nathmo/running_robot/controller/fixed_gait/README.md

# fixed_gait — web control UI, teach/replay and workspace calibration

The hardware-side scripts for DASH-01. What runs on the robot today is the Flask web control UI in
[`webui/`](webui/README.md) (dashboard, balance loop, policy runs through `../deploy/`); the flat
scripts next to it are the numpy-only modules the UI imports, which also still work standalone from
a terminal on the Pi.

The original analytic in-air gait demo (`gait.py`, `run_hardware.py`, `sim_fixed_base.py`,
`validate_gait.py`, `view_trajectory.py`) was removed on 2026-09-30 — the web UI superseded it. It
lives in git history; comments that cite `run_hardware.py` refer to that version.

---

## Motor map

`can0` = **RIGHT** leg, `can1` = **LEFT** leg. CubeMars IDs on each bus:

| joint | role | motor ID | left bus | right bus | sim actuator |
| --- | --- | --- | --- | --- | --- |
| abduction | hip roll (lateral) — held at home for straight walking | **104** | can1 | can0 | `hip_roll_{L,R}` |
| cam | drives the knee through the parallel pushrod loop (leg extend/retract) | **105** | can1 | can0 | `cam_{L,R}` |
| hip | fore/aft thigh swing (the visible stepping motion) | **106** | can1 | can0 | `thigh_{L,R}` |

The knee and ankle are **passive** (parallel linkage + spring); they follow the cam and are not
commanded. The right leg is the geometric mirror of the left, so its joint signs are negated.

---
## Map the safe workspace (once, before running on real hardware)

The URDF/MJCF joint ranges for `cam` and `thigh` are CAD-derived guesses, not validated hardstops —
and worse, cam and thigh aren't independent: they drive a closed 4-bar loop through the passive
pushrod + knee, so only a thin, non-rectangular **band** of (cam, thigh) combinations is
mechanically assemblable (see `../model/plot_reachability.py`). A per-joint min/max box is provably
wrong for that pair. `calibrate_workspace.py` backdrives the real leg by hand and derives the safe
region straight from what you actually swept, instead of trusting the CAD ranges:

```bash
python fixed_gait/calibrate_workspace.py --leg left     # backdrive LEFT leg (can1), a few segments
python fixed_gait/calibrate_workspace.py --leg right    # backdrive RIGHT leg (can0)
```

Same limp-motor technique as the teach recorder below (`SET_CURRENT 0`, so you move the leg by
hand while positions are logged):

- **SPACE** — start/stop a recording segment. Move whatever you're calibrating through its FULL
  physical range during a segment — e.g. one segment sweeping abduction stop-to-stop, another
  sweeping the knee (cam+thigh together, hugging its limits AND wandering the interior). As many
  segments as you like.
- **z** — capture the current pose (all 3 raw motor angles) as this leg's zero reference (pose the
  leg at the same nominal stance you use as "home" elsewhere first). Only used for the origin
  marker / readable angles in the plot — the stored limits themselves are absolute raw motor
  degrees.
- **u** — undo the last segment, **q** — finish: saves raw samples, derives the safe workspace,
  and writes `fixed_gait/calibration/workspace_summary.png` (abduction range + a knee scatter plot
  showing the demonstrated (cam, thigh) samples and the derived safe region).

This produces `fixed_gait/calibration/joint_limits.npz`, loaded by `joint_limits.py` — a small
numpy-only module that `play_trajectory.py`, `record_trajectory.py` and the web UI all use
to reject/flag out-of-envelope motor angles. Re-tune the safety margin or grid resolution without
re-recording: `python fixed_gait/calibrate_workspace.py --process-only --margin-deg 4`. Try the
whole pipeline with fabricated data first (no hardware/CAN needed): `... --selftest`. Until you've
calibrated a leg, the other scripts run exactly as before (no calibration file = no check).

---
## CAN bring-up (Raspberry Pi)

```bash
pip install -r requirements-rpi.txt
sudo ip link set can0 up type can bitrate 1000000     # RIGHT leg
sudo ip link set can1 up type can bitrate 1000000     # LEFT leg
```

The CAN protocol (servo-mode `SET_POS`, big-endian int32 × 10000; `SET_CURRENT 0` to release) is
copied verbatim from the tested `tools/ak_servo_sweep.py`.

---

## Record & replay your own gait (teach mode)

You can **move the leg by hand** to teach a trajectory, then
play it back — starting slow and gentle, then faster/stronger. This path is safer for first
motion: the recorder never drives the motors, and the player has a hard torque (current) cap.

### 1. Record (motors stay limp — you backdrive them)

```bash
python fixed_gait/record_trajectory.py --leg right     # RIGHT leg (can0), a few takes
python fixed_gait/record_trajectory.py --leg left      # LEFT  leg (can1), a few takes
```

The three motors are held **limp** (`SET_CURRENT 0`) so you can move them by hand while positions
are logged. In the terminal:

- **SPACE** — start / stop a take. Move the leg through **one full cycle** (start pose → step →
  back to start). Do a few takes; they're averaged.
- **c** — capture the **current pose as this leg's center** (its origin / mid-stance, and the
  abduction hold angle). Pose the leg where you want the gait centered, then press `c` once — do
  this before or between takes, whenever the leg is sitting where you want "home" to be. If you
  never press it, the recording's own mean pose is used instead.
- **u** — undo the last take, **q** — finish.

If `fixed_gait/calibration/joint_limits.npz` exists (see "Map the safe workspace" above), the live
status line flags `⚠ OUTSIDE CALIBRATED WORKSPACE` when the pose you've backdriven to falls outside
it — informational only (the motors are limp here, nothing to abort), a nudge that you've pushed
past a previously-mapped stop.

You don't need to be precise — being off by a few cm/deg on the return is fine, the loop is
**closed for you**. The **abduction** motor (id 104) doesn't need to move; it's held at the
captured center. Each leg is recorded and processed **independently** — the two legs' motors have
different origins and don't move as a clean mirror of each other, so there's no cross-leg
alignment or sign-guessing; the left leg replays exactly what you taught it, in its own frame.

When both legs are recorded it **auto-smooths and exports**:
`trajectories/gait_recorded.npz` (+ a `gait_recorded.png` preview). Re-smooth anytime without
recording: `python fixed_gait/record_trajectory.py --process-only`. Useful flags:

- `--split 0.5` — the fraction of the cycle given to the "outbound" (hip-max → hip-min) arc,
  **shared by both legs**, so a step out and the return each take the same portion of the period on
  both legs, independent of how fast you happened to move your hand while teaching it.
- `--left-phase 0.5` — the left leg's dephase (0.5 = 180°); pass `0.0` if the legs should move
  together instead of alternating.

**What the smoothing does now** (`trajectory.py`): resamples each take to one cycle, finds that
leg's two turning points (hip max/min) and **re-times** the cycle so the outbound and return arcs
each fill a fixed share of the phase (`--split`) — this removes any timing quirks from your hand
speed while keeping the taught shape *within* each arc. Multiple takes of the same leg are averaged
(they land on the same phase grid automatically, anchored on the turning points), then FFT
low-pass smoothed and loop-closed. Each side keeps its **own** shape, center, and clip range —
nothing is shared or mirrored between legs except the timing schedule and the phase offset.

### 2. Play it back — two control modes (`--mode`)

| `--mode` | who runs the position loop | CAN command | torque cap | when |
| --- | --- | --- | --- | --- |
| `current` (default) | **Python PID on the Pi (200 Hz)** | `SET_CURRENT` | **yes** (`--current-limit`, A) | safe first motion, compliant |
| `position` | the **motor controller** | `SET_POS` | no (drive's preset only) | crisp tracking once you trust it |

```bash
# CURRENT mode (torque-limited PID, default):
python fixed_gait/play_trajectory.py --dry-run                                  # print targets, 0 A
python fixed_gait/play_trajectory.py --period 8 --current-limit 3 --kp 0.8 --ki 0.4 --log
python fixed_gait/play_trajectory.py --period 4 --current-limit 6 --kp 1.5 --ki 0.8 --kd 0.03

# POSITION mode (drive runs the loop — no kp/ki/kd/current-limit; a tracking-error guard applies):
python fixed_gait/play_trajectory.py --mode position --period 8 --log
python fixed_gait/play_trajectory.py --abduction-right 5 --abduction-left -3    # set abduction hold
```

Each motor runs a software **PID** loop whose output current is **hard-clamped to
`--current-limit`** (Amps — Kt/Nm isn't known exactly), so torque can never exceed it:

```
current = kp·err + ki·∫err + kd·(target_vel − actual_vel),   clamped to ±limit
```

- **`--kp`** — stiffness. *This is the "stricter tracking" knob.* Too low and the leg lags, then
  friction makes it stick-slip (jagged/twitchy) — which is what you saw (only ~2 A pulled even at a
  20 A limit). Raise `kp` until tracking is crisp.
- **`--ki`** — removes the steady lag from gravity/friction (integral, with anti-windup). No gravity
  feedforward yet; the integral does that job.
- **`--kd`** — damping; uses `target_vel − actual_vel` so it tracks the *moving* trajectory instead
  of braking against it. Add a little only if it oscillates.
- **`--period`** seconds per cycle (bigger = slower). **`--log`** saves a target-vs-actual +
  current plot (`trajectories/last_run.png/.npz`) — run it, look at the lag, adjust gains, repeat.

**Speed governor (no more runaway crashes).** Instead of hard-cutting at 5000 ERPM (which tripped
on a normal fast move), the controller now tapers the *accelerating* current as a motor nears
`--speed-limit` (default 9000 ERPM), so speed **saturates** there smoothly — braking current is
never limited. `--max-speed` (default 16000) is only a last-resort runaway net, well above the
governor. Raise `--speed-limit` to allow faster moves, lower it to keep things gentle; `--speed-limit 0`
disables the governor. The live readout shows `maxSpd` so you can see where you're running.

**Tuning recipe:** start `--kp 0.4 --ki 0 --kd 0 --period 10 --current-limit 3`; raise `kp` until
tracking is tight without buzzing; add `ki` to kill the remaining lag; add a touch of `kd` only if
it oscillates; then shorten `--period` and raise `--current-limit` for speed. Both legs run dephased
180°, soft-start from the current pose, release on Ctrl+C; guards cut on runaway/over-temp/error.

Every target is checked against `fixed_gait/calibration/joint_limits.npz` (see "Map the safe
workspace" above) before it's sent — `--no-workspace-check` disables that guard for a run
(debugging only; the other cuts above still apply).

---

## Files

| file | what |
| --- | --- |
| `webui/` | the Flask web control UI and its daemon — see [webui/README.md](webui/README.md). |
| `record_trajectory.py` | **teach recorder** — backdrive a leg by hand, SPACE-toggled takes; auto-smooths + exports. |
| `trajectory.py` | pure-numpy per-leg smoothing + shared-schedule re-timing + close-loop; independent per-side calibration (own shape, captured center, clip range); shared by record & play. |
| `play_trajectory.py` | **replay** a recorded trajectory, both legs dephased 180°; tunable current-**PID** with an Amp torque cap, `--log` tracking plot. |
| `calibrate_workspace.py` | backdrive a leg by hand to map its SAFE workspace (abduction min/max + a (cam,thigh) occupancy grid); exports `joint_limits.npz` + a summary plot. |
| `joint_limits.py` | pure-numpy safety-check module (loads `joint_limits.npz`); used by `play_trajectory.py`, `record_trajectory.py` and the web UI. |
| `trajectories/` | recorded takes + exported `gait_recorded.npz` (+ preview png, tracking logs). |
