nathmo/running_robot/controller/tools/README.md

sudo ip link set can0 up type can bitrate 1000000
sudo ip link set can1 up type can bitrate 1000000

to init CAN bus on raspberry pi

104 = abduction (polling 200Hz)
105 = cam
106 = hip

scp -r nemo@100.127.143.113:running_controller/fixed_gait* "C:\Users\Nathann\Downloads\running_robot\fixed_gait"
