nathmo/running_robot/controller/fixed_gait/webui/README.md

# DASH-01 web control interface

One Flask app, served **on the robot's Raspberry Pi**, reachable from any phone/laptop on the
robot's WiFi hotspot. No internet needed at runtime — every asset is served locally.

```
python controller/fixed_gait/webui/server.py          # real robot (socketcan can0/can1)
python controller/fixed_gait/webui/server.py --mock   # simulated motors — try the UI on any machine
python controller/fixed_gait/webui/server.py --port 8080 --host 0.0.0.0
```

Then browse to `http://<robot-ip>:8080/` (on the hotspot, the Pi's own address).

What it does (one page):

| Panel | Function |
|---|---|
| Telemetry | live raw/normalized position, current, temperature per motor + strip charts |
| Sense HAT (B) | live 9-DOF IMU (attitude horizon, accel/gyro/mag), air temperature/humidity/pressure, ambient light/colour, 4 analog inputs, and the **gyro calibration** (upright reference, gyro zero, a four-tilt axis sequence with flips, a still-robot noise recorder, 3D frame view) — see below |
| Calibration wizard | **blocks all motion after boot** until zero pose + direction check are done |
| Manual control | per-actuator slider that **tracks the live motor position** (grab to jog) + exact-angle box; **🏠 Home** slowly drives both legs to the **standing pose** (soles flat, CoM over them; `daemon.STAND_POSE_DEG`, from `tools/solve_stand_pose.py`) and **⌖ Centre** parks both legs where the safe workspace leaves the most room in every direction (the largest inscribed box — the pose to excite from); per-actuator sine (start↔stop **preset to 70% of the safe range**, frequency); workspace-override checkbox |
| ⚖ Balance | manual panel, after 🏠 Home: IMU loop around the standing pose (`balance.py`) — pitch P+D shift the CoM along the soles and I levels the torso, roll P+D shift the CoM sideways; CoM fore/aft + lateral trims; Stop holds, a >15° tilt goes limp. Tested in `tools/balance_sim.py` (MuJoCo, measured SET_POS lag): survives zero errors ~0.75° (vs 0.5° without) and 49 N side pushes (vs 45), but no posture loop beats ~8 N/0.2 s fore-aft on 66 mm soles |
| Safe workspace | abduction bar + (cam, thigh) pixel editor — draw/erase/flood-fill, undo, save/export/import |
| Gait trajectory | hand-**draw** a path, or **teach** by backdriving (record takes), smooth + save |
| Digital twin | the homing-pose MJCF rendered in the browser (WebGL), posed live from the six motors — backdrive the robot and the twin follows; also plays the gait preview, and a policy's dry run |
| Playback | position or torque-capped current mode, speed (period) + left/right dephasing live |
| E-STOP | header button (hotkey: Space) — streams zero current, latches until cleared |

## Why the calibration wizard exists

The CubeMars encoders report a **random angle (and possibly inverted direction) after every power
cycle**. The app therefore refuses any motion until you:

1. pose the robot in its **URDF zero pose** and press *Set zero* (motors are limp), then
2. backdrive each joint in its positive direction and *Confirm* (or *Flip*) its sign.

Everything the app stores (workspaces, gaits, zero) is in this **normalized frame**
(`norm = sign · (raw − offset)`), so recordings survive reboots. Legacy files from
`calibrate_workspace.py` are converted on import using the zero captured in their session
(`z` key) — files without a stored zero cannot be normalized and are refused.

After a **server** restart the calibration is restored from disk with a warning banner: it is only
valid if the motors were NOT power-cycled in between. Re-zero when unsure — it never invalidates
saved data.

## The digital twin (2026-09-21)

The panel draws `dash-01CAD/homing/SpiderBotInitPos/SpiderBotInitPos.xml`, the CAD exported in
the **homing pose the drives are zeroed in**. So the joint map has no offsets, only a sign per
motor: `qpos = radians(sign · norm°)`. Publish (or re-publish after a CAD change) from the desktop,
then copy to the Pi:

```
python controller/fixed_gait/webui/tools/build_twin.py        # -> static/twin/ (torso decimated, 7 MB)
scp -r controller/fixed_gait/webui/static/twin nemo@<pi>:running_robot/controller/fixed_gait/webui/static/
```

* **Parsed in the browser** (`static/twin3d.js`, no libraries): the XML is copied verbatim.
* **Signs** are derived from the wizard's convention (thigh + forward, cam + crank down, abduction
  + outward, both legs) and the MJCF axes: L abd/cam/thigh = +1/+1/−1, R = −1/−1/+1 (the right
  sagittal axes are −y). `tests/test_twinmap.py` re-derives them from the published XML. They
  can be overridden in the panel (`data/twin_map.json`, display only).
* **The four-bar.** The export duplicates one body per leg to express the loop; the deeper copy
  is dropped. The pin is 389.0 mm down the pushrod, which lands on the foot's bore at 0.00 mm
  lateral miss. It is solved in closed form, on the branch the CAD was assembled in. Homing is
  only 5 mm from full stretch (dead centre), so a zero that is a degree or two off can ask for a
  pose that doesn't exist. The leg then turns orange and draws its closest pose, and the gap is
  shown under the canvas.
* **The base follows the IMU** (pitch and roll from the attitude filter; yaw stays 0 because it
  drifts). It turns about the torso origin, which never moves, so the robot can only rotate
  against the fixed yellow world marker (level ring, plumb line, a ring at foot level) and the
  world triad; paler axes turn with the body. Needs a calibrated mount without a conflict, and
  can be switched off in the panel.
* **Three sources, in this order:** the gait preview (an explicit toggle, so it wins), then a
  **dry run**, then live telemetry. The line under the canvas names whichever is on screen.
* **A dry run moves it** (2026-09-23). A dress rehearsal runs the whole control law against a mock
  bus, so the robot stays limp and the live telemetry underneath is a still picture — the log tail
  used to be the only evidence it produced. `run_policy.py --pose-file` now publishes the
  **commanded** joint angles as JSON at 20 Hz, the server passes it on every rehearsal, and the
  panel polls `/api/policy/rehearse/pose` at 10 Hz and hands them here. What you see is the pose
  the policy is *asking for*, not what the mock drives report: the mock plant is a first-order lag
  with noise, the command is the thing under test. Nothing is energised; the base tilt is still the
  real IMU's. The poll self-schedules (a slow link lowers the frame rate instead of queueing
  requests), the pose is dropped once it is a second old, and the runner removes the file when the
  run ends. Off with **drive the digital twin** in the rehearsal row.

## The FK lookup table (workspace EE paths)

No longer drawn by the UI (the twin replaced the 2D linkage view); the server still uses it for
the gait files' `ee_path`. `fk_lut.npz` is generated **on the desktop** (needs mujoco, the Pi doesn't have it):

```
python mujoco/dash01/gen_fk_lut.py --check
```

It Newton-solves the closed 4-bar at every (cam, thigh) grid cell via
`mujoco/dash01/plot_reachability.py` and stores all linkage node positions. The Pi only
bilinearly interpolates it. After loading/importing a workspace, press **“verify FK map
(sign + offset)”** in the EE panel once: per side and per sign combination it FITS the offset
that lands the workspace band on the LUT assembly band (thin diagonal ⇒ sharp fit) and enables
the EE display per leg only when the winner is decisive.

> **Two zero poses — resolved (2026-07-11).** The robot's captured zero pose is NOT the model's
> qpos-0 pose, so the map is `model° = sign·norm° + offset°` per side. Two facts, both verified
> against recorded data:
> 1. **The cam is a crank.** The 4-bar assembles at EVERY cam angle (checked by sweeping loop
>    closure over the full circle); the MJCF's ±86° cam range is a CAD guess. The LUT is now
>    generated over cam ∈ [−90°, +270°] (`gen_fk_lut.py` default), which is why the old sign-only
>    verify failed (17% coverage): most of the real ~245° cam travel fell off the old grid.
> 2. **The captured zero sits far from model zero.** The zero pose is taken with the leg
>    near-extended — exactly the 4-bar dead-center, where big cam rotations barely move the leg —
>    so the captured cam zero is unrepeatable and lands far from model cam 0 (fitted ≈ +135° on
>    `joint_limits.npz`, both legs consistent, coverage 1.00 vs ≤0.95 for wrong signs). The EE
>    panel shows both: ○ = calibrated zero, ◆ = URDF/model zero.
>
> All recordings map onto the same model window (cam ≈ [−64°, +183°]) — that window is the real
> hard-stop travel expressed in model coordinates. `data/model_map.json` stores signs + offsets
> and can still be hand-edited / force-enabled in the UI.

## Drive control loops (read off the motor driver boards, 2026-08-04)

This app closes **no** control loop. `canio` speaks CubeMars servo mode — `SET_POS` and
`SET_CURRENT` only — so the drives close everything with their own three cascaded loops. These are
their configured gains, recorded in `dynstore.DRIVE_GAINS` and shipped with every measurement run so
a capture is self-describing. They are **not settable from here** (no gain-write packet; use the
CubeMars tool), and editing the PID table in the UI changes nothing on the robot.

| group | motors | current kp / ki | speed kp / ki | position kp / ki / kd |
|---|---|---|---|---|
| left sagittal | `left.cam`, `left.thigh` | 0.1255 / 1704.8199 | 0.002 / 0.1 | 0.003 / 0 / 0 |
| right sagittal | `right.cam`, `right.thigh` | 0.2066 / 2544.6150 | 0.002 / 0.1 | 0.003 / 0 / 0 |
| abduction | `left.abd`, `right.abd` | 0.1190 / 2290.1199 | 0.002 / 0.06 | 0.009 / 0 / 0 |

"Thigh+Knee" on the driver board is a leg's **sagittal pair**: the knee is driven by the cam through
the pushrod, so cam and thigh share a board and a tune. Left and right current-loop gains differ
despite identical AKE90-8 motors — that is per-board autotuning against the real winding R/L, not an
asymmetry in the robot.

Two consequences worth remembering when reading identification data:

* **The position loop is P-only** (ki = kd = 0 on all six). A pure proportional loop droops under a
  constant load, so a joint holding against gravity settles *short* of its target by roughly
  (gravity torque / gain). That is a systematic bias in a quasi-static run, not noise.
* **Abduction is ~3x stiffer** than the sagittal axes (kp 0.009 vs 0.003), so it droops ~3x less.

## Sense HAT (B) — the sensor panel

The Waveshare **Sense HAT (B)** sits on the Pi's 40-pin header and answers on **I2C bus 1**. The
chips are read by background threads of their own (`sensehat.py`), never by the Flask handlers and
never by the CAN daemon — an I2C stall must not be able to delay a motor command.

**Two threads, split by timescale.** The IMU polls at `--imu-hz` (200 by default, matching the
control loop); the air/pressure/light/ADC chips run at 1-5 Hz on a second thread. That split is not
tidiness: those drivers spend nearly all their time *asleep* waiting for a conversion (the SHTC3
alone sleeps 15 ms), which inline cost the fast loop ~43 ms every second — about 8 missed ticks —
and capped it at ~192 Hz. Out of the way, the IMU thread holds **199.5 Hz**.

| Address | Chip | Published |
|---|---|---|
| 0x68 | ICM-20948 | accel (g), gyro (deg/s), die temperature; magnetometer via the AK09916 at 0x0C |
| 0x70 | SHTC3 | air temperature, relative humidity |
| 0x5C | LPS22HB | barometric pressure + its own die temperature |
| 0x29 | TCS34725 | ambient light (lux), correlated colour temperature, raw RGBC |
| 0x48 | ADS1015 | AIN0..AIN3, volts (one channel per tick) |

Measured on the robot (100 kHz I2C, at rest, DLPF cfg 3):

| | accel | gyro |
|---|---|---|
| range / resolution | ±4 g, 0.1221 mg/LSB | ±1000 dps, 0.0305 dps/LSB |
| 3 dB bandwidth | 50.4 Hz | 51.2 Hz |
| noise (RMS) | 1.8 mg (~218 µg/√Hz) | 0.08 dps (~0.0096 dps/√Hz) |
| bias | scale error −0.03% | turn-on ~1 dps; 0.011 dps/s in-run |

Quantisation sits ~15x below the noise floor on both, so widening the ranges costs nothing real if
footfall impacts start clipping ±4 g. Sensor ODR is 225 Hz (`SMPLRT_DIV` derived from `ODR_HZ`); an
accel+gyro burst costs 1.68 ms and the magnetometer ~1 ms, hence the mag's decimation to 25 Hz.
The panel publishes the rate the IMU thread actually achieves, not the one it was asked for.

```
python controller/fixed_gait/webui/sensehat.py          # CLI self-test: one live line per second
python controller/fixed_gait/webui/sensehat.py --mock   # synthetic values, no hardware
python controller/fixed_gait/webui/server.py --no-sensors   # do not touch I2C at all
```

Things worth knowing before trusting a number here:

* **Roll and pitch are absolute** (a 6-axis Madgwick filter references them to gravity); **yaw is
  gyro-integrated and drifts.** The magnetometer is deliberately *not* fused into the attitude —
  it sits centimetres from two brushless motors and the battery, so its heading is published as an
  advisory number only.
* **Values are in the IMU chip's own frame until the mount is calibrated** (below), and in robot
  body axes after. The HAT is bolted UNDER the robot — it reads gravity on chip −Z — so the two
  frames are nowhere near each other and the difference is not cosmetic.
* Missing HAT, missing `smbus2`, or I2C disabled → the panel shows the reason and the rest of the
  UI is unaffected. Per-chip failures are counted and shown, not silent.

### Gyro calibration — upright, zero, axes, noise

`mountcal.py` (the frame, persisted to `data/sensehat_mount.json`) and `sensehat.py` (the captures,
the sequence and the recorder); panel block "IMU mount & frame". Every step that moves the frame is
refused while ⚖ Balance runs on it.

**Step 1 — upright reference.** Hang the robot on the test rig in its upright pose and capture.
This measures the direction of gravity in chip axes, which fixes the tilt. It does *not* separate
accelerometer bias from mount misalignment — a robot tilted 1° and a sensor with a 17 mg cross-axis
bias read identically — and it does not need to: both are absorbed into the frame in which the
reference pose reads roll = pitch = 0. **The repeatability of that pose is the accuracy ceiling of
everything downstream.**

**Step 2 — zero gyro.** Averages the zero-rate offset for 1.5 s with the robot still, and refuses
if it moved (it says so rather than storing a bad bias). Redo it once the robot is warm.

**Step 3 — axes: the tilt sequence.** Gravity fixes only *two* of the three rotation DOF: rotation
about the vertical is invisible to an accelerometer at rest, and that is exactly the DOF separating
**pitch from roll**. Press ▶ Start, then tilt the robot **forward, left, right, backward**, 10–20°
each and back upright in between. Each tilt is **captured on its own** (both hands are on the
robot): back within 4° of upright arms the next step, and a tilt of ≥ 8° held with the gyro under
2°/s for 0.3 s starts the usual 1.5 s still average. Each tilt gives one direction — the horizontal
swing of the up-vector — and only the direction is used, never the angle.

Four tilts over-determine the heading, so they check themselves:

* forward and backward must point opposite ways, so must left and right (a pair that points the
  *same* way was tilted wrong, and is left out of the fit);
* the fore/aft pair must sit at a right angle to the left/right pair **on the right-handed side**.

The panel then shows the result as chip axes (`forward = chip −X …`) with the per-tilt fit
residuals, and two **flip** buttons that negate what a pair is taken to mean. A rotation cannot flip
one horizontal axis alone — that would be a mirror — so flipping *one* pair of a good calibration
shows a **conflict** instead of silently averaging it: the fore/aft pair then sets the frame alone,
and ⚖ Balance is refused until the pairs agree again (flip the other one too: the robot's front was
the other end). Any single tilt can be redone with its ↻ button.

A calibration from the old one-tilt procedure keeps working: it is loaded as a forward tilt and the
panel says it is an old capture until the sequence is run.

**Step 4 — noise.** ● Record while the robot stands still, ■ Stop & analyse: accel and gyro noise
(RMS and density, using the chip's DLPF noise bandwidth), what is left of the gyro zero, the 1 s
wander, and the pitch/roll jitter the ⚖ Balance loop steers on. The record is judged by the same
stillness gate as `tools/imu_bench.py` (both use `imunoise.py`) and a record where the robot moved
is flagged as motion, not noise. The raw record goes to `data/imu_noise/imu_noise_*.npz` (same keys
as `imu_bench --save`, plus pitch/roll).

The 3D view shows the base mesh, the body triad and the chip's own axes as the calibration places
them, plus the live measured up-vector — the visual check that the calibration says what you think
it does. The **digital twin** tilts its base by the same pitch and roll (see *The digital twin*).

**Changing the mount resets the attitude filter.** A filter's quaternion is expressed in the frame
it was integrated in and is meaningless the moment that frame moves — and a near-antipodal Madgwick
error sits on a saddle where the correction vanishes, so it never converges out on its own. Without
the reset, finishing the wizard left the attitude stuck ~165° wrong.

In `--mock` the HAT is simulated with a known mount; the mock-tools panel poses it (upright, tilt
forward / left / right / backward), and the sequence recovers the mount (`tests/test_mountcal.py`).

(The lever-arm compensation — IMU offset from the base centre, CAD or fitted by rocking — was
removed on 2026-09-21: it was never configured on the robot.)

## Black box (flight recorder) — `blackbox.py` / `blackbox_read.py`

On 2026-08-10 a joint destroyed itself and the investigation was impossible: the only telemetry
that existed was a 4096-sample RAM ring at 20 Hz, of which the HTTP API can only ever hand out the
last 512 (25.6 s), and nothing on disk. By the time anyone looked the window had rolled past.

Everything now lands in `data/blackbox/`, always on, in three tiers — because 200 Hz x 6 motors
streamed continuously is 35 kB/s, 3 GB/day, and that kills the SD card:

| tier | what | rate | file |
|---|---|---|---|
| A | continuous history, every field | 20 Hz | `A_<session>_<n>_<stamp>.bbseg` (rotated, budgeted) |
| B | the actual black box: the full-rate RAM ring dumped on a trigger, **pre-trigger history included** | 200 Hz, 40 s ring + 3 s tail | `B_<session>_<n>_<reason>.bbdump` |
| C | one JSON line per event, `fsync`ed, never deleted without archiving | — | `events.jsonl` |

Tier B triggers: every `_trip()`, e-stop, mode transition, a *warn*-level tracking error / speed /
temperature (below the trip thresholds, so the dump catches the approach and not only the fall),
any motor error code, any calibration or `dynstore` write, an encoder-origin jump, and the manual
"dump now" endpoint. A dump carries the calibration + drive gains + dynamics live at that instant,
with a content hash, so it is self-describing without external context.

**The control loop is not touched.** The 200 Hz thread only appends a tuple to a bounded deque (no
lock, ~2 us); a separate writer thread owns every file. A full queue **drops and counts**, and the
count is stamped into the next accepted record — a black box that lies about its own gaps is worse
than none. If the writer thread dies the robot keeps running and `state.blackbox.alive` goes false
in the UI.

**Time.** The Pi has no RTC and serves an AP with no guaranteed internet, so `t_wall` can be years
wrong. Every record carries `t_mono` (the primary base), `t_wall`, `wall_trusted`, a per-boot
`boot_id` and a per-run `session_id`. A `clock.step` event records the jump when NTP finally syncs,
so earlier stamps can be retro-corrected. **Power-off is inferred from the last heartbeat** (every
8 s) before a gap — the process that dies with the power cannot log its own death.

**Disk.** A global byte budget (default 1.2 GB, `--blackbox-budget-mb`) plus a free-space floor.
Oldest Tier A segments are deleted first; Tier B dumps and the event log are the evidence and go
last. Every deletion is logged. A full SD card can never stop the robot.

### Reading it back

```
python controller/fixed_gait/webui/blackbox_read.py --postmortem      # the five questions, answered
python controller/fixed_gait/webui/blackbox_read.py --list
python controller/fixed_gait/webui/blackbox_read.py --timeline 80
python controller/fixed_gait/webui/blackbox_read.py --dump B_xxx.bbdump --csv out.csv
```

`--postmortem` answers, from disk alone: when the Pi booted and when it last lost power; what
`pos_raw` was at the last zero capture versus now; commanded vs reported position per motor at
200 Hz for >= 10 s *before* a trip; which calibration / drive PID gains / dynamics were live at
that instant; and whether `pos_raw` ever moved while the robot was LIMP and untouched.

Over HTTP: `GET /api/blackbox/list`, `GET /api/blackbox/download?name=`,
`POST /api/blackbox/mark` (operator annotation — it lands on the same timeline) and
`POST /api/blackbox/dump`. Downloads are plain reads of append-only files, so they never block the
daemon.

### The pre-move guard

The 2026-08-10 damage was a full-authority absolute slew against a calibration whose raw origin had
moved underneath it. Four mechanisms now bound that, and **none of them adds a step to the normal
zero -> Home workflow** — homing straight after a capture is the correct operator action, because
the legs are limp and sagging and homing is what catches them:

a. **Hold before moving.** The first CAN command after leaving LIMP is `set_pos(pos_raw measured
   right now)`, held for 0.35 s. It never consults the offsets, so it is safe even against a
   completely wrong zero, and it stops the sag immediately.
b. **Raw-at-rest.** `pos_raw` is compared against the fingerprint captured at the last zero.
   Decisive when we cannot vouch for continuity ourselves — a calibration restored from disk and
   never re-captured in this process, i.e. after a power cycle, where the drives re-randomise their
   raw origin. Within a live session the continuity watchdog is used instead, because gravity sag
   legitimately moves the joints and must not be mistaken for an origin jump. Plus a range-sanity
   check that is decisive in every case: 678 deg on a +-88 deg axis is refused.
c. **A tighter tracking threshold while homing** (8 deg, not the 25 deg playback value): a slow
   guided slew should track well, so a stale zero shows up within the first few degrees.
d. **A per-joint travel budget** as the backstop: a guided move that has swept more than 1.3x the
   joint's own range without arriving is stopped. `left.cam` reached ~1.9 output turns on
   2026-08-10; this cuts it at ~0.6 of a turn whatever the calibration claims.

A refusal is latched, surfaced in `state.premove` with both raw poses, logged, and dumped.

### Tests

```
python -m pytest controller/fixed_gait/webui/tests -v
```

MockBus only, no hardware. The last test reproduces the 2026-08-10 incident shape end to end:
capture a zero, move the raw origin underneath the daemon (`MockBus.shift_origin`, which shifts the
reported *and* commanded frame while the shaft stays put and reports zero speed), command an
absolute move — and asserts the guard refuses it, the event carries both raw poses, the dump holds
>= 10 s of pre-trigger 200 Hz data, and `--postmortem` states what happened.

## Install on the Pi (offline)

```
# on the desktop (internet):
pip download flask smbus2 -d wheels/
scp -r wheels nemo@<pi>:running_robot/

# on the Pi:
pip install -r requirements-rpi.txt          # if not already there (numpy, python-can)
pip install --no-index --find-links wheels/ flask smbus2
# smbus2 is pure Python, so if Raspberry Pi OS already ships it system-wide you can instead just
# drop it into the venv:  cp -r /usr/lib/python3/dist-packages/smbus2 .venv/lib/python3*/site-packages/
sudo ip link set can0 up type can bitrate 1000000
sudo ip link set can1 up type can bitrate 1000000
python controller/fixed_gait/webui/server.py
```

### Run at boot (two systemd units)

Bringing CAN up needs root (`CAP_NET_ADMIN`); the web UI does not. Splitting them keeps the
app running as the unprivileged `nemo` user, and keeps the interfaces up even if the app
restarts. **One** unit brings CAN up (root, oneshot), the **other** starts the UI (as `nemo`)
and waits for the first.

**1. CAN bring-up — `/etc/systemd/system/can-up.service`** (runs as root; no `User=`):

```
[Unit]
Description=Bring up CAN interfaces (can0/can1)
After=sys-subsystem-net-devices-can0.device

[Service]
Type=oneshot
RemainAfterExit=yes
ExecStart=/sbin/ip link set can0 up type can bitrate 1000000
ExecStart=/sbin/ip link set can1 up type can bitrate 1000000

[Install]
WantedBy=multi-user.target
```

**2. Web UI — ship the unit that is in the repo**, `systemd/runningrobot-webui.service`. It is
version-controlled precisely because the only surviving record of 2026-08-10 was a terminal that
happened to still be open; a hand-started process has no journal and no restart.

```
sudo cp controller/fixed_gait/webui/systemd/runningrobot-webui.service /etc/systemd/system/
```

It runs as `nemo`, waits for `can-up.service`, sets `PYTHONUNBUFFERED=1` so the journal never loses
the last lines before a crash, restarts always (bounded to 5 restarts / 60 s so a boot loop stays
down visibly instead of power-cycling the motors), and stops with `SIGINT` so `atexit` runs — that
is what streams 0 A to every motor and lets the black box write its clean `daemon.stop` record,
whose ABSENCE is how a postmortem infers a power cut.

Note `ExecStart` uses the venv's Python by absolute path — systemd runs no shell, so it won't
find `python` on `PATH` or activate a venv. Enable both:

```
sudo systemctl daemon-reload
sudo systemctl enable --now can-up.service runningrobot-webui.service
ip -details link show can0                     # confirm state UP, bitrate 1000000
systemctl status runningrobot-webui         # confirm active (running)
journalctl -u runningrobot-webui -f         # live logs
```

> Don't put `ip link set` in the webui unit's `ExecStartPre`: that step would run as `nemo` and
> fail with `RTNETLINK answers: Operation not permitted`. If you must keep it in one unit, run
> just that line elevated with the `+` prefix (`ExecStartPre=+-/sbin/ip link set can0 up …`).

## First hardware bring-up (in this order)

1. Legs held by hand: press **E-STOP**, verify motors are limp; clear it.
2. Unplug one motor: the app must flag it silent and refuse all motion.
3. Run the calibration wizard for real; sanity-check a normalized angle with a protractor.
4. Import yesterday's workspace (`fixed_gait/joint_limits_right_2.npz`) in the workspace panel.
5. Press *verify FK map (sign + offset)* — both legs should be decisive; the EE panels light up.
6. Small manual moves near zero with safety checks ON (override OFF). The sliders track the live
   position, so watch a joint follow your drag; then press **🏠 Home** and confirm all six slew
   back to zero at the (slow) home speed. Homing trusts the CAD zero: it slews under the physical
   feasibility net rather than the eroded gait polygon, so it still reaches 0 when 0 sits a degree
   or so outside the hand-drawn safe region (a plain manual hold at zero is refused there).
7. Record a workspace sweep + a gait via the UI; play it back slow in **position** mode
   (period ≥ 10 s), then try **current** mode with the 3 A default.

## Architecture (for maintenance)

**Two processes since 2026-08-19.** `server.py` (control, `:8081`) owns the daemon, CAN,
calibration and the black box. `uiproc.py` (front end, `:8080`) serves the browser and proxies
everything it does not build itself. They are separate *processes*, not threads, because the
problem was the GIL: measured with candump, the motors' own status frames arrived at 200.1 Hz with
0.04 ms jitter while the Pi's own transmit stream managed 156.6 Hz and dropped 21.6% of its slots —
stalls of >10 ms at 9.16/s against a browser polling at 9.1/s, one per request. `setswitchinterval`
was already 0.5 ms and `SCHED_FIFO` cannot preempt a thread holding the lock you need, so a second
interpreter was the only fix. `uiproc.py` carries the full measurement in its docstring.

Operator URL is unchanged (`:8080`). **If the front end dies, the whole UI including E-STOP is
still on `:8081`.** Running `server.py --port 8080` alone is the rollback and needs no code change.

- `daemon.py` — the only thread touching CAN (200 Hz; mirrors `play_trajectory.py`'s loop).
  Limp/e-stop = **streaming** `SET_CURRENT 0` (never just "stop sending"). All targets are
  workspace-checked as a full pose *before anything is sent*.
- `calibration.py` — normalized↔raw conversion at the daemon boundary only; legacy converters.
- `workspace.py` / `gaitstore.py` — normalized-frame stores wrapping `calibrate_workspace.py`,
  `joint_limits.py`, `trajectory.py` (files stay compatible with the CLI tools).
- `fklut.py` — pure-numpy LUT runtime + the sign-map verifier.
- `canio.py` — real socketcan or `--mock` simulated motors (random boot offsets included).
- `sensehat.py` — Sense HAT (B) I2C drivers + its own poll thread (100 Hz IMU / 20 Hz logged);
  `--mock` simulates a HAT with a known mount, posed upright or tilted. Also runs the auto-capturing
  tilt sequence and the noise recorder. Publishes a snapshot + a `ScalarRing`, same
  read-by-sequence contract as motor telemetry.
- `mountcal.py` — IMU mount rotation from the upright capture and the four tilts (fit, pair checks,
  flips), persisted to `data/sensehat_mount.json`. No I2C, no threads of its own.
- `imunoise.py` — the stillness gate and the noise analysis, shared by the panel's recorder and
  `tools/imu_bench.py`.
- `static/` — vanilla JS, no CDN. `server.py` — thin Flask routes.
- Runtime data lives in `webui/data/` (git-ignored, machine-local).
