nathmo/running_robot/controller/batterypackLayout.png

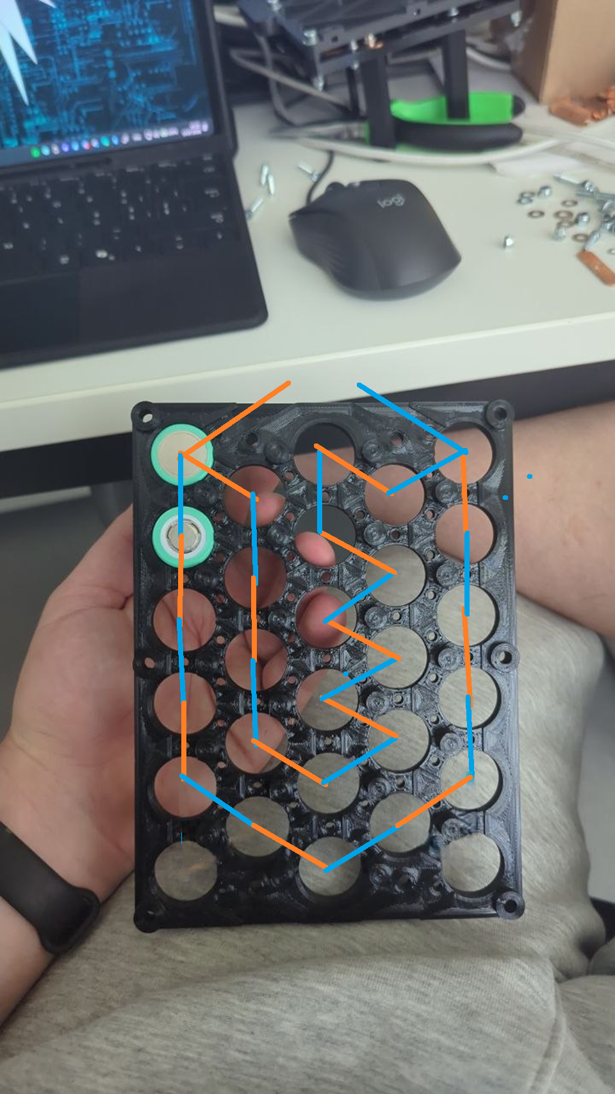
controller/batterypackLayout.png
