nathmo/running_robot/controller/fixed_gait/trajectories/gait_recorded.png

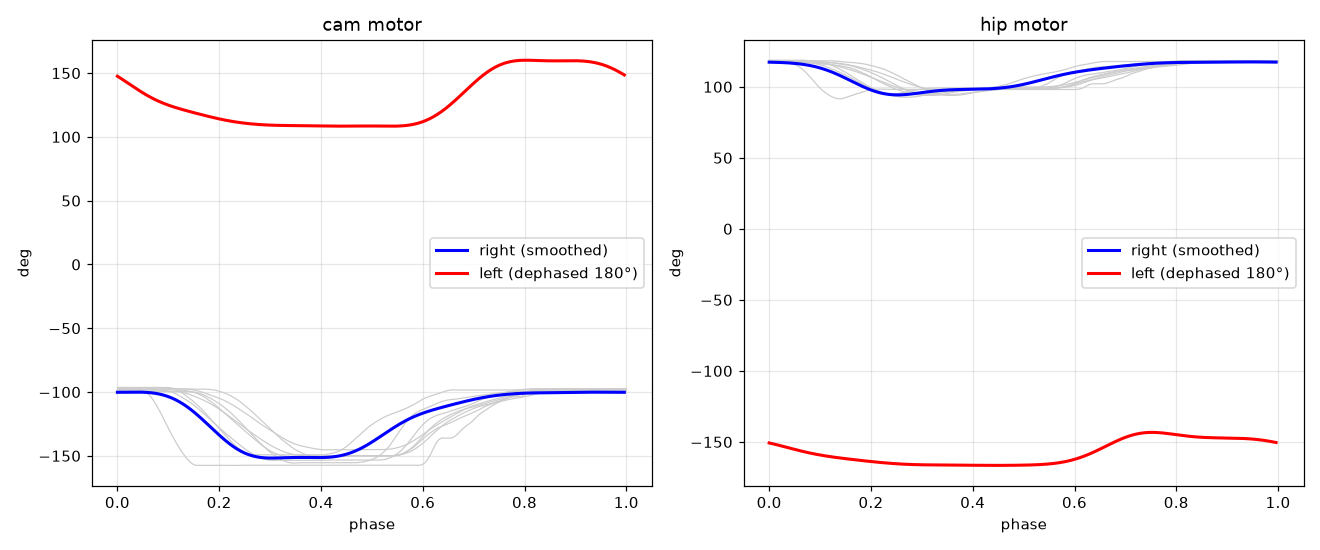
controller/fixed_gait/trajectories/gait_recorded.png
