nathmo/running_robot/controller/fixed_gait/trajectories/last_run.png

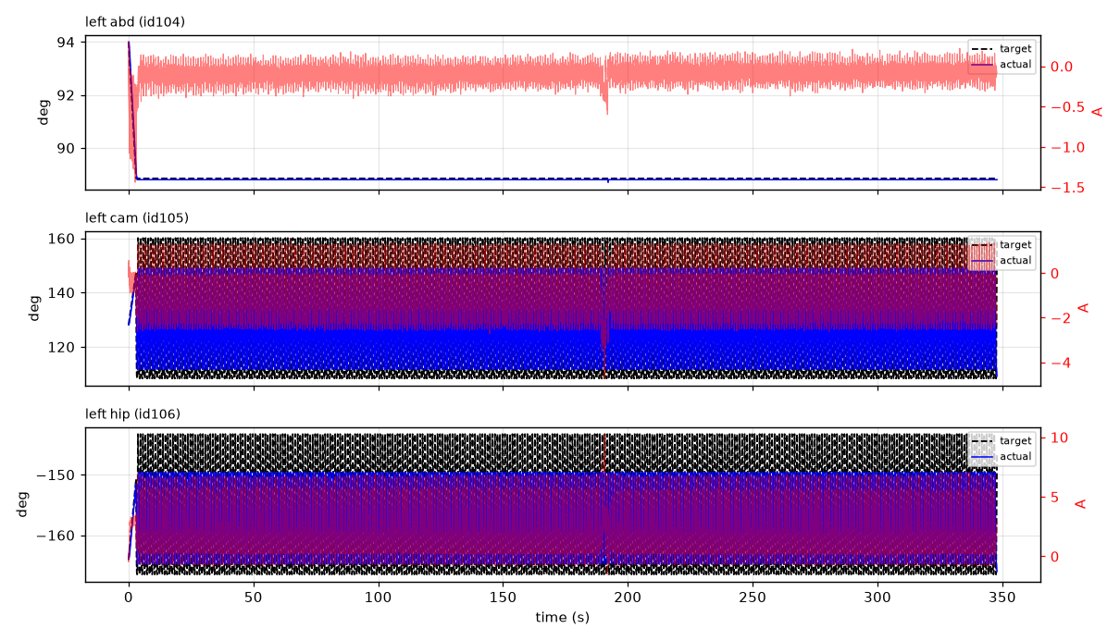
controller/fixed_gait/trajectories/last_run.png
