nathmo/running_robot/controller/fixed_gait/webui/tools/balance_sim_push.png

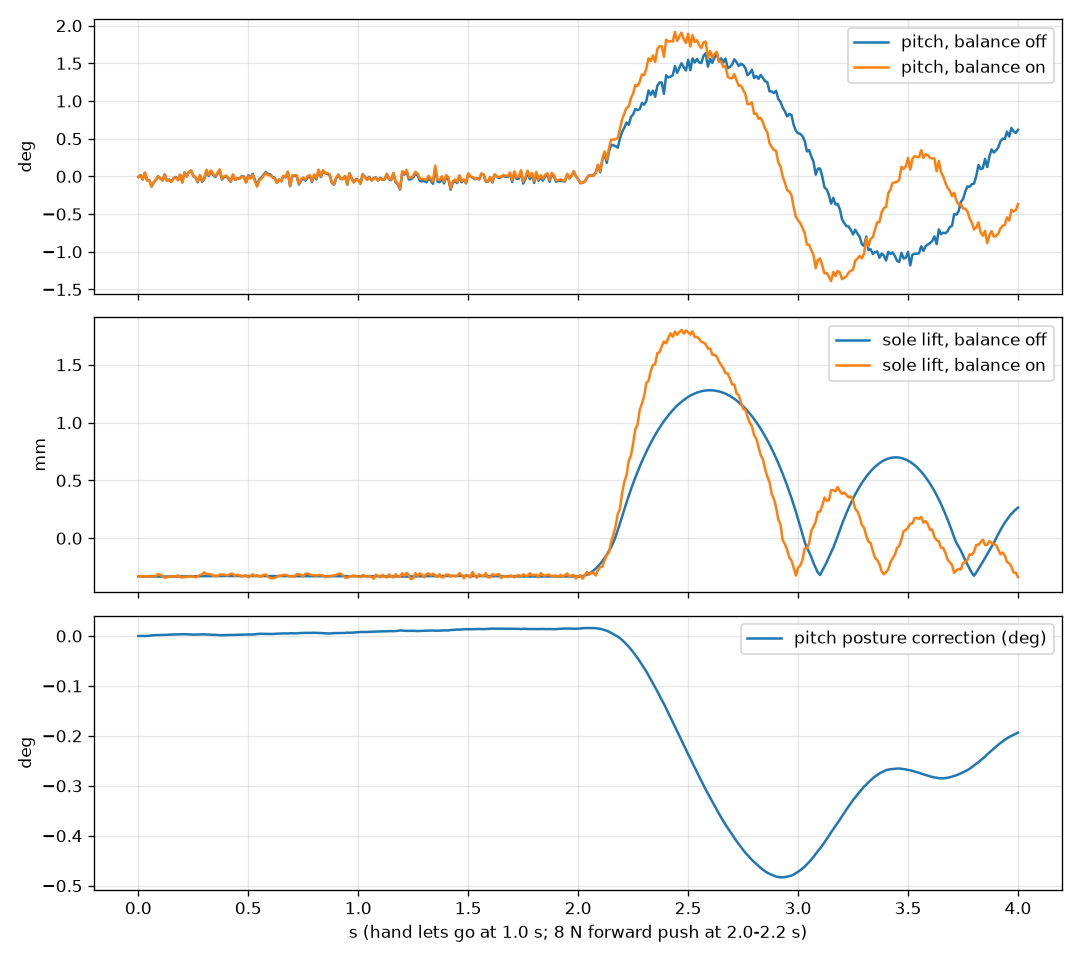
controller/fixed_gait/webui/tools/balance_sim_push.png
