nathmo/running_robot/controller/results/staged_chirp_concept.png

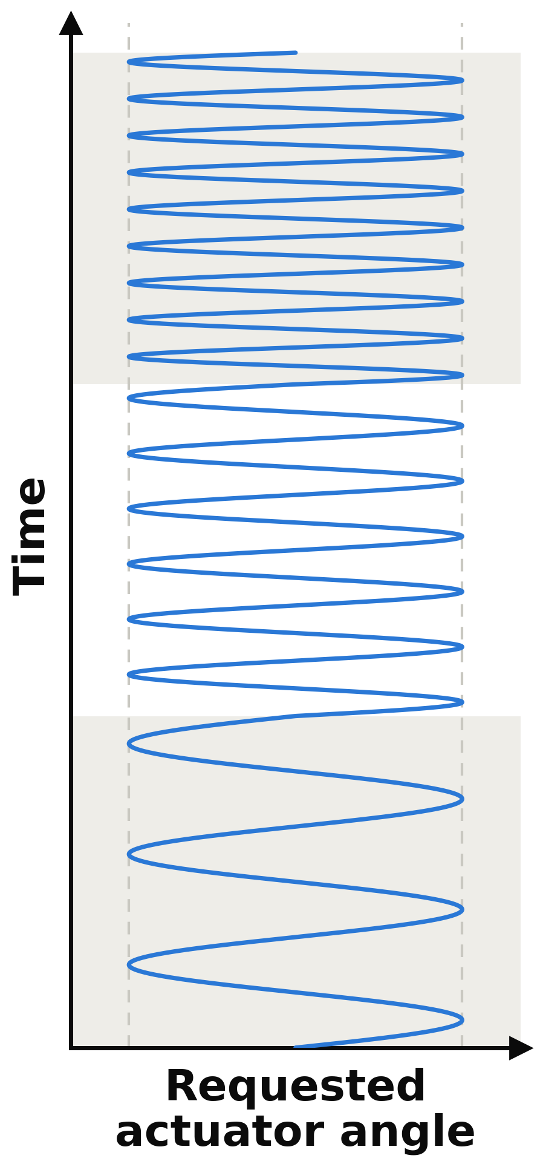
controller/results/staged_chirp_concept.png
