nathmo/running_robot/rl/runs/m1_stand/balance.png

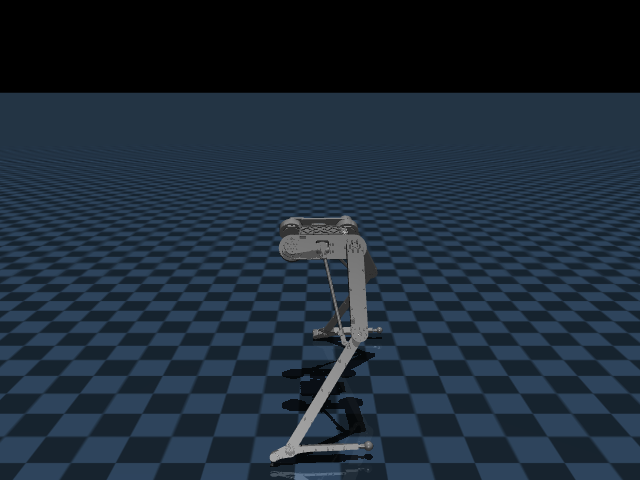
rl/runs/m1_stand/balance.png
