nathmo/running_robot/robot/fixed_gait/_gait_reachability.png

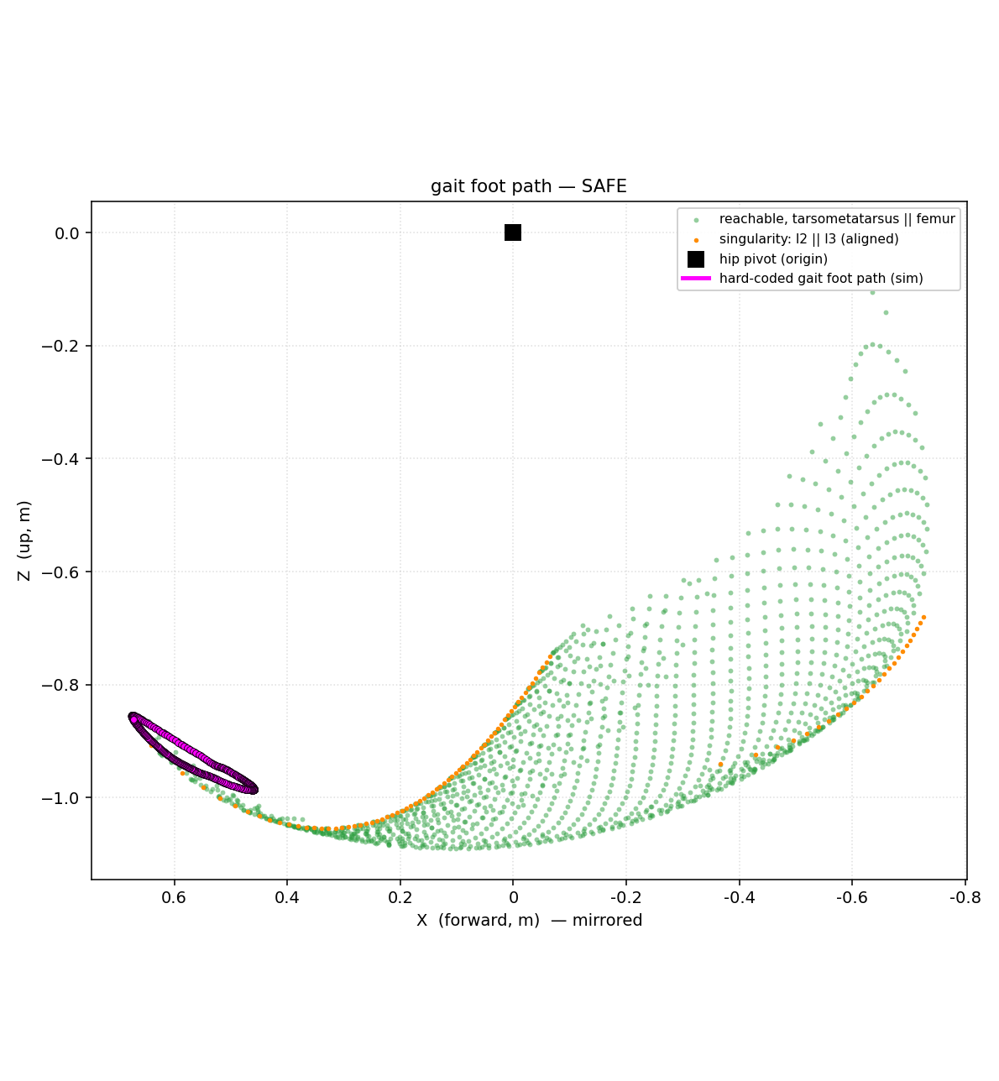
robot/fixed_gait/_gait_reachability.png
