nathmo/running_robot/robot/fixed_gait/gait_recorded.png

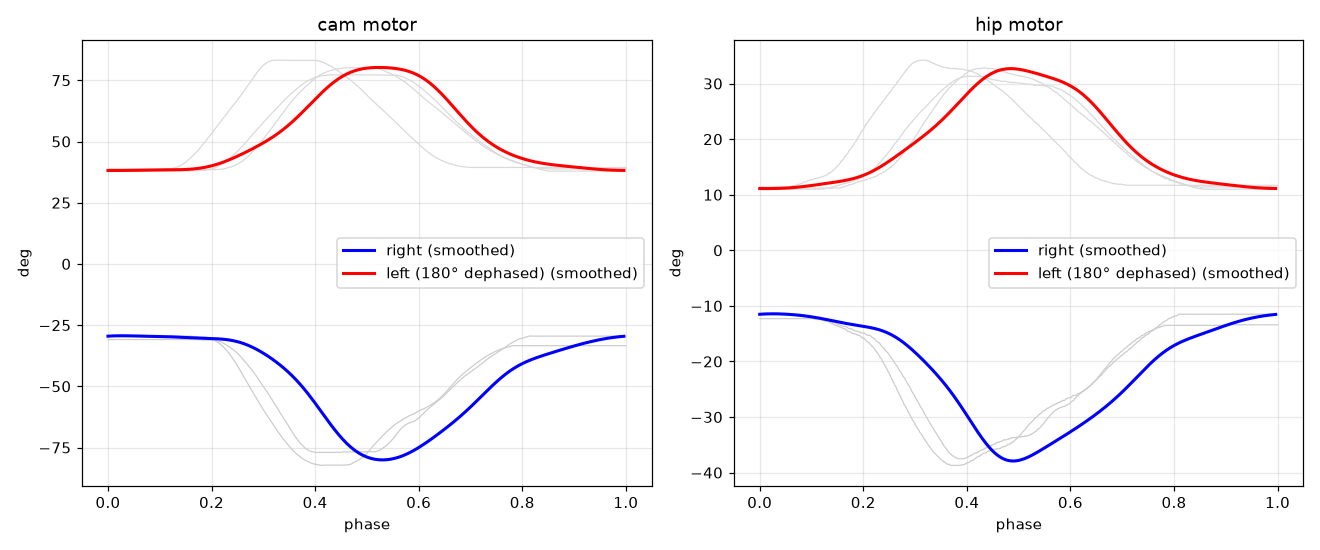
robot/fixed_gait/gait_recorded.png
