nathmo/running_robot/robot/fixed_gait/last_run.png

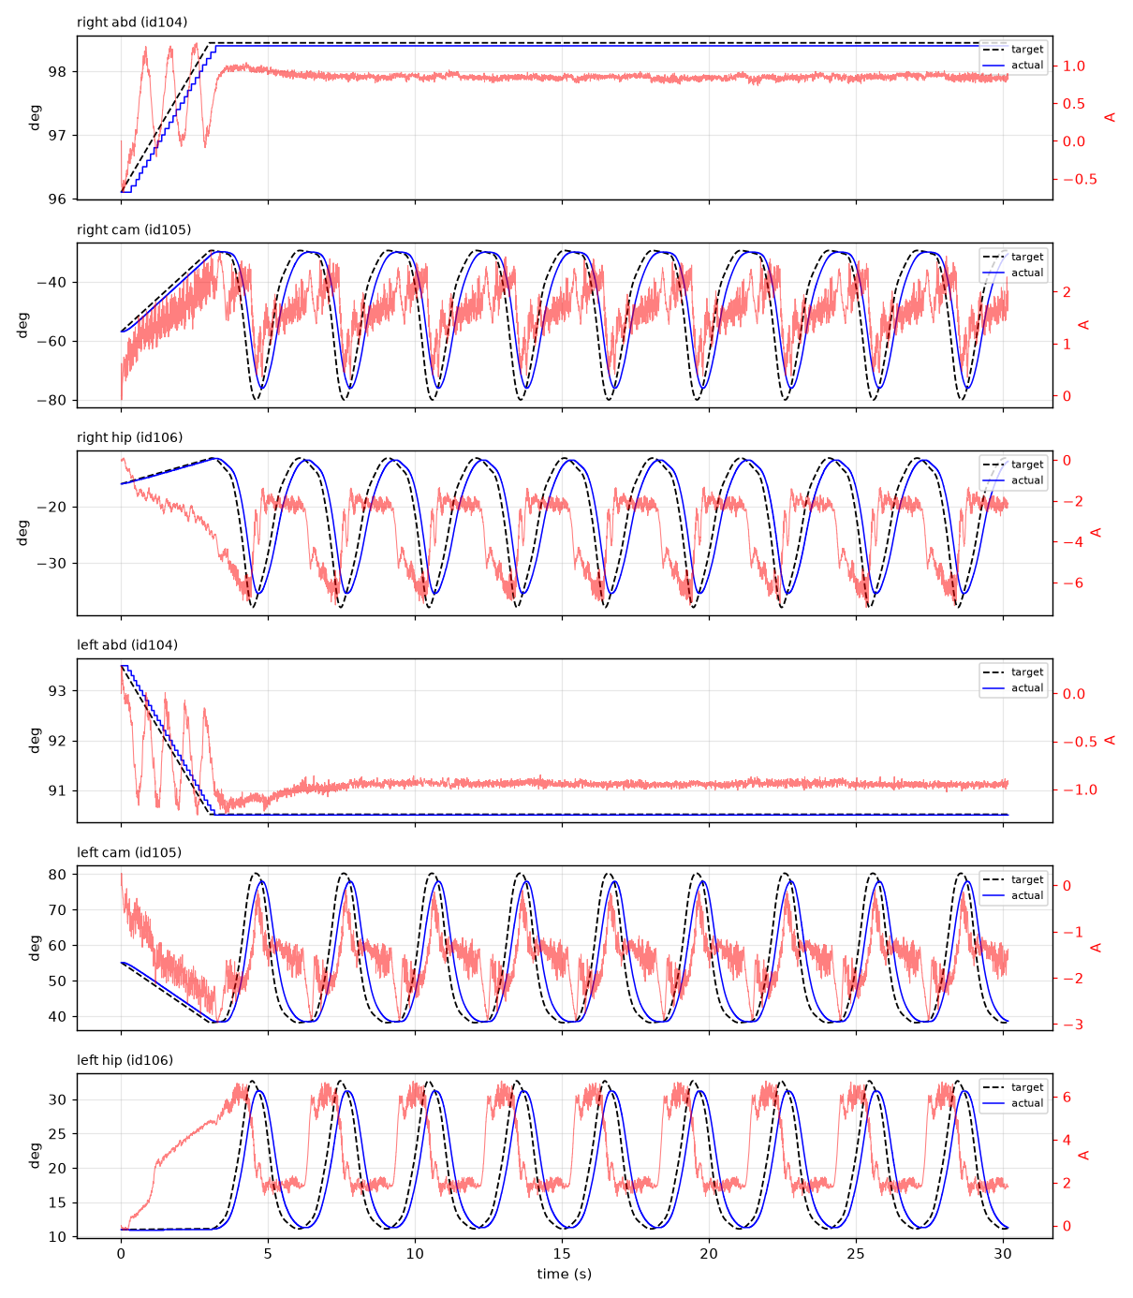
robot/fixed_gait/last_run.png
