nathmo/running_robot/robot/fixed_gait/trajectory_on_workspace.png

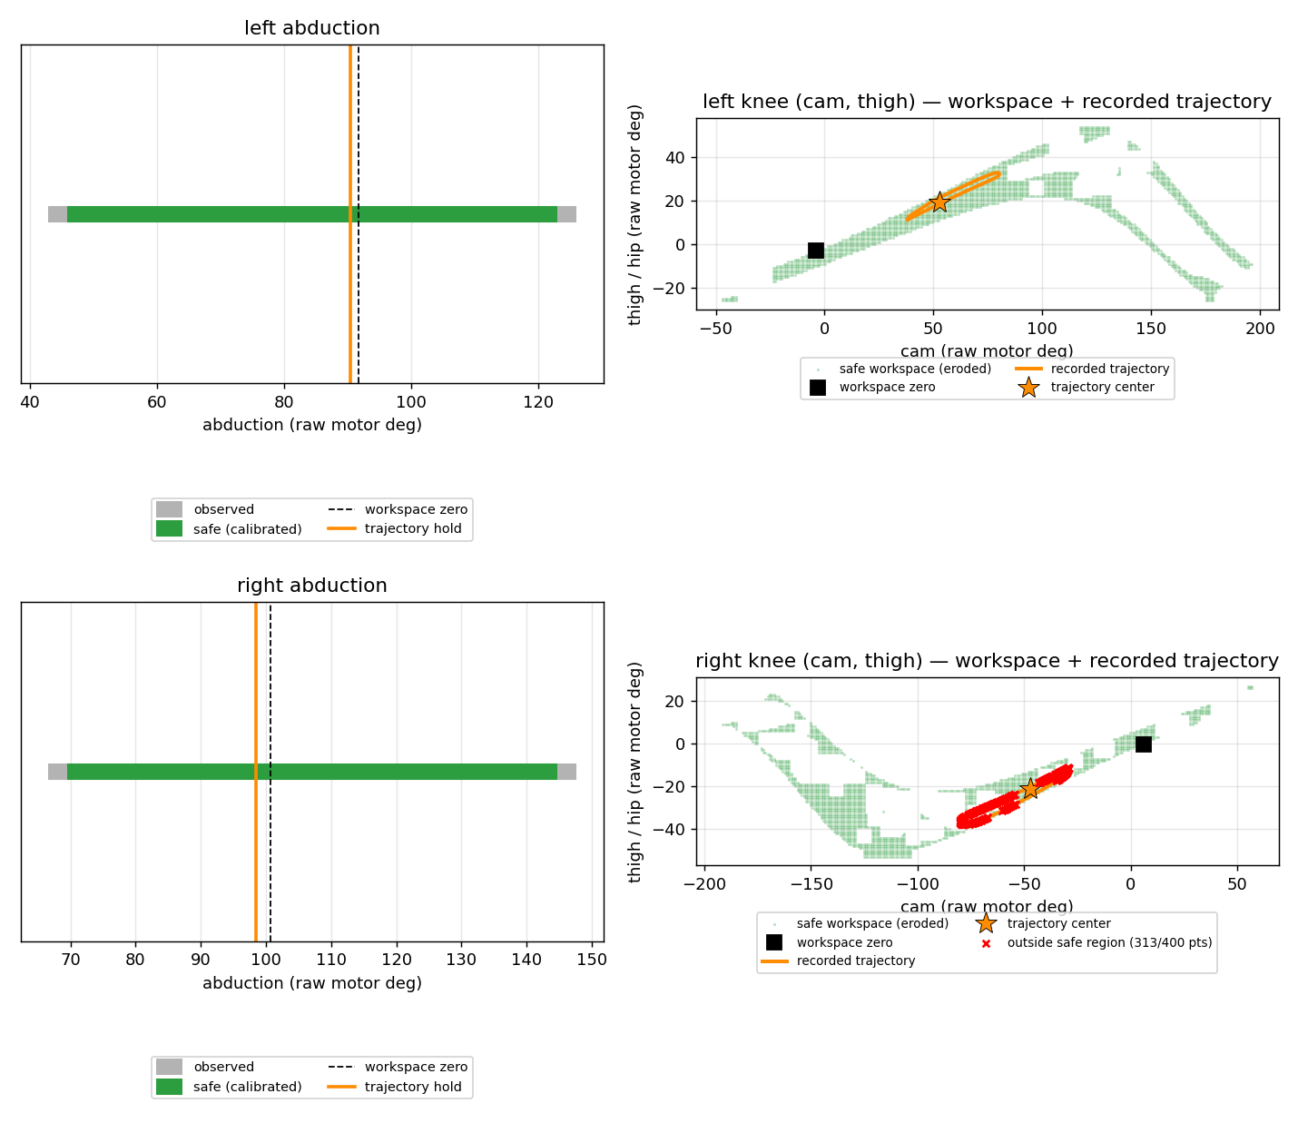
robot/fixed_gait/trajectory_on_workspace.png
