nathmo/running_robot/robot/fixed_gait/worksapce_right.png

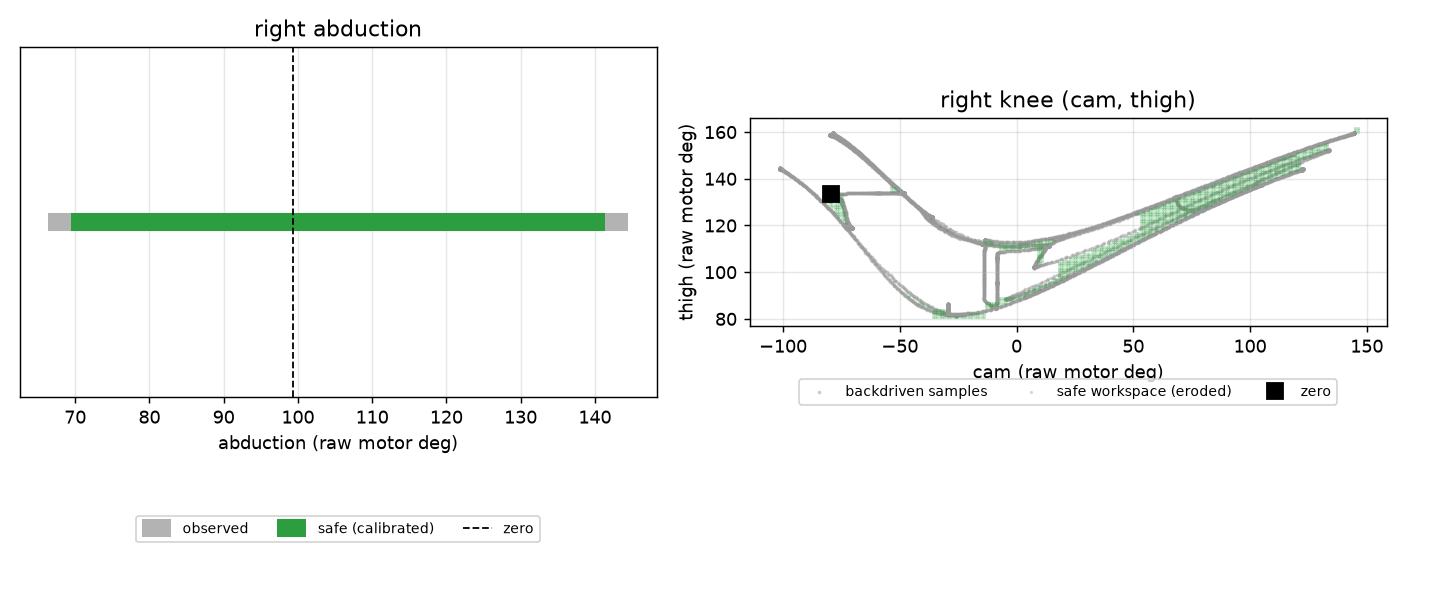
robot/fixed_gait/worksapce_right.png
