nathmo/running_robot/robot/fixed_gait/workspace_summary.png

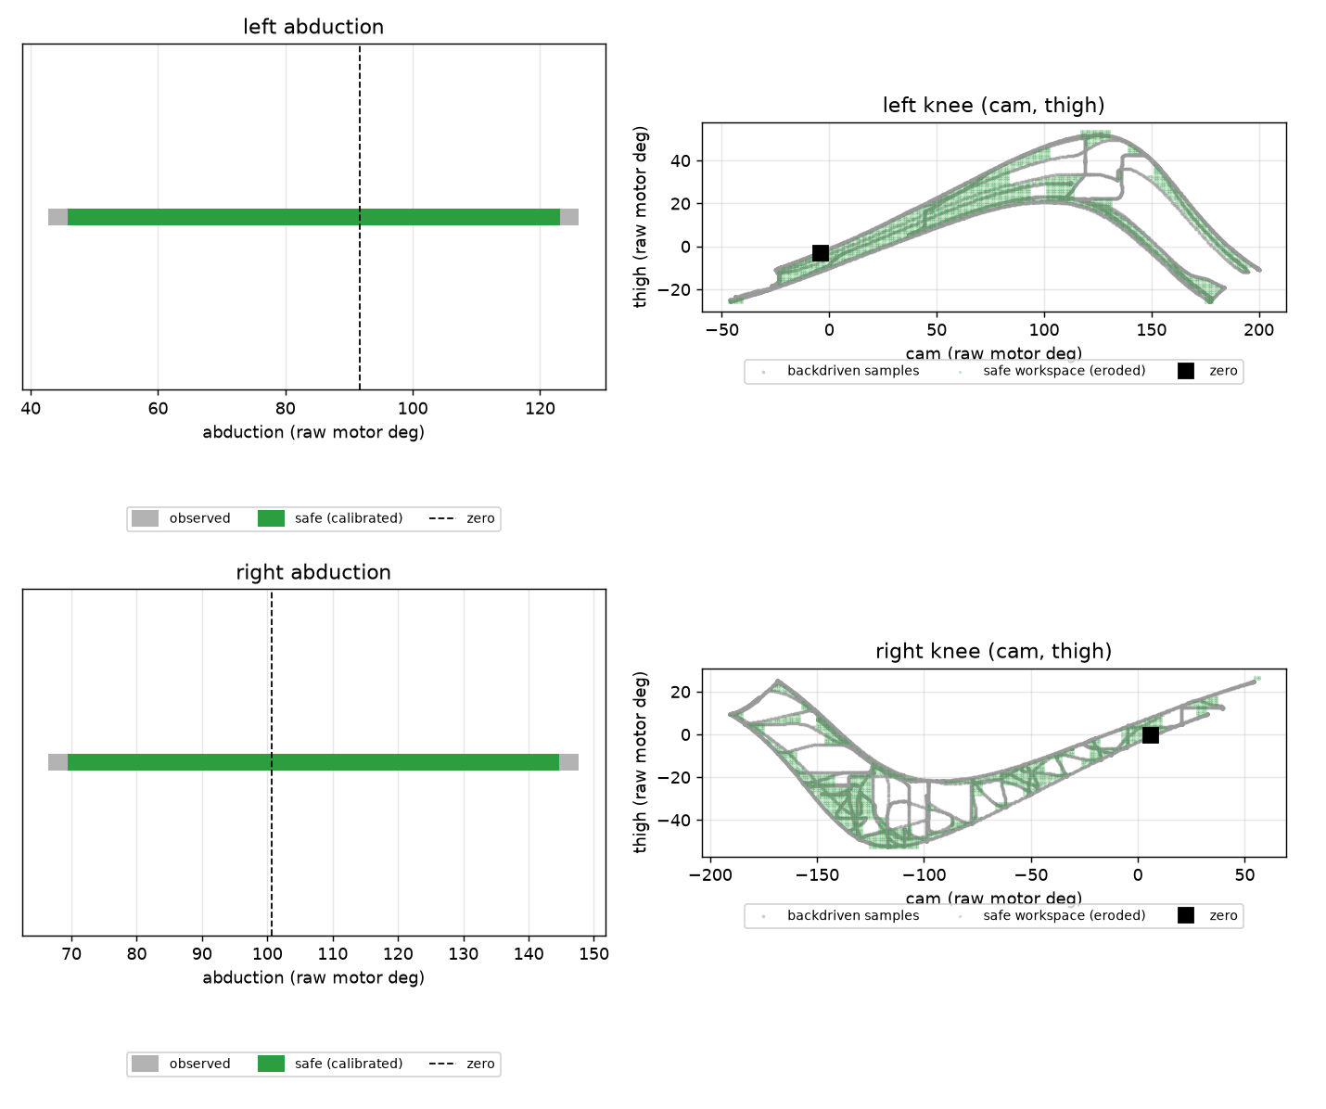
robot/fixed_gait/workspace_summary.png
