nathmo/running_robot/sprint_runner/walk_mit/model/_force_map.png

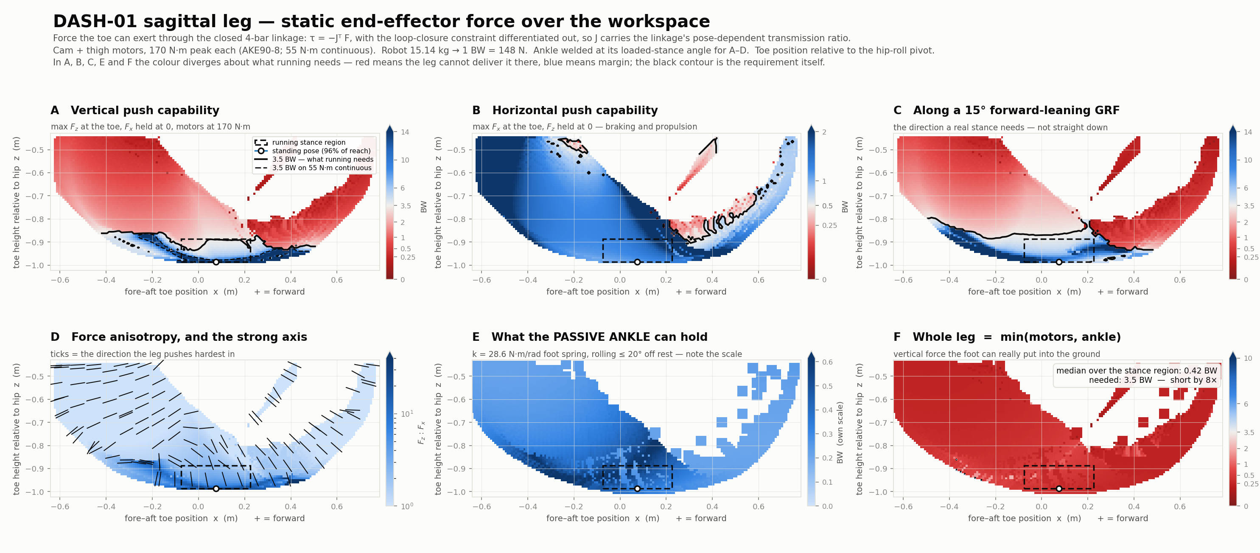
sprint_runner/walk_mit/model/_force_map.png
