nathmo/running_robot/sprint_runner/walk_mit/runs/sprint_m3_mit_s1/training_plots.png

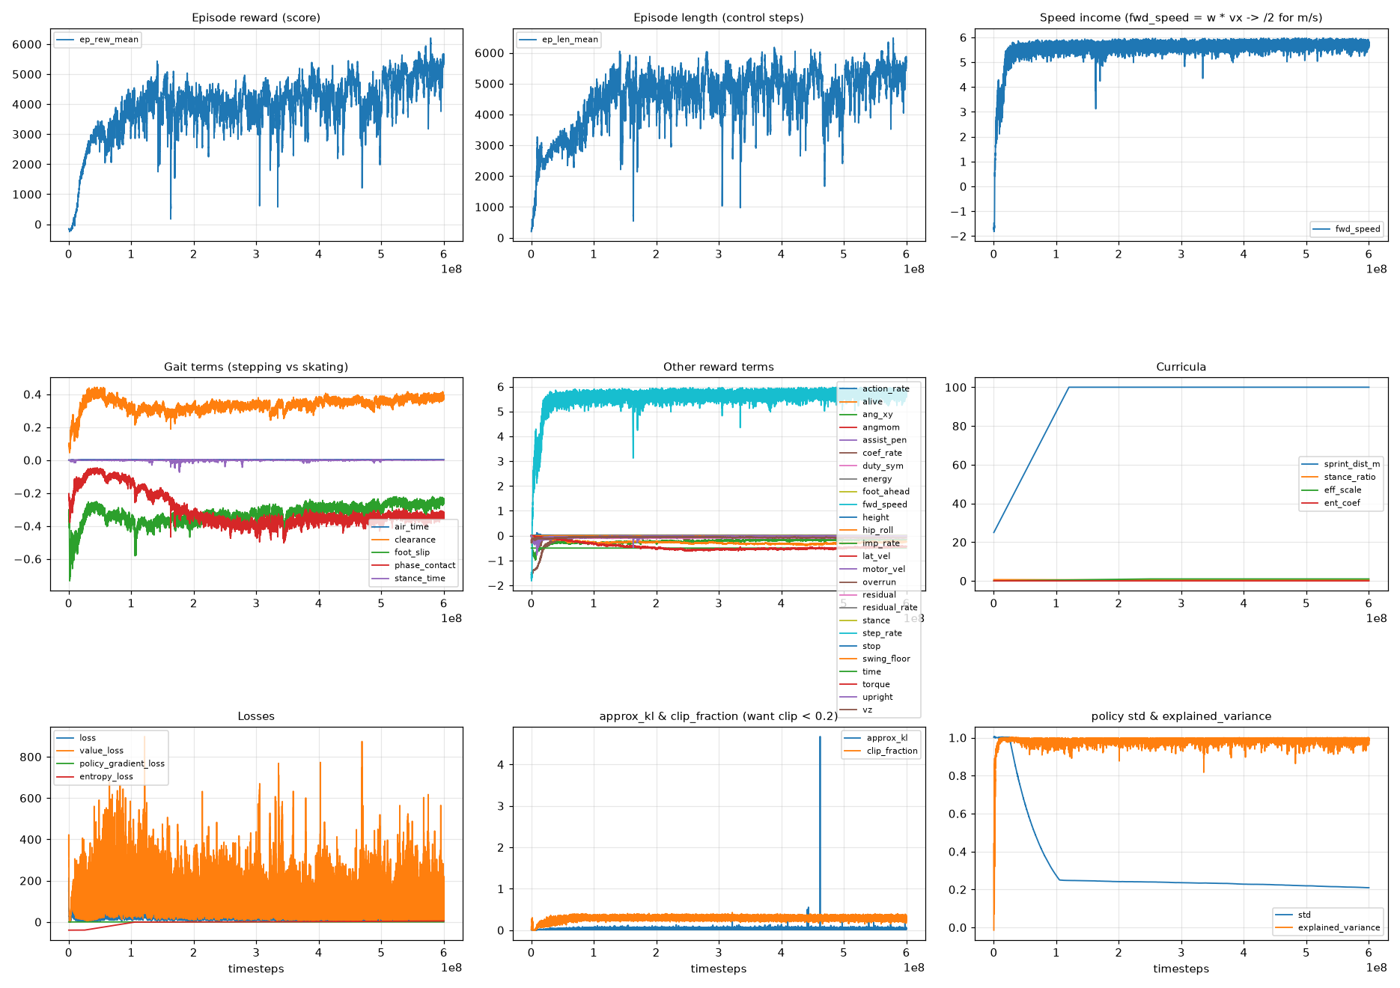
sprint_runner/walk_mit/runs/sprint_m3_mit_s1/training_plots.png
