nathmo/running_robot/controller/fixed_gait/webui/static/twin/meshes/bodyNCS-v1.stl

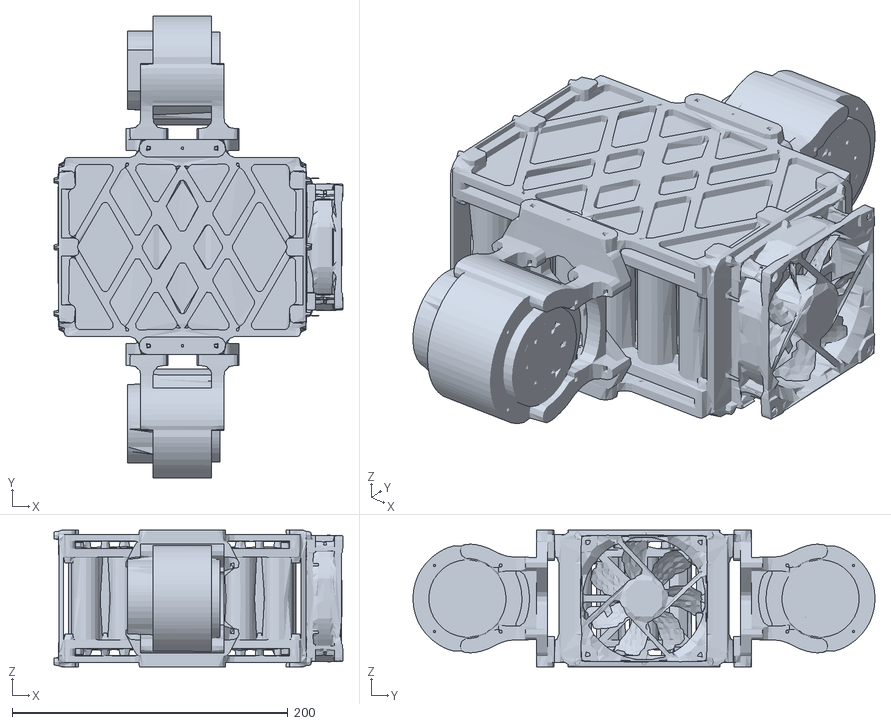
[picture p17: CAD file, 2026-09-21]
controller/fixed_gait/webui/static/twin/meshes/bodyNCS-v1.stl
209.4 x 334.9 x 99.2
