nathmo/running_robot/controller/robotCADdescription/CAD/CamLeftNCS.stp

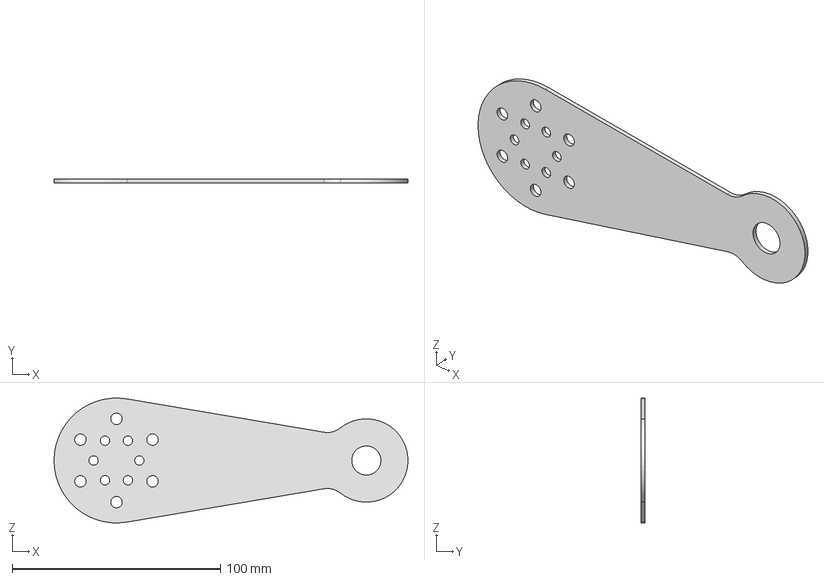
[picture p18: CAD file, 2026-06-19]
controller/robotCADdescription/CAD/CamLeftNCS.stp
170.0 x 2.00 x 59.9 mm
