nathmo/running_robot/dash-01CAD/homing/SpiderBotInitPos/meshes/PushrodLeftNCS-v1.stl

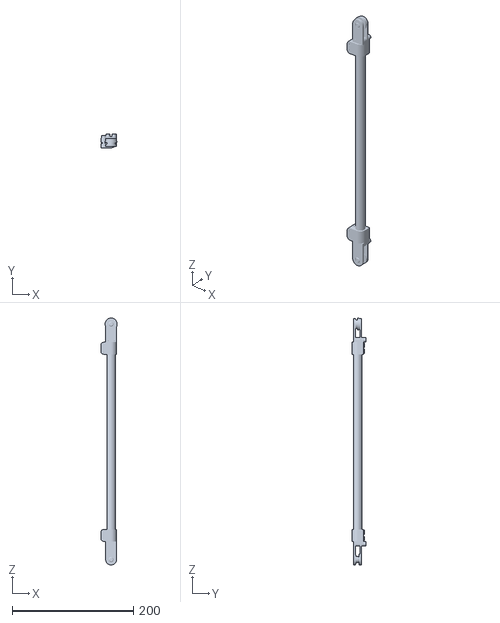
[picture p19: CAD file, 2026-09-16]
dash-01CAD/homing/SpiderBotInitPos/meshes/PushrodLeftNCS-v1.stl
27.0 x 22.5 x 408.0
