nathmo/running_robot/sprint_runner/walk_mit/model/meshes/FootLeftNCS-v1.stl

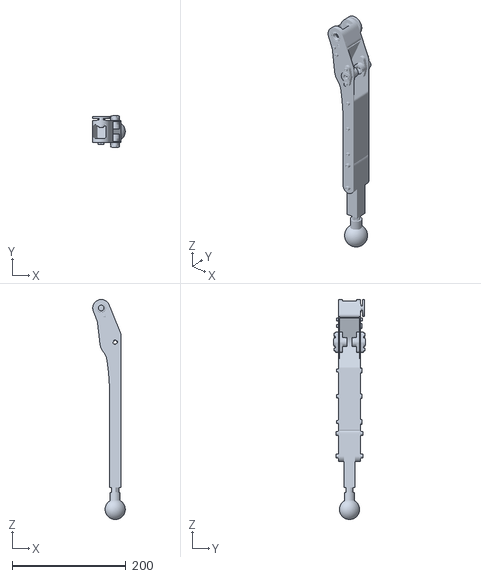
[picture p20: CAD file, 2026-06-19]
sprint_runner/walk_mit/model/meshes/FootLeftNCS-v1.stl
57.2 x 55.4 x 386.5
