nathmo/running_robot/controller/robotCADdescription/CAD/PushrodRightNCS.stp

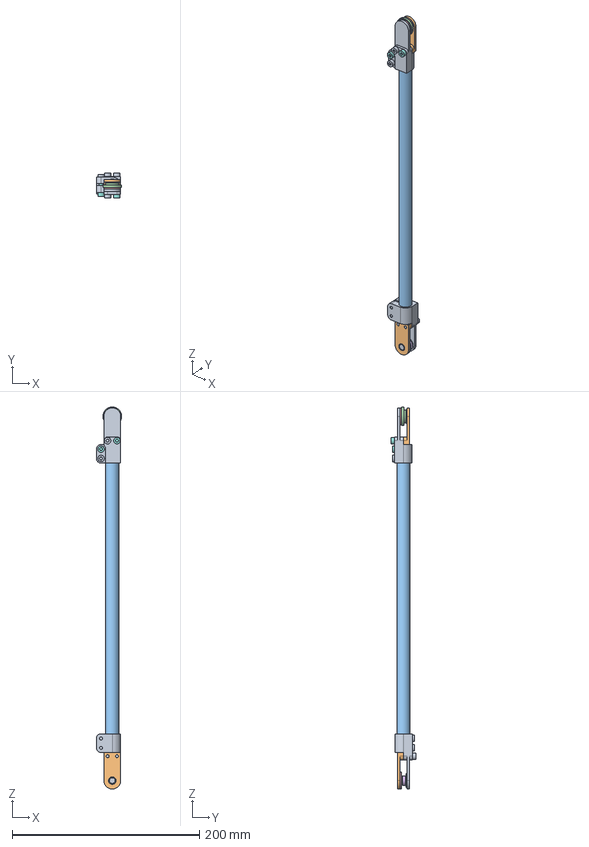
[picture p21: CAD file, 2026-06-19]
controller/robotCADdescription/CAD/PushrodRightNCS.stp
27.0 x 27.0 x 408.0 mm
