nathmo/running_robot/dash-01CAD/homing/SpiderBotInitPos/meshes/HipRightNCS-v1.stl

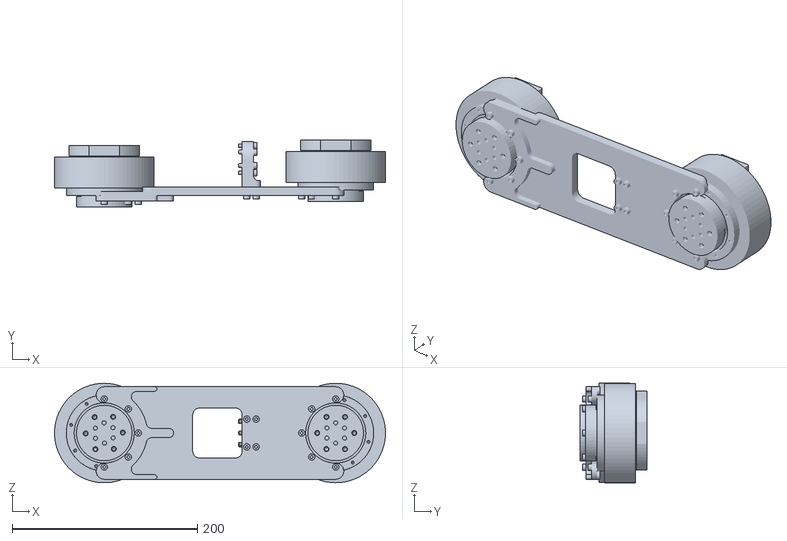
[picture p22: CAD file, 2026-09-16]
dash-01CAD/homing/SpiderBotInitPos/meshes/HipRightNCS-v1.stl
357.5 x 72.4 x 107.5
