nathmo/running_robot/controller/robotCADdescription/CAD/ThighLeftNCS.stp

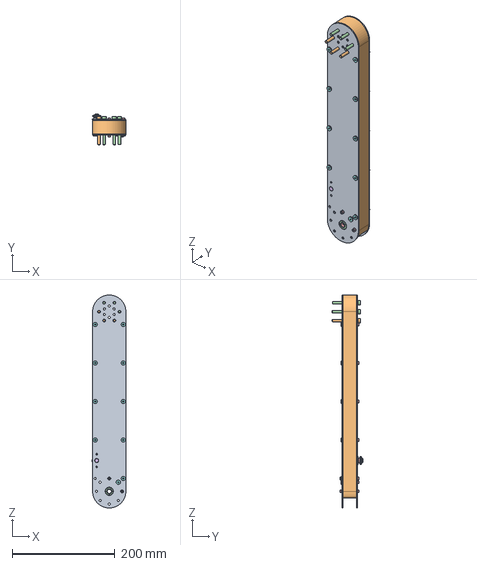
[picture p23: CAD file, 2026-06-19]
controller/robotCADdescription/CAD/ThighLeftNCS.stp
66.0 x 59.5 x 415.0 mm
