nathmo/running_robot/dash-01CAD/homing/SpiderBotInitPos/meshes/FootFlatRightNCS-v1.stl

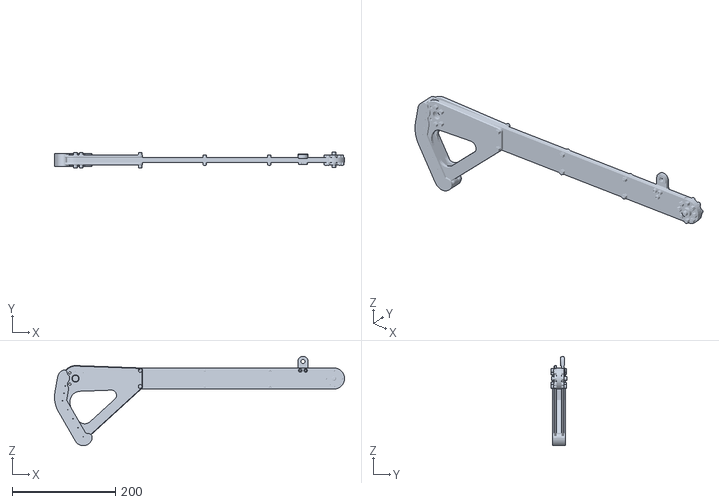
[picture p24: CAD file, 2026-09-16]
dash-01CAD/homing/SpiderBotInitPos/meshes/FootFlatRightNCS-v1.stl
561.1 x 30.2 x 173.1
