nathmo/running_robot/sprint_runner/walk_mit/model/meshes/bodyNCS-v1.stl

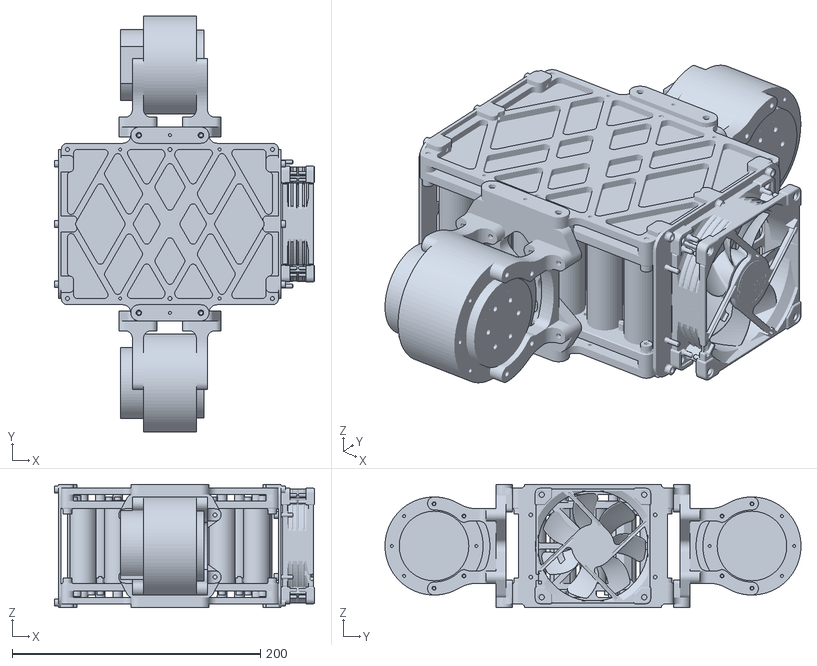
[picture p25: CAD file, 2026-06-19]
sprint_runner/walk_mit/model/meshes/bodyNCS-v1.stl
209.5 x 334.9 x 99.2
