nathmo/running_robot/controller/robotCADdescription/CAD/LegRightNCS.stp

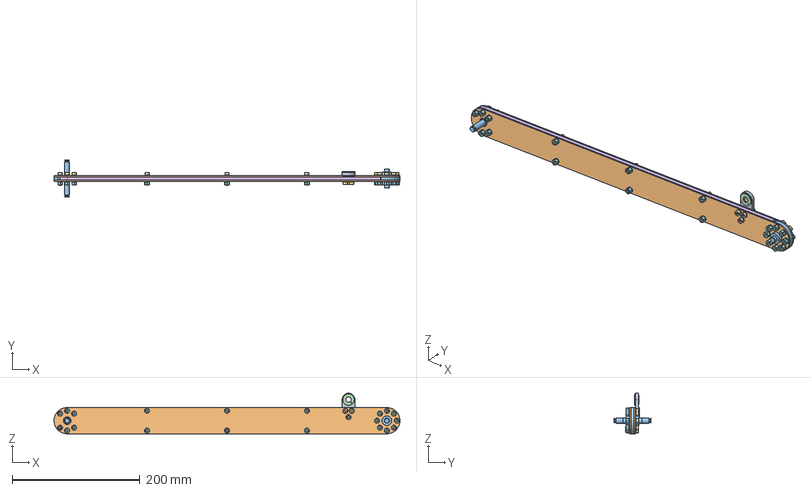
[picture p26: CAD file, 2026-06-19]
controller/robotCADdescription/CAD/LegRightNCS.stp
541.0 x 58.0 x 63.5 mm
