nathmo/running_robot/dash-01CAD/homing/SpiderBotInitPos/meshes/ThighRightNCS-v1.stl

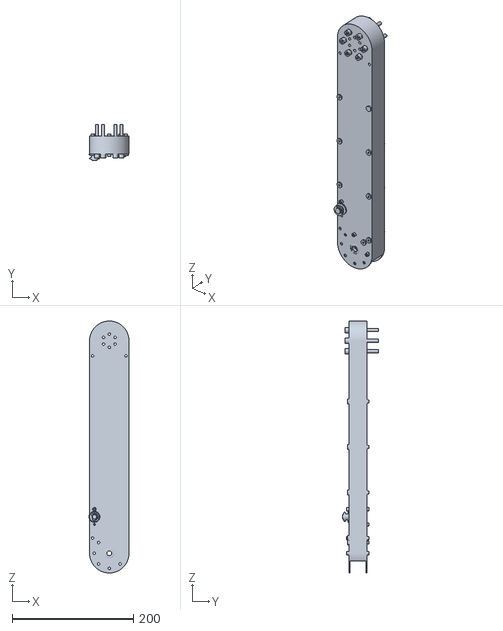
[picture p27: CAD file, 2026-09-16]
dash-01CAD/homing/SpiderBotInitPos/meshes/ThighRightNCS-v1.stl
66.0 x 59.5 x 415.0
