nathmo/running_robot/sprint_runner/walk_mit/model/meshes/FootRightNCS-v1.stl

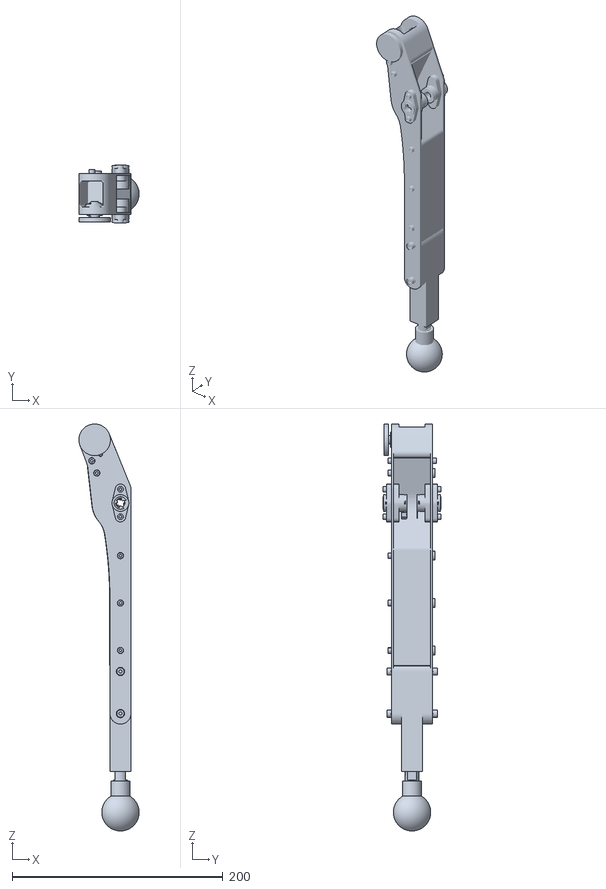
[picture p28: CAD file, 2026-06-19]
sprint_runner/walk_mit/model/meshes/FootRightNCS-v1.stl
57.2 x 55.5 x 386.5
