nathmo/running_robot/controller/robotCADdescription/CAD/PushrodLeftNCS.stp

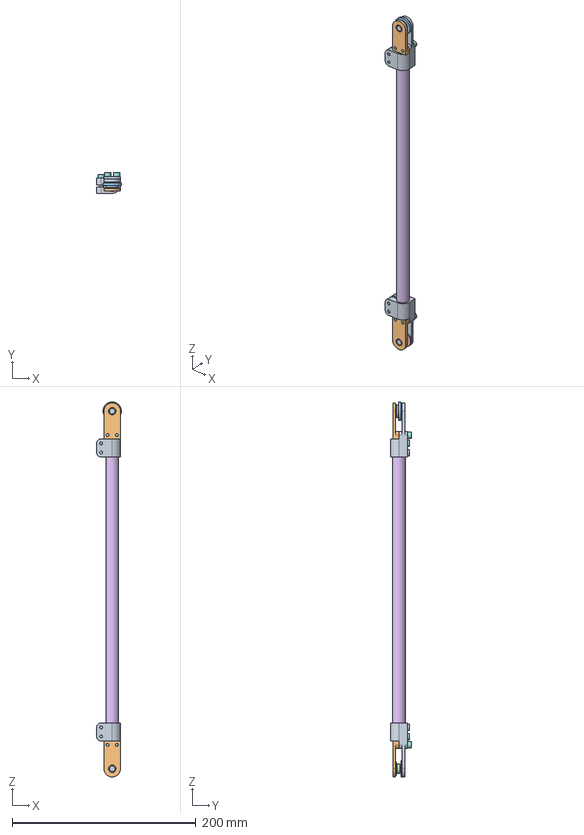
[picture p29: CAD file, 2026-06-19]
controller/robotCADdescription/CAD/PushrodLeftNCS.stp
27.0 x 22.5 x 408.0 mm
