nathmo/running_robot/(list of files, cad)

Other CAD files:
controller/fixed_gait/webui/static/twin/meshes/CamLeftNCS-v1.stl
sprint_runner/walk_mit/model/meshes/PushrodLeftNCS-v1.stl
controller/fixed_gait/webui/static/twin/meshes/HipLeftNCS-v1.stl
sprint_runner/walk_mit/model/meshes/PushrodRightNCS-v1.stl
controller/fixed_gait/webui/static/twin/meshes/PushrodLeftNCS-v1.stl
controller/robotCADdescription/CAD/HipRightNCS.stp
dash-01CAD/homing/SpiderBotInitPos/meshes/CamRightNCS-v1.stl
controller/fixed_gait/webui/static/twin/meshes/FootFlatRightNCS-v1.stl
controller/robotCADdescription/CAD/bodyNCS.stp
dash-01CAD/homing/SpiderBotInitPos/meshes/bodyNCS-v1.stl
sprint_runner/walk_mit/model/meshes/HipRightNCS-v1.stl
controller/fixed_gait/webui/static/twin/meshes/CamRightNCS-v1.stl
sprint_runner/walk_mit/model/meshes/LegLeftNCS-v1.stl
controller/fixed_gait/webui/static/twin/meshes/ThighLeftNCS-v1.stl
controller/robotCADdescription/CAD/LegLeftNCS.stp
controller/robotCADdescription/MJCF_OPEN_MUJOCO_B/dash01/meshes/LegLeftNCS-v1.stl
dash-01CAD/homing/SpiderBotInitPos/meshes/ThighLeftNCS-v1.stl
sprint_runner/walk_mit/model/meshes/CamRightNCS-v1.stl
controller/fixed_gait/webui/static/twin/meshes/ThighRightNCS-v1.stl
controller/robotCADdescription/CAD/CamRightNCS.stp
dash-01CAD/homing/SpiderBotInitPos/meshes/PushrodRightNCS-v1.stl
controller/fixed_gait/webui/static/twin/meshes/FootFlatLeftNCS-v1.stl
controller/robotCADdescription/CAD/FootRightNCS.stp
dash-01CAD/homing/SpiderBotInitPos/meshes/CamLeftNCS-v1.stl
sprint_runner/walk_mit/model/meshes/LegRightNCS-v1.stl
controller/fixed_gait/webui/static/twin/meshes/HipRightNCS-v1.stl
controller/robotCADdescription/CAD/HipLeftNCS.stp
dash-01CAD/homing/SpiderBotInitPos/meshes/FootFlatLeftNCS-v1.stl
sprint_runner/walk_mit/model/meshes/ThighLeftNCS-v1.stl
controller/fixed_gait/webui/static/twin/meshes/PushrodRightNCS-v1.stl
dash-01CAD/homing/SpiderBotInitPos/meshes/HipLeftNCS-v1.stl
sprint_runner/walk_mit/model/meshes/HipLeftNCS-v1.stl
controller/robotCADdescription/CAD/ThighRightNCS.stp
sprint_runner/walk_mit/model/meshes/CamLeftNCS-v1.stl
controller/robotCADdescription/CAD/FootLeftNCS.stp
controller/robotCADdescription/MJCF_OPEN_MUJOCO_B/dash01/meshes/LegRightNCS-v1.stl
sprint_runner/walk_mit/model/meshes/ThighRightNCS-v1.stl
controller/robotCADdescription/CAD/CamLeft.iam
controller/robotCADdescription/CAD/CamLeftNCS.iam
controller/robotCADdescription/CAD/CamLeftNCS.ipt
controller/robotCADdescription/CAD/CamRight.iam
controller/robotCADdescription/CAD/CamRightNCS.iam
controller/robotCADdescription/CAD/CamRightNCS.ipt
controller/robotCADdescription/CAD/FootLeft.iam
controller/robotCADdescription/CAD/FootLeftNCS.iam
controller/robotCADdescription/CAD/FootLeftNCS.ipt
controller/robotCADdescription/CAD/FootRight.iam
controller/robotCADdescription/CAD/FootRightNCS.iam
controller/robotCADdescription/CAD/FootRightNCS.ipt
controller/robotCADdescription/CAD/FullyAssembly.iam
controller/robotCADdescription/CAD/HipLeft.iam
controller/robotCADdescription/CAD/HipLeftNCS.iam
controller/robotCADdescription/CAD/HipLeftNCS.ipt
controller/robotCADdescription/CAD/HipRight.iam
controller/robotCADdescription/CAD/HipRightNCS.iam
controller/robotCADdescription/CAD/HipRightNCS.ipt
controller/robotCADdescription/CAD/LegLeft.iam
controller/robotCADdescription/CAD/LegLeftNCS.iam
controller/robotCADdescription/CAD/LegLeftNCS.ipt
controller/robotCADdescription/CAD/LegRight.iam
controller/robotCADdescription/CAD/LegRightNCS.iam
controller/robotCADdescription/CAD/LegRightNCS.ipt
controller/robotCADdescription/CAD/PushrodLeft.iam
controller/robotCADdescription/CAD/PushrodLeftNCS.iam
controller/robotCADdescription/CAD/PushrodLeftNCS.ipt
controller/robotCADdescription/CAD/PushrodRight.iam
controller/robotCADdescription/CAD/PushrodRightNCS.iam
controller/robotCADdescription/CAD/PushrodRightNCS.ipt
controller/robotCADdescription/CAD/ThighLeft.iam
controller/robotCADdescription/CAD/ThighLeftNCS.iam
controller/robotCADdescription/CAD/ThighLeftNCS.ipt
controller/robotCADdescription/CAD/ThighRight.iam
controller/robotCADdescription/CAD/ThighRightNCS.iam
controller/robotCADdescription/CAD/ThighRightNCS.ipt
controller/robotCADdescription/CAD/body.iam
controller/robotCADdescription/CAD/bodyNCS.iam
controller/robotCADdescription/CAD/bodyNCS.ipt
controller/robotCADdescription/MJCF_OPEN_MUJOCO_B/dash01/meshes/CamLeftNCS-v1.stl
controller/robotCADdescription/MJCF_OPEN_MUJOCO_B/dash01/meshes/CamRightNCS-v1.stl
controller/robotCADdescription/MJCF_OPEN_MUJOCO_B/dash01/meshes/HipLeftNCS-v1.stl
controller/robotCADdescription/MJCF_OPEN_MUJOCO_B/dash01/meshes/HipRightNCS-v1.stl
controller/robotCADdescription/MJCF_OPEN_MUJOCO_B/dash01/meshes/PushrodLeftNCS-v1.stl
controller/robotCADdescription/MJCF_OPEN_MUJOCO_B/dash01/meshes/PushrodRightNCS-v1.stl
controller/robotCADdescription/MJCF_OPEN_MUJOCO_B/dash01/meshes/ThighLeftNCS-v1.stl
controller/robotCADdescription/MJCF_OPEN_MUJOCO_B/dash01/meshes/ThighRightNCS-v1.stl
robot/robotCADdescription/MJCF_CLOSED_MUJOCO/dash01/meshes/CamLeftNCS-v1.stl
robot/robotCADdescription/MJCF_CLOSED_MUJOCO/dash01/meshes/CamRightNCS-v1.stl
robot/robotCADdescription/MJCF_CLOSED_MUJOCO/dash01/meshes/HipLeftNCS-v1.stl
robot/robotCADdescription/MJCF_CLOSED_MUJOCO/dash01/meshes/HipRightNCS-v1.stl
robot/robotCADdescription/MJCF_CLOSED_MUJOCO/dash01/meshes/LegLeftNCS-v1.stl
robot/robotCADdescription/MJCF_CLOSED_MUJOCO/dash01/meshes/LegRightNCS-v1.stl
robot/robotCADdescription/MJCF_CLOSED_MUJOCO/dash01/meshes/PushrodLeftNCS-v1.stl
robot/robotCADdescription/MJCF_CLOSED_MUJOCO/dash01/meshes/PushrodRightNCS-v1.stl
robot/robotCADdescription/MJCF_CLOSED_MUJOCO/dash01/meshes/ThighLeftNCS-v1.stl
robot/robotCADdescription/MJCF_CLOSED_MUJOCO/dash01/meshes/ThighRightNCS-v1.stl
robot/robotCADdescription/MJCF_OPEN_MUJOCO_A/dash01/meshes/CamLeftNCS-v1.stl
robot/robotCADdescription/MJCF_OPEN_MUJOCO_A/dash01/meshes/CamRightNCS-v1.stl
robot/robotCADdescription/MJCF_OPEN_MUJOCO_A/dash01/meshes/HipLeftNCS-v1.stl
robot/robotCADdescription/MJCF_OPEN_MUJOCO_A/dash01/meshes/HipRightNCS-v1.stl
robot/robotCADdescription/MJCF_OPEN_MUJOCO_A/dash01/meshes/LegLeftNCS-v1.stl
robot/robotCADdescription/MJCF_OPEN_MUJOCO_A/dash01/meshes/LegRightNCS-v1.stl
robot/robotCADdescription/MJCF_OPEN_MUJOCO_A/dash01/meshes/PushrodLeftNCS-v1.stl
robot/robotCADdescription/MJCF_OPEN_MUJOCO_A/dash01/meshes/PushrodRightNCS-v1.stl
robot/robotCADdescription/MJCF_OPEN_MUJOCO_A/dash01/meshes/ThighLeftNCS-v1.stl
robot/robotCADdescription/MJCF_OPEN_MUJOCO_A/dash01/meshes/ThighRightNCS-v1.stl
robot/robotCADdescription/MJCF_OPEN_MUJOCO_B/dash01/meshes/CamLeftNCS-v1.stl
robot/robotCADdescription/MJCF_OPEN_MUJOCO_B/dash01/meshes/CamRightNCS-v1.stl
robot/robotCADdescription/MJCF_OPEN_MUJOCO_B/dash01/meshes/HipLeftNCS-v1.stl
robot/robotCADdescription/MJCF_OPEN_MUJOCO_B/dash01/meshes/HipRightNCS-v1.stl
robot/robotCADdescription/MJCF_OPEN_MUJOCO_B/dash01/meshes/LegLeftNCS-v1.stl
robot/robotCADdescription/MJCF_OPEN_MUJOCO_B/dash01/meshes/LegRightNCS-v1.stl
robot/robotCADdescription/MJCF_OPEN_MUJOCO_B/dash01/meshes/PushrodLeftNCS-v1.stl
robot/robotCADdescription/MJCF_OPEN_MUJOCO_B/dash01/meshes/PushrodRightNCS-v1.stl
robot/robotCADdescription/MJCF_OPEN_MUJOCO_B/dash01/meshes/ThighLeftNCS-v1.stl
robot/robotCADdescription/MJCF_OPEN_MUJOCO_B/dash01/meshes/ThighRightNCS-v1.stl
robot/robotCADdescription/SDF_CLOSED_GAZEBO/dash01/meshes/CamLeftNCS-v1.stl
robot/robotCADdescription/SDF_CLOSED_GAZEBO/dash01/meshes/CamRightNCS-v1.stl
robot/robotCADdescription/SDF_CLOSED_GAZEBO/dash01/meshes/HipLeftNCS-v1.stl
robot/robotCADdescription/SDF_CLOSED_GAZEBO/dash01/meshes/HipRightNCS-v1.stl
robot/robotCADdescription/SDF_CLOSED_GAZEBO/dash01/meshes/LegLeftNCS-v1.stl
robot/robotCADdescription/SDF_CLOSED_GAZEBO/dash01/meshes/LegRightNCS-v1.stl
robot/robotCADdescription/SDF_CLOSED_GAZEBO/dash01/meshes/PushrodLeftNCS-v1.stl
robot/robotCADdescription/SDF_CLOSED_GAZEBO/dash01/meshes/PushrodRightNCS-v1.stl
robot/robotCADdescription/SDF_CLOSED_GAZEBO/dash01/meshes/ThighLeftNCS-v1.stl
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
