nathmo/running_robot/RLframework/results/torque_vs_speed_dash_joy3_lr_s2_180M.pdf

0.59 | 0.86 | 1.37 | 1.64 | 1.85 | 3.06

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
torque [N*m]

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
hip_roll_L peak limit 61 continuous 23 N*m

0.59 | 0.86 | 1.37 | 1.64 | 1.85 | 3.06

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
144*

48

cam_L peak limit 144 continuous 55 N*m

0.59 | 0.86 | 1.37 | 1.64 | 1.85 | 3.06

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
144*

42

144*

49

144*

50

144*

26

thigh_L peak limit 144 continuous 55 N*m

0.59 | 0.86 | 1.37 | 1.64 | 1.85 | 3.06
achieved forward speed [m/s]

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
torque [N*m]

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
hip_roll_R peak limit 61 continuous 23 N*m

0.59 | 0.86 | 1.37 | 1.64 | 1.85 | 3.06
achieved forward speed [m/s]

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
144*

51

cam_R peak limit 144 continuous 55 N*m

0.59 | 0.86 | 1.37 | 1.64 | 1.85 | 3.06
achieved forward speed [m/s]

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
144*

37

144*

37

144*

39

144*

55

thigh_R peak limit 144 continuous 55 N*m

* the drive clipped at the limit on this rung -- demand is at least the bar height, not equal to it

## Per-motor torque demand vs speed - dash_joy3_lr_s2 (180 M)

5 speeds held 16 s each, settled window only, 1 kHz sampling through the shipping control law; shaded at right, sprint_m3_mit_s0's 100 m dash for scale

peak |tau| (worst 1 kHz sample) | RMS torque | peak limit (forcerange) | continuous rating (thermal) | sprint_m3_mit_s0 - 100 m dash, 8 episodes (different policy)
