nathmo/running_robot/sprint_runner/results/torque_bars_s0.pdf

hip_roll_L | cam_L | thigh_L | hip_roll_R | cam_R | thigh_R

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
torque [N*m]

21

61 | | 61 | 54
| 48 | | | 51

144

25

128

20

144

144

peak limit | continuous rating | RMS (solid) / peak (pale)

## Torque demand vs motor ratings - steady run, pooled over 8 dashes sprint_m3_mit_s0, t = 2 s to the line
