nathmo/running_robot/sprint_runner/results/torque_dash_s0.pdf

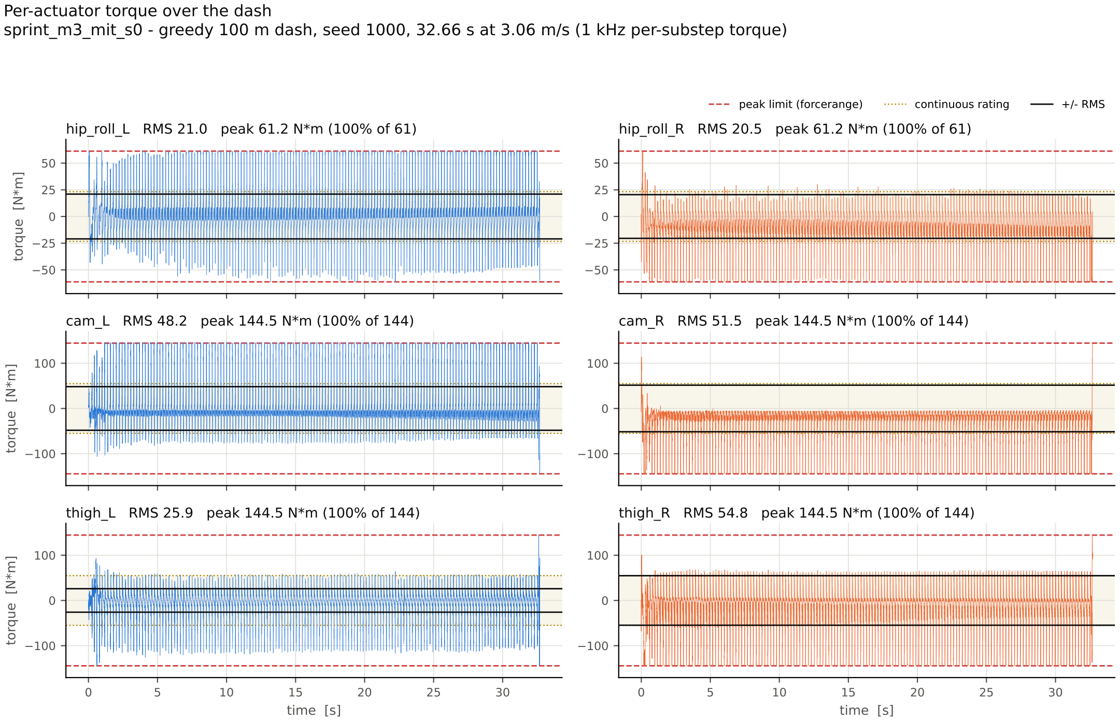
[picture p30: page 1]

−50

−25

0

25

50
torque [N*m]

hip_roll_L RMS 21.0 peak 61.2 N*m (100% of 61)

−50

−25

0

25

50

hip_roll_R RMS 20.5 peak 61.2 N*m (100% of 61)

peak limit (forcerange) | continuous rating | +/- RMS

−100

0

100
torque [N*m]

cam_L RMS 48.2 peak 144.5 N*m (100% of 144)

−100

0

100

cam_R RMS 51.5 peak 144.5 N*m (100% of 144)

0 | 5 | 10 | 15 | 20 | 25 | 30
time [s]

−100

0

100
torque [N*m]

thigh_L RMS 25.9 peak 144.5 N*m (100% of 144)

0 | 5 | 10 | 15 | 20 | 25 | 30
time [s]

−100

0

100

thigh_R RMS 54.8 peak 144.5 N*m (100% of 144)

### Per-actuator torque over the dash

sprint_m3_mit_s0 - greedy 100 m dash, seed 1000, 32.66 s at 3.06 m/s (1 kHz per-substep torque)
