nathmo/running_robot/sprint_runner/results/sprint_dash_run.pdf

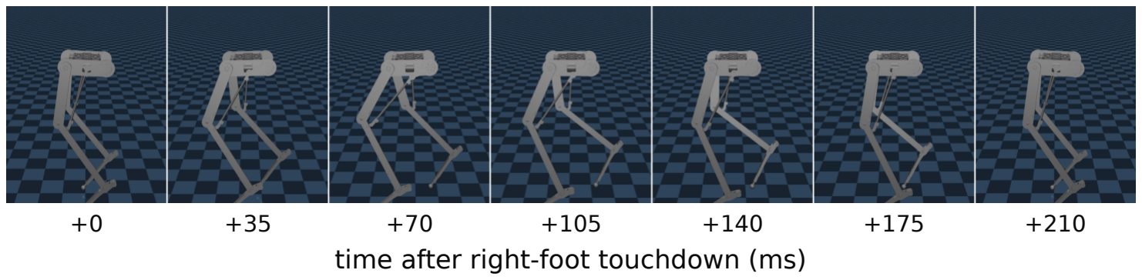
[picture p34: figure]
time after right-foot touchdown (ms)

15.25 | 15.50 | 15.75 | 16.00 | 16.25 | 16.50 | 16.75 | 17.00 | 17.25
time (s) -- shaded span = the stride shown above

right

left
