nathmo/running_robot/RLframework/results/curves/dash_s0_eval.csv

step | finishes | falls | n | t_line_mean | dist_mean | speed_mean | track_err | heading_err | alive_frac | bringup_alive | cur_track_err | cur_alive_frac | eval_s
14745600 | 0 | 64 | 64 | nan | 0.7325263023376465 | 0.5484378182749337 | 1.96875 | 0.0 | 0.0 | 0.0 | 1.1906249523162842 | 0.0 | 174.07648277282715
29491200 | 0 | 64 | 64 | nan | 1.5166015625 | 0.4707251092689635 | 1.063450813293457 | 0.17113186419010162 | 0.0 | 0.09375 | 0.9767922759056091 | 0.0 | 190.38905453681946
44236800 | 0 | 64 | 64 | nan | 2.0534725189208984 | 0.6398741285938279 | 0.9195170402526855 | 0.33534881472587585 | 0.0 | 0.0 | 0.7935614585876465 | 0.0 | 149.0753972530365
58982400 | 0 | 64 | 64 | nan | 2.783327579498291 | 0.8432888699683947 | 1.8412737846374512 | 0.2033291608095169 | 0.0 | 0.078125 | 1.1186714172363281 | 0.0 | 179.0089626312256
73728000 | 0 | 64 | 64 | nan | -0.0022796127013862133 | -0.0081357193125302 | 1.96875 | 0.0 | 0.0 | 0.0 | 1.1906249523162842 | 0.0 | 7.645329475402832
88473600 | 0 | 64 | 64 | nan | 0.47238531708717346 | 0.45641972002152603 | 1.9682809114456177 | 0.013936041854321957 | 0.0 | 0.0 | 1.1906249523162842 | 0.0 | 47.93868827819824
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
