nathmo/running_robot/RLframework/results/curves/dash_s1_eval.csv

step | finishes | falls | n | t_line_mean | dist_mean | speed_mean | track_err | heading_err | alive_frac | bringup_alive | cur_track_err | cur_alive_frac | eval_s
14745600 | 0 | 64 | 64 | nan | 0.5994905233383179 | 0.4610343181512918 | 1.96875 | 0.0 | 0.0 | 0.0 | 1.1906249523162842 | 0.0 | 174.54563450813293
29491200 | 0 | 64 | 64 | nan | 0.9703677892684937 | 0.6479956220060471 | 1.96875 | 0.0 | 0.0 | 0.0 | 1.1906249523162842 | 0.0 | 42.075963258743286
44236800 | 0 | 64 | 64 | nan | 1.0129168033599854 | 0.6073702216266544 | 2.0011236667633057 | 0.15739445388317108 | 0.0 | 0.0 | 1.2761123180389404 | 0.0 | 77.34610867500305
58982400 | 0 | 64 | 64 | nan | 2.1070146560668945 | 0.8478346751667338 | 1.8182451725006104 | 0.20259447395801544 | 0.0 | 0.0 | 1.0822179317474365 | 0.0 | 139.76278471946716
73728000 | 0 | 64 | 64 | nan | 0.36819198727607727 | 0.24604142873390022 | 1.949388861656189 | 0.01927480846643448 | 0.0 | 0.0 | 1.1853241920471191 | 0.0 | 51.09560513496399
88473600 | 0 | 64 | 64 | nan | 2.8017988204956055 | 0.8517323145106019 | 1.0938565731048584 | 0.40070152282714844 | 0.0 | 0.0 | 1.077934980392456 | 0.0 | 139.1619906425476
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
