nathmo/running_robot/RLframework/results/curves/dash_s2_eval.csv

step | finishes | falls | n | t_line_mean | dist_mean | speed_mean | track_err | heading_err | alive_frac | bringup_alive | cur_track_err | cur_alive_frac | eval_s
14745600 | 0 | 64 | 64 | nan | 0.6572588086128235 | 0.5041071861565345 | 1.96875 | 0.0 | 0.0 | 0.0 | 1.1906249523162842 | 0.0 | 169.4175181388855
29491200 | 0 | 64 | 64 | nan | 1.7129119634628296 | 0.6975817725593829 | 1.0941399335861206 | 0.4461296796798706 | 0.0 | 0.0 | 1.0903083086013794 | 0.0 | 89.70034575462341
44236800 | 0 | 64 | 64 | nan | 2.547515630722046 | 0.8639682379832168 | 1.3786145448684692 | 0.4706520736217499 | 0.0 | 0.0 | 1.0894358158111572 | 0.0 | 115.62815952301025
58982400 | 0 | 59 | 64 | nan | 3.6467952728271484 | 0.847416684748858 | 1.5036596059799194 | 0.19288337230682373 | 0.078125 | 0.1875 | 0.8947864770889282 | 0.109375 | 233.9894359111786
73728000 | 0 | 48 | 64 | nan | 7.004196643829346 | 1.0723811274800652 | 1.4199309349060059 | 0.11038853973150253 | 0.25 | 0.40625 | 0.8740414381027222 | 0.34375 | 223.9424295425415
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
