nathmo/running_robot/controller/results/loop_budget_100hz.png

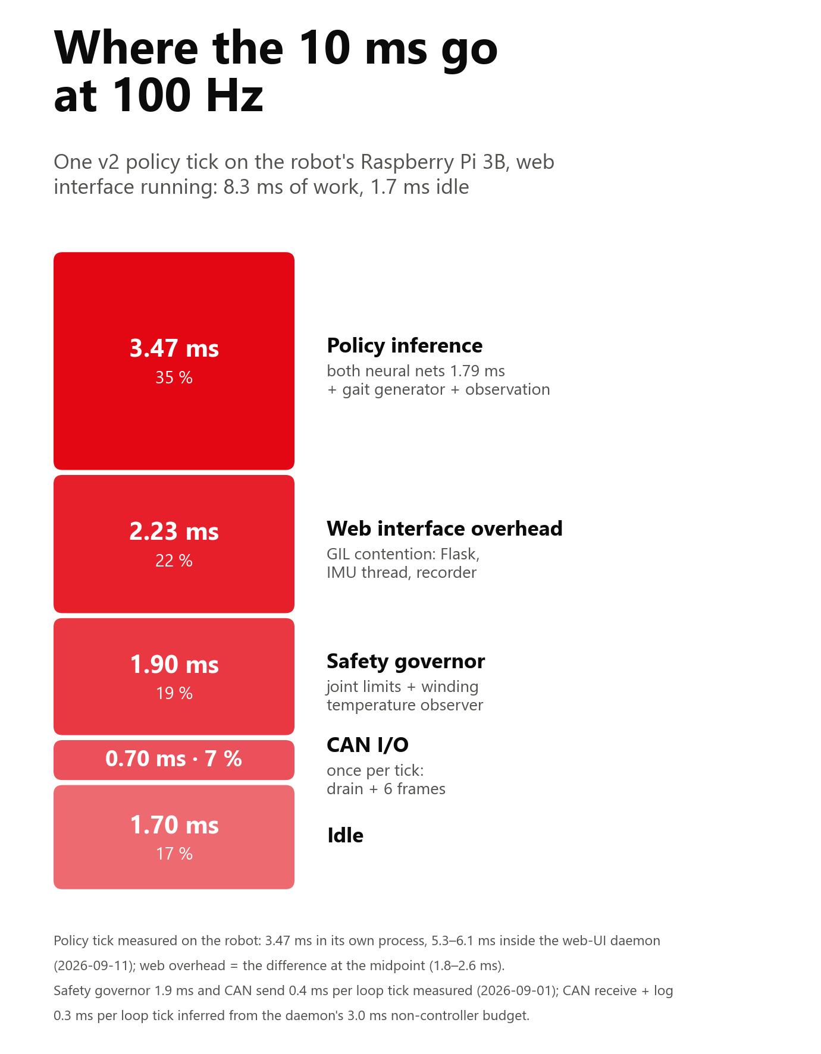
controller/results/loop_budget_100hz.png
