nathmo/running_robot/controller/results/loop_budget_table.png

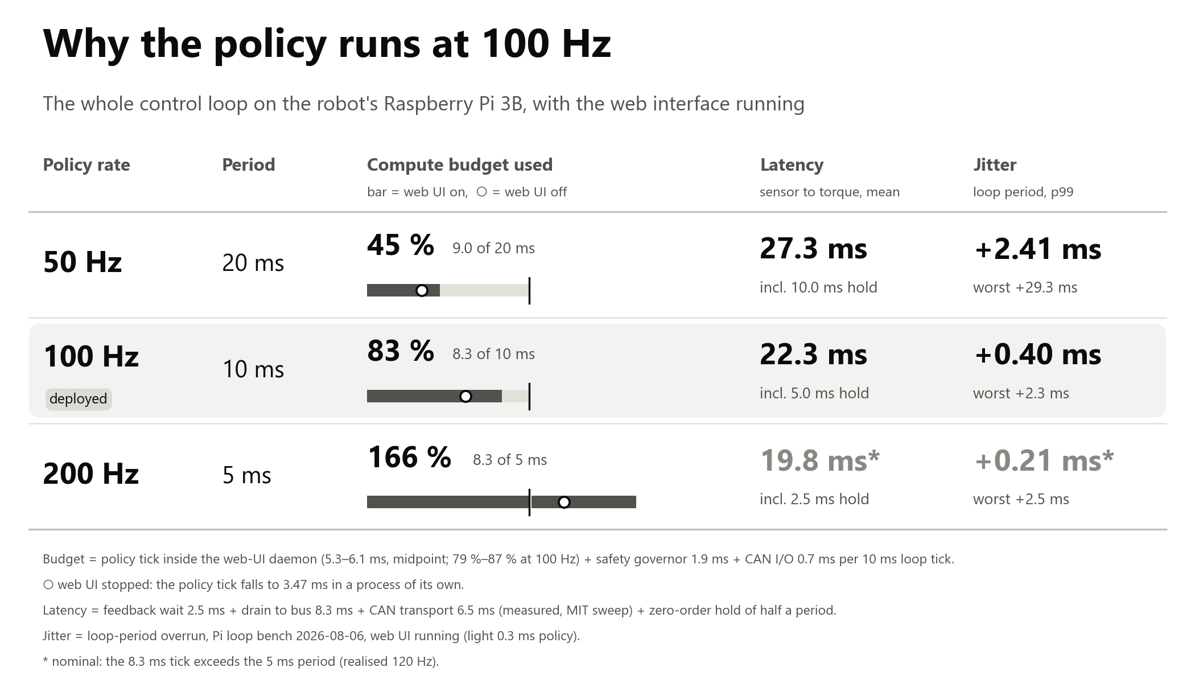
controller/results/loop_budget_table.png
