nathmo/running_robot/controller/results/loop_timeline_100hz.png

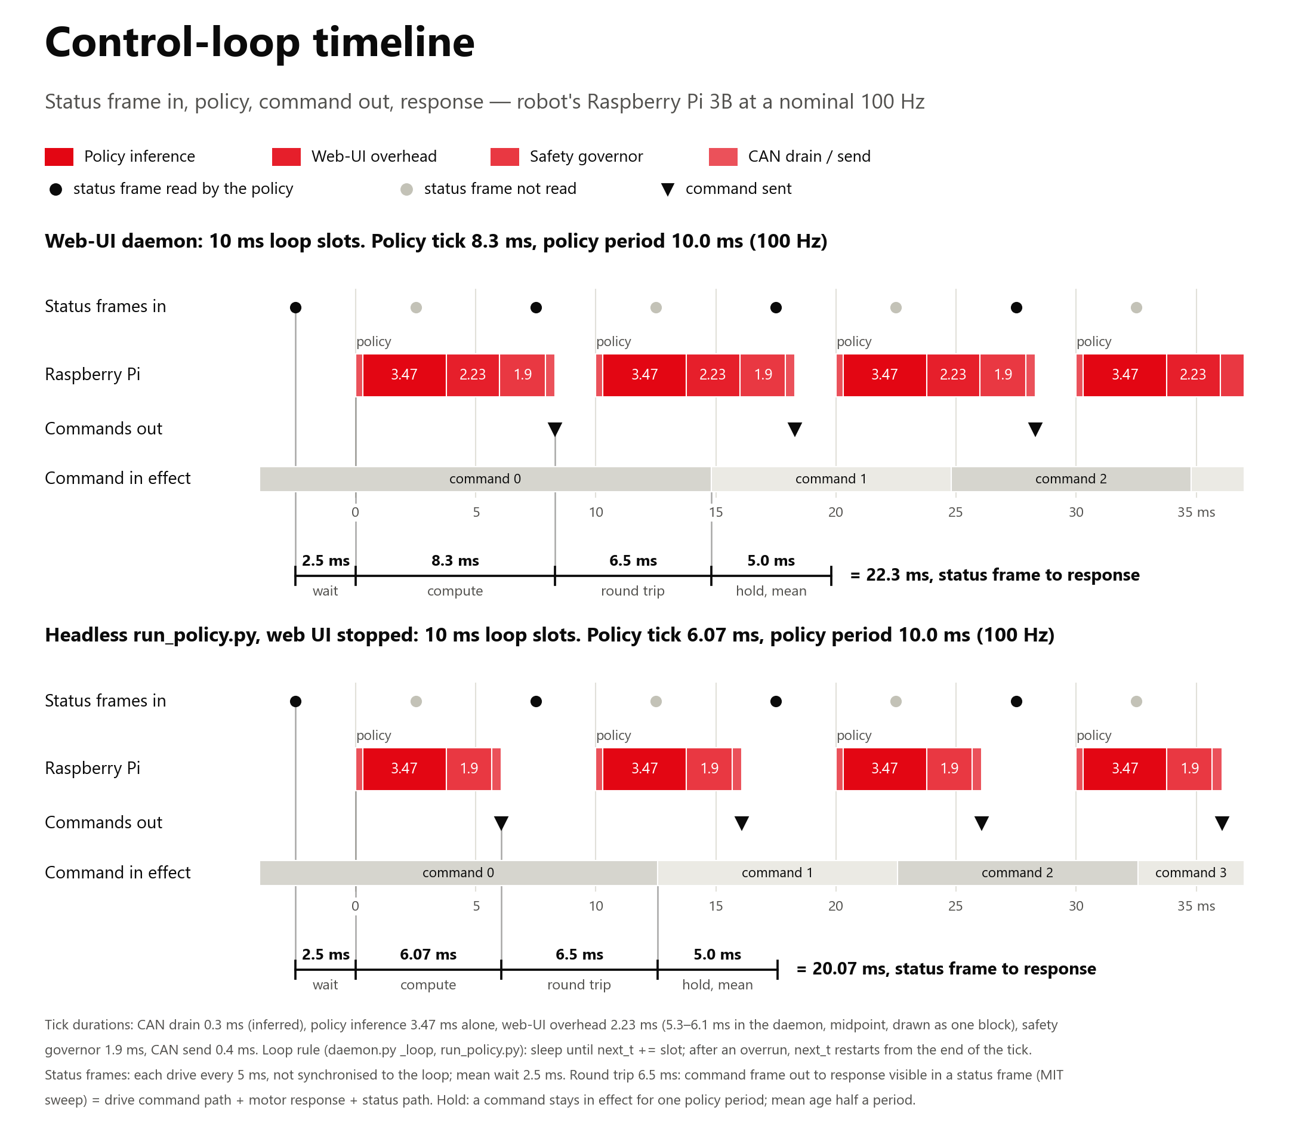
controller/results/loop_timeline_100hz.png
