nathmo/running_robot/RLframework/results/campaign_curves.png

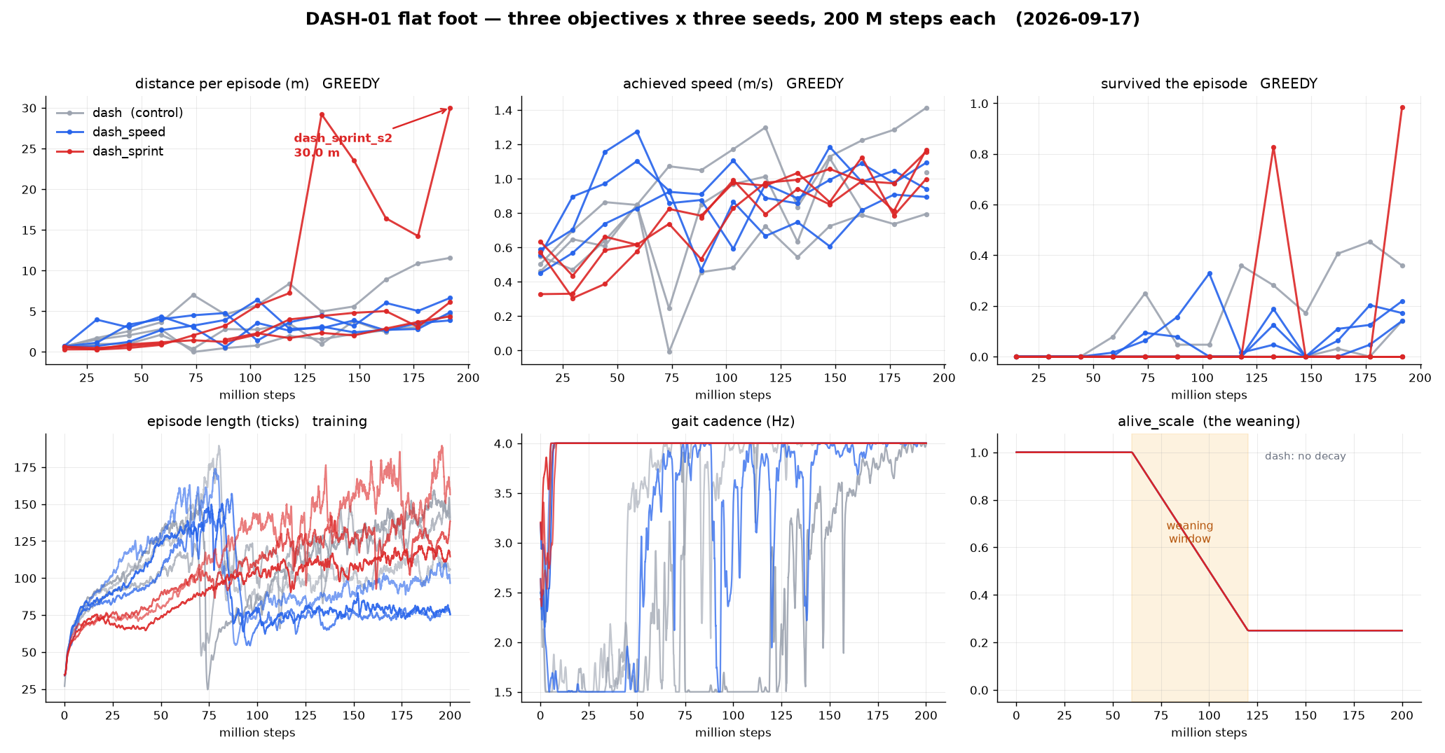
RLframework/results/campaign_curves.png
