nathmo/running_robot/RLframework/results/dash01_foot.png

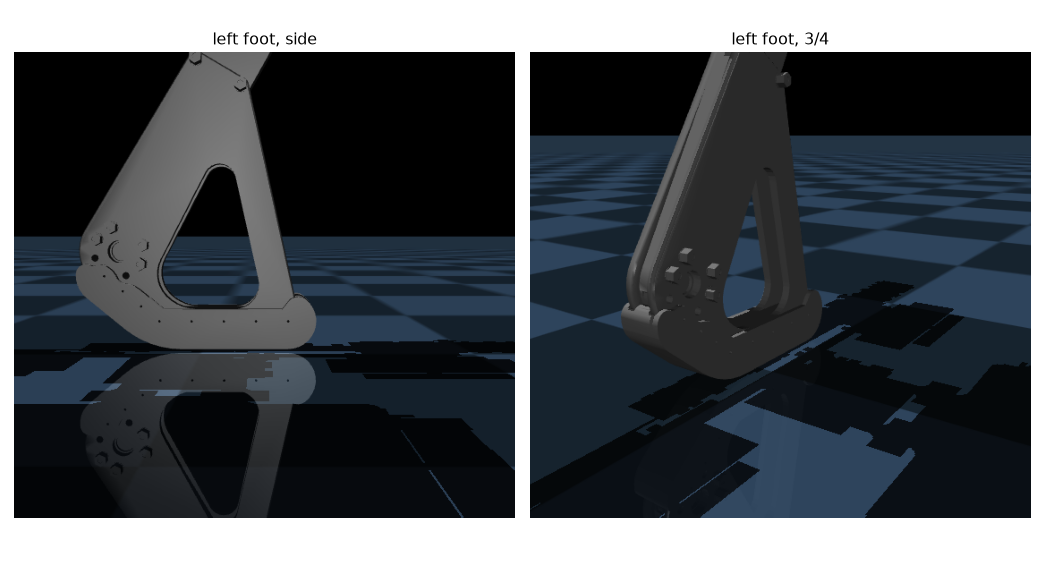
RLframework/results/dash01_foot.png
