nathmo/running_robot/RLframework/results/dash01_keyframe.png

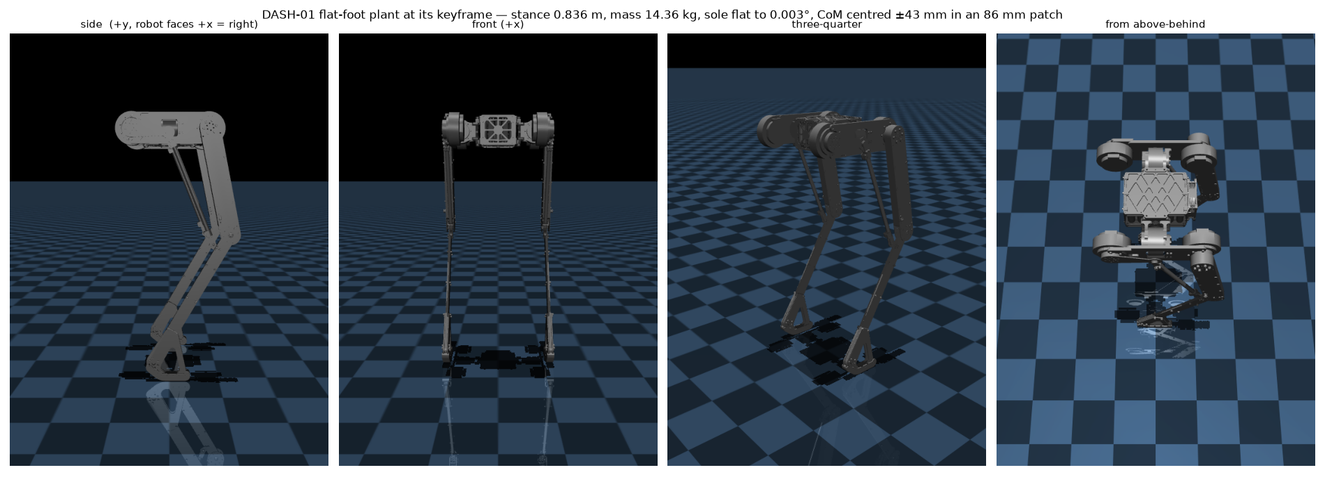
RLframework/results/dash01_keyframe.png
