nathmo/running_robot/RLframework/results/dash01_release.png

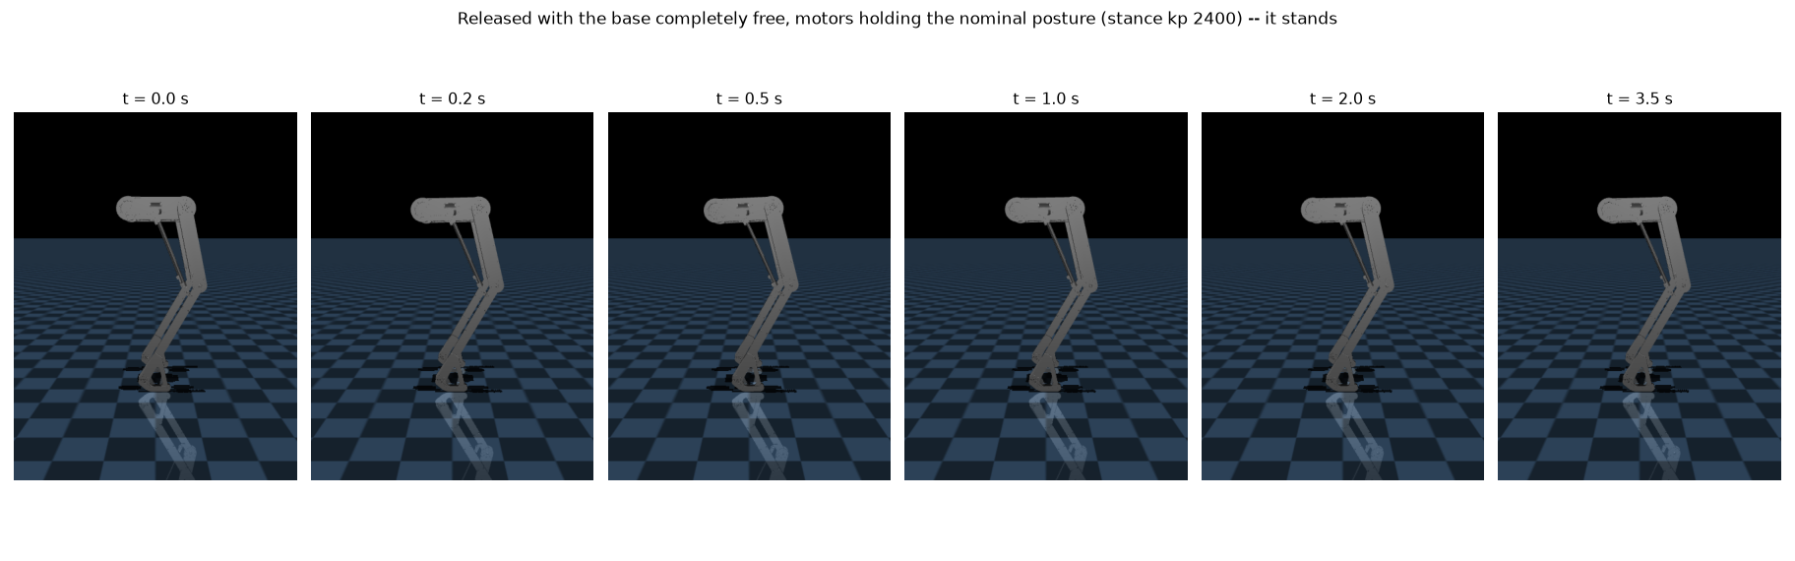
RLframework/results/dash01_release.png
