nathmo/running_robot/RLframework/results/foot_workspace.png

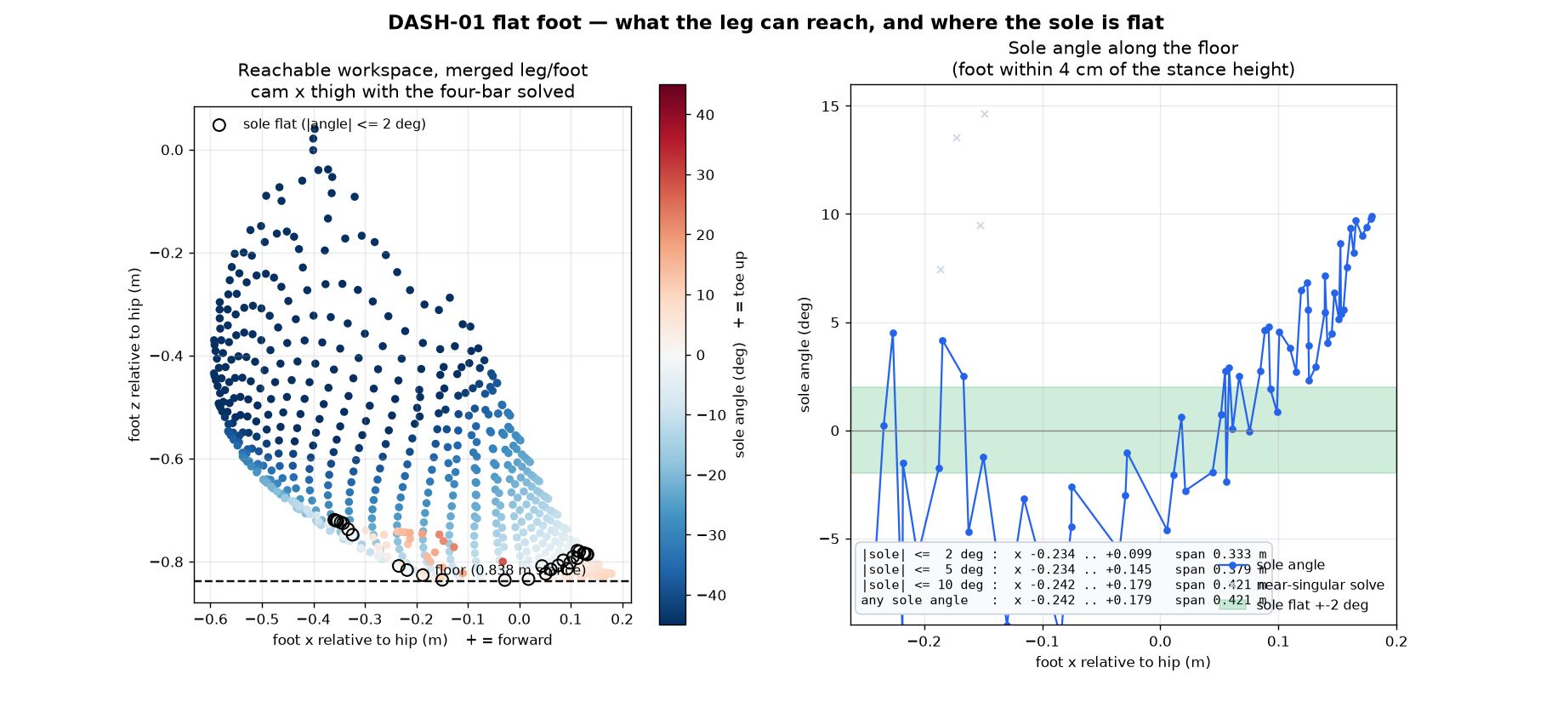
RLframework/results/foot_workspace.png
