nathmo/running_robot/RLframework/results/torque_vs_speed_dash_joy3_lr_s2_180M.png

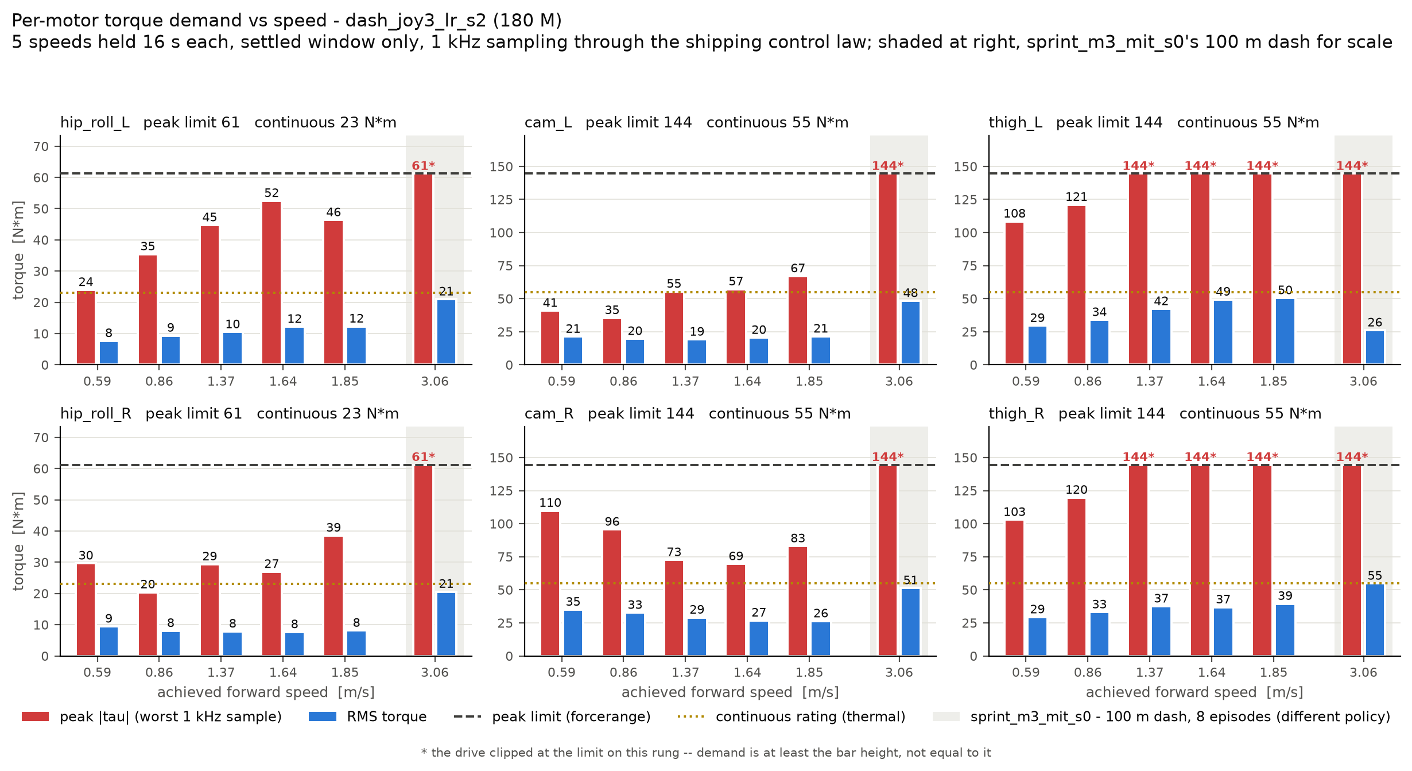
RLframework/results/torque_vs_speed_dash_joy3_lr_s2_180M.png
