nathmo/running_robot/sprint_runner/results/sprint_dash_frame.png

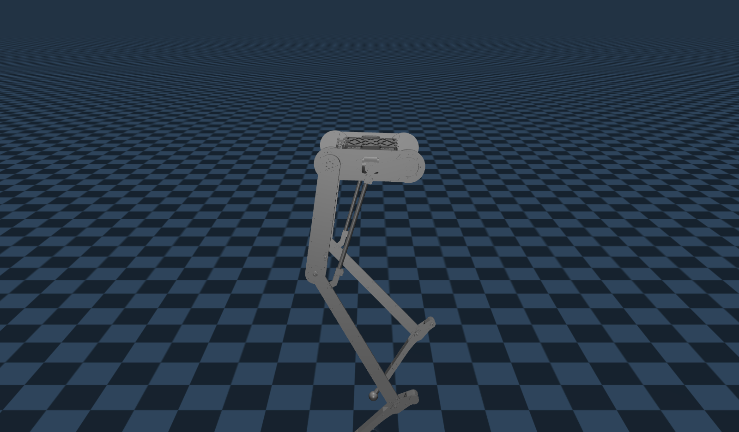
sprint_runner/results/sprint_dash_frame.png
