nathmo/running_robot/sprint_runner/results/sprint_dash_run.png

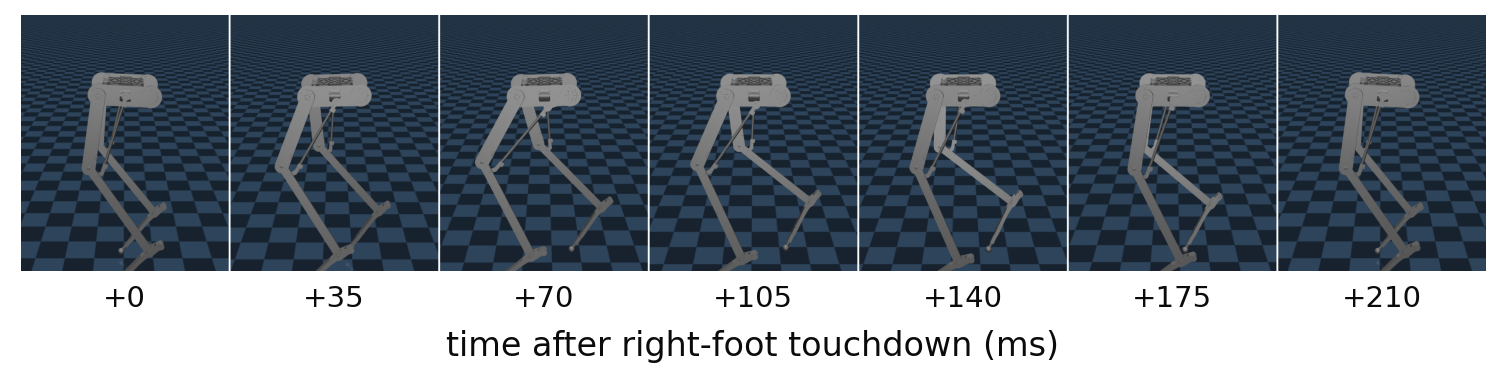
sprint_runner/results/sprint_dash_run.png
