nathmo/running_robot/sprint_runner/results/sprint_dash_stats.png

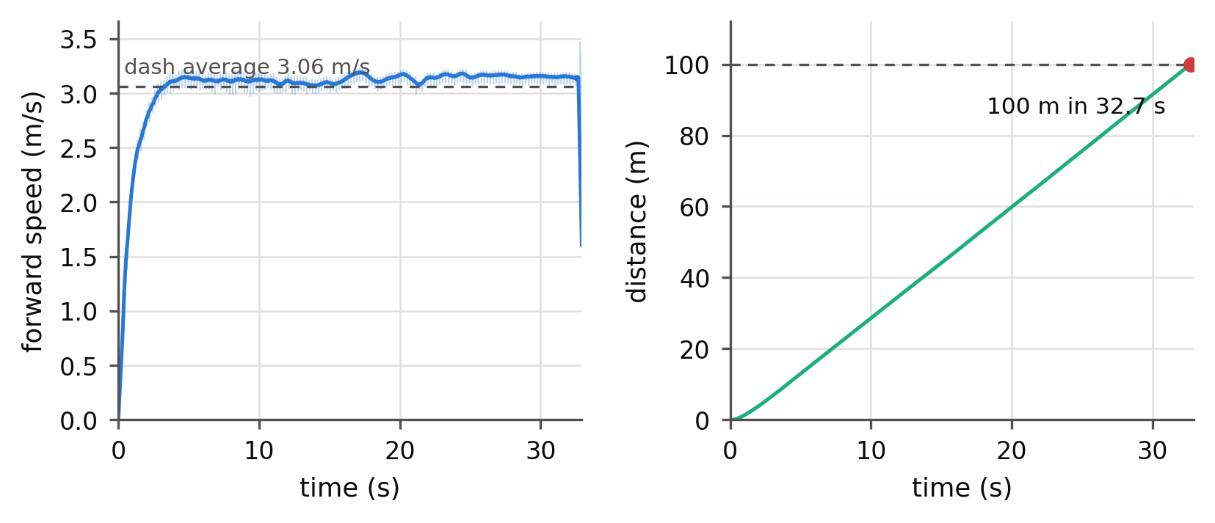
sprint_runner/results/sprint_dash_stats.png
