nathmo/running_robot/sprint_runner/results/sprint_margins.png

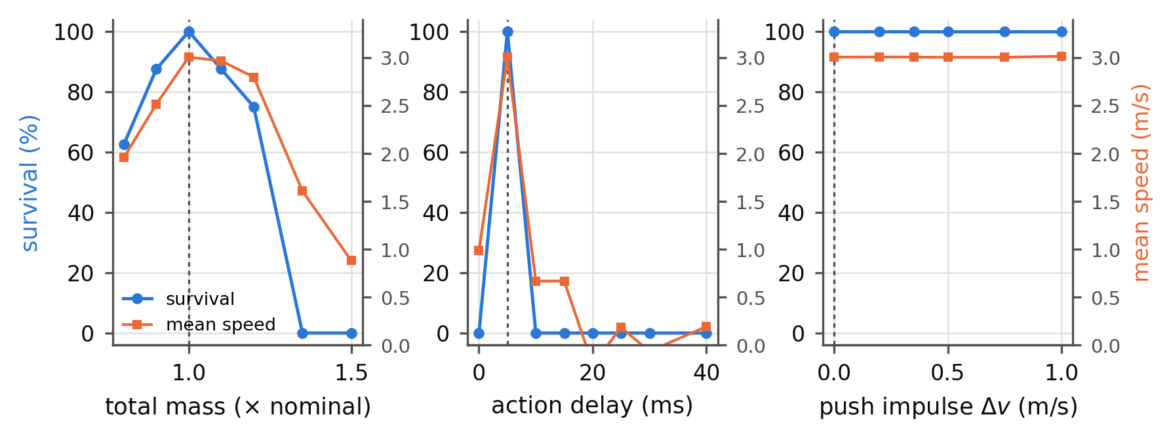
sprint_runner/results/sprint_margins.png
