nathmo/running_robot/sprint_runner/results/sprint_training.png

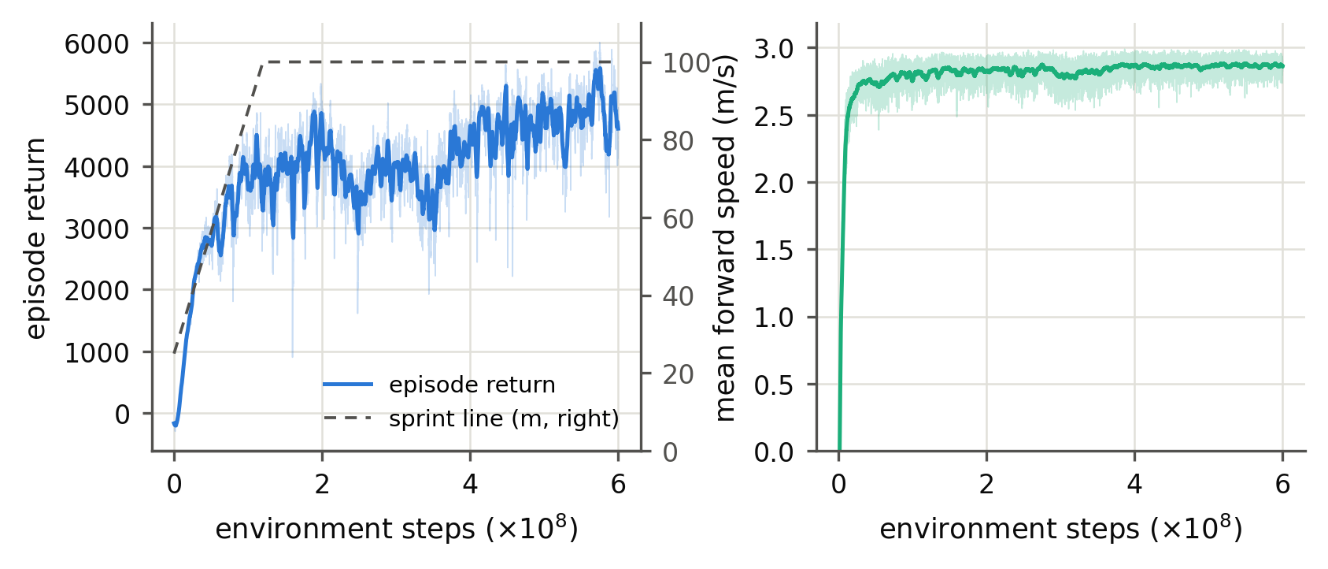
sprint_runner/results/sprint_training.png
