nathmo/running_robot/sprint_runner/results/torque_bars_s0.png

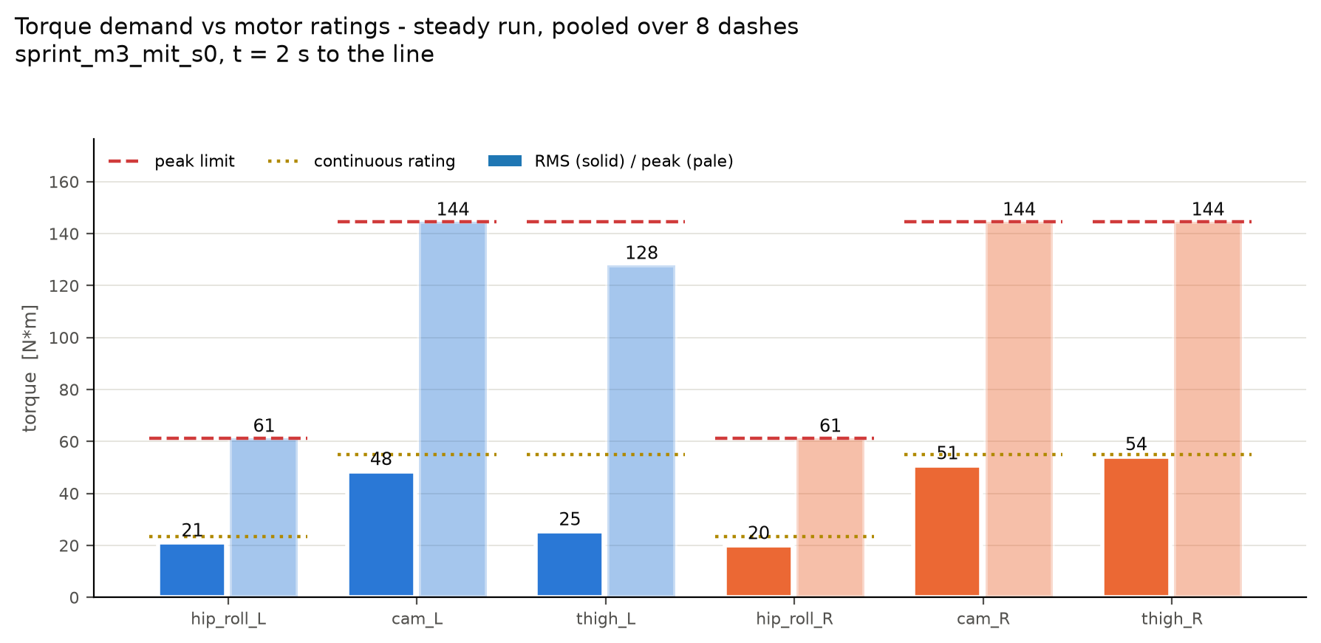
sprint_runner/results/torque_bars_s0.png
