nathmo/running_robot/controller/robotCADdescription/MJCF_OPEN_MUJOCO_B/dash01/dash01.xml

<mujoco model="dash01">
    <compiler angle="radian" />
    <asset>
        <mesh name="bodyNCS-v1" file="meshes/bodyNCS-v1.stl" scale="0.001 0.001 0.001" />
        <mesh name="HipLeftNCS-v1" file="meshes/HipLeftNCS-v1.stl" scale="0.001 0.001 0.001" />
        <mesh name="HipRightNCS-v1" file="meshes/HipRightNCS-v1.stl" scale="0.001 0.001 0.001" />
        <mesh name="CamLeftNCS-v1" file="meshes/CamLeftNCS-v1.stl" scale="0.001 0.001 0.001" />
        <mesh name="CamRightNCS-v1" file="meshes/CamRightNCS-v1.stl" scale="0.001 0.001 0.001" />
        <mesh name="ThighLeftNCS-v1" file="meshes/ThighLeftNCS-v1.stl" scale="0.001 0.001 0.001" />
        <mesh name="ThighRightNCS-v1" file="meshes/ThighRightNCS-v1.stl" scale="0.001 0.001 0.001" />
        <mesh name="LegLeftNCS-v1" file="meshes/LegLeftNCS-v1.stl" scale="0.001 0.001 0.001" />
        <mesh name="LegRightNCS-v1" file="meshes/LegRightNCS-v1.stl" scale="0.001 0.001 0.001" />
        <mesh name="FootLeftNCS-v1" file="meshes/FootLeftNCS-v1.stl" scale="0.001 0.001 0.001" />
        <mesh name="FootRightNCS-v1" file="meshes/FootRightNCS-v1.stl" scale="0.001 0.001 0.001" />
        <mesh name="PushrodLeftNCS-v1" file="meshes/PushrodLeftNCS-v1.stl" scale="0.001 0.001 0.001" />
        <mesh name="PushrodRightNCS-v1" file="meshes/PushrodRightNCS-v1.stl" scale="0.001 0.001 0.001" />
    </asset>
    <worldbody>
        <light directional="true" pos="-0.5 0.5 3" dir="0 0 -1" />
        <geom pos="0 0 0" size="1 1 1" type="plane" rgba="1 0.83 0.61 0.5" />
        <body name="bodyNCS-v1" pos="0.0 0.0 0.0" euler="-0.0 0.0 -0.0">
            <geom name="bodyNCS-v1_geom" type="mesh" mesh="bodyNCS-v1" pos="0 0 0" euler="0 0 0" />
            <inertial mass="1.8141006934908845" pos="0.0016690918854414011 4.297697354650468e-07 9.498539066587414e-06" fullinertia="0.012823544204434234 0.004661054292120578 0.015210658991172597 8.889789342507086e-08 1.4632265547397721e-06 5.980362454802101e-07" />
            <body name="HipLeftNCS-v1" pos="0.027294924660796353 0.12800000000861275 2.943479741862386e-11" euler="-0.0 2.15060487902769e-16 -0.0">
                <joint name="bodyNCS-v1_Révolution-1" type="hinge" axis="0.9999999999999929 0.0 2.1506048790276748e-16" pos="7.533920364649563e-08 -8.612749402558961e-12 -2.943479741860745e-11" />
                <geom name="HipLeftNCS-v1_geom" type="mesh" mesh="HipLeftNCS-v1" pos="0 0 0" euler="0 0 0" />
                <inertial mass="1.0501006524075551" pos="-0.023170080111601033 0.016018447983417783 0.00019232179773001127" fullinertia="0.001026188966625481 0.015466200097397577 0.01506012726703141 0.0003279313134294341 3.2969505953294785e-07 5.665805698538075e-06" />
                <body name="CamLeftNCS-v1" pos="-0.149 0.05190000000000062 -2.404748004659806e-17" euler="-0.0 0.0 -0.0">
                    <joint name="HipLeftNCS-v1_Révolution-3" type="hinge" axis="0.0 1.0 0.0" pos="7.53392025709676e-08 -8.613360025222505e-12 -2.943480541514031e-11" />
                    <geom name="CamLeftNCS-v1_geom" type="mesh" mesh="CamLeftNCS-v1" pos="0 0 0" euler="0 0 0" />
                    <inertial mass="0.013438060017115797" pos="0.04624089887284015 0.0010000000000000143 2.6437697658976432e-17" fullinertia="2.451235110088564e-06 3.092731646986336e-05 2.8485040066453054e-05 2.710505431213761e-20 4.4849776825713306e-20 6.217248947447439e-22" />
                    <body name="PushrodLeftNCS-v1" pos="0.12 0.0020000000000000287 5.431898664463379e-17" euler="-2.7225169560989797e-16 -0.18047963198315084 -4.6730848860369244e-17">
                        <joint name="CamLeftNCS-v1_Révolution-11" type="hinge" axis="-2.1387213778918383e-18 -1.0 -2.6782970497536714e-16" pos="7.411023789274043e-08 -8.613387780794649e-12 -1.3552451771001049e-08" />
                        <geom name="PushrodLeftNCS-v1_geom" type="mesh" mesh="PushrodLeftNCS-v1" pos="0 0 0" euler="0 0 0" />
                        <inertial mass="0.045198290927437025" pos="-0.001446515823232096 0.0009770750294905441 -0.19135709372461382" fullinertia="0.0009971743464509463 0.0009977072590840932 2.7437611486152885e-06 -5.985238375484134e-08 -2.0612523046672094e-07 2.190188856696195e-08" />
                    </body>
                </body>
                <body name="ThighLeftNCS-v1" pos="0.10100000000000005 0.046100000000000314 -5.91526827518629e-15" euler="-0.0 0.0 -0.0">
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
                        </body>
                    </body>
                </body>
            </body>
        </body>
    </worldbody>
</mujoco>
