nathmo/running_robot/sprint_runner/results/torque_stride_s0.pdf

## One second at steady state (t = 16-17 s)

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

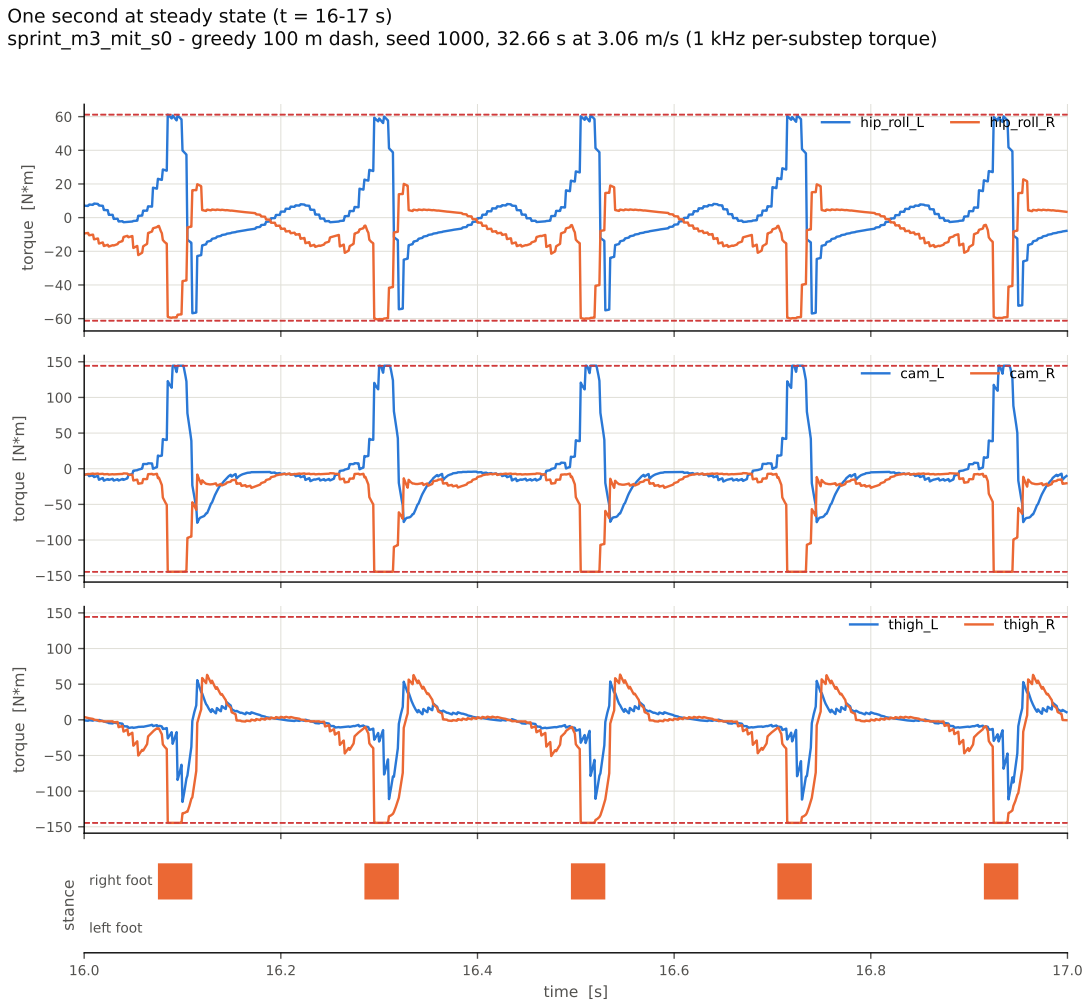
[picture p51: page 1]
torque [N*m]; hip_roll_L; hip_roll_R; cam_L; cam_R; thigh_L; thigh_R; time [s]; stance; left foot; right foot
