nathmo/running_robot/sprint_runner/results/sprint_dash_stats.pdf

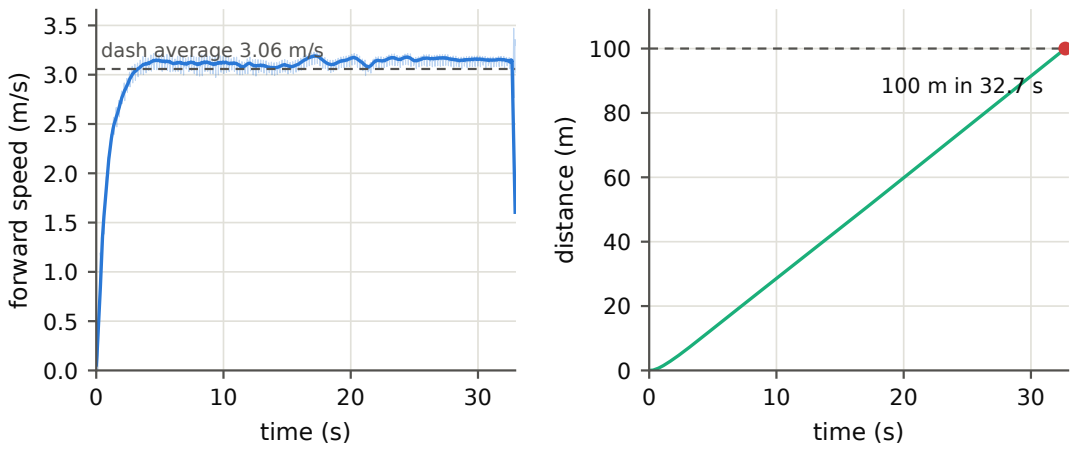
[picture p52: page 1]
time (s); forward speed (m/s); dash average 3.06 m/s; distance (m)
