nathmo/running_robot/sprint_runner/results/sprint_margins.pdf

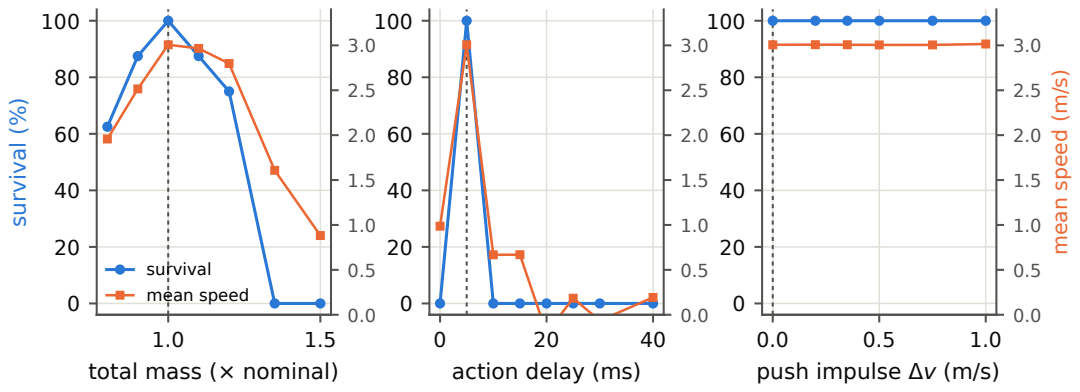
[picture p53: page 1]
survival (%); mean speed (m/s)

survival
mean speed
total mass (× nominal)

action delay (ms)

push impulse Δv (m/s)
