nathmo/running_robot/sprint_runner/results/sprint_training.pdf

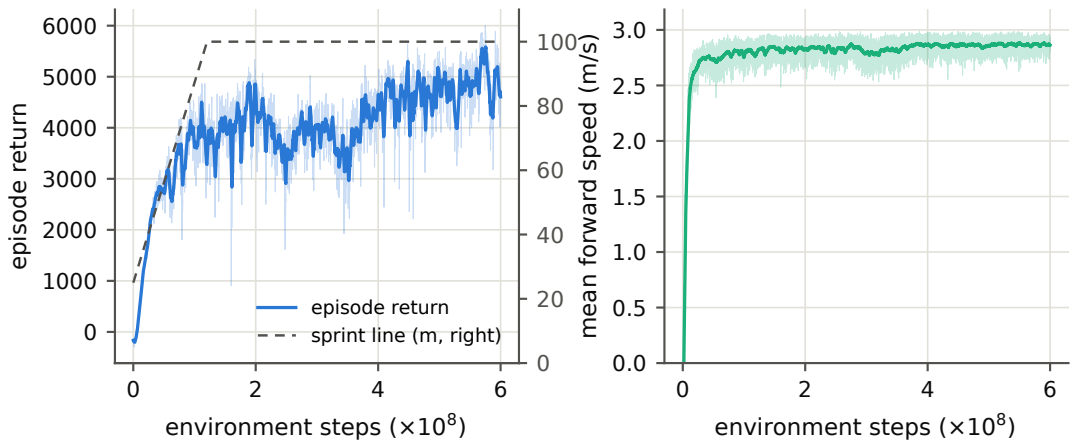
[picture p54: page 1]
vir; episode return

mean forward speed (m/s)

episode return
sprint line (m, right)
