nathmo/running_robot/(commit log)

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2026-04-17 Enhance RL environment with StraightPath and improved reward structure
    - Added StraightPath class for infinite straight line path representation.
    - Updated PATHS configuration in config.py to include a straight_line option.
    - Modified LeggedRobotEnv to support straight line paths and adjusted path reset logic.
    - Enhanced reward configuration with new terms for forward speed, upright penalty, feet air time, and fall penalty.
    - Improved reward calculation in _get_reward method to incorporate new reward terms.
    - Added foot contact tracking and airtime reward mechanism to encourage stepping gait.
    - Updated visualize_policy script to support interactive selection of runs and epochs.
    - Refactored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
    [config.py, paths.py]
2026-04-20 reworked start position to make learning easier
    [config.py]
2026-04-21 fixed visualition bug, retuned learning parameters
    [config.py, train.py]
2026-04-21 toy problem with inverted pendulum to try the sim2real step
    [config.py, train.py]
2026-05-20 added robot URDF and rewriting the simulator
    [000_Assy_Full.SLDASM.csv, 000_Assy_Full.SLDASM.urdf, Achilles Tendon Left.STL, Achilles Tendon Right.STL, Femur Left.STL, Femur Right.STL, Foot Left.STL, Foot Right.STL]
2026-05-22 slowly trying to fix the URDF manually, will be reexported from solidworks with fixed angle
    [000_Assy_Full.SLDASM.urdf, running_robot_debug.xml]
2026-06-02 No Loop URDF work, added CAD too
    [000_Assy_Full.SLDASM.csv, 000_Assy_Full.SLDASM.urdf, Achilles Tendon Left.STL, Achilles Tendon Right.STL, AssemblyURDF.urdf, CamLeft.iam, CamLeft_Simplify_1-v1.stl, CamLeft_Simplify_1.ipt]
2026-06-19 regenerated CAD + URDF + MJCF + SDF
    [AssemblyURDF.urdf, CamLeft.iam, CamLeftNCS-v1.stl, CamLeftNCS.iam, CamLeftNCS.ipt, CamLeftNCS.stp, CamLeft_Simplify_1-v1.stl, CamLeft_Simplify_1.ipt]
2026-06-22 training standing policy
    [spiderbot.xml]
2026-06-24 policy for standing seems to converge
    [spiderbot.xml]
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2026-07-04 tried something else to prevent the spin around on a toe
    [config.py, env.py, train.py]
2026-07-04 training run was not long enough, resuming but promising
    [progress.csv]
2026-07-06 v3 anti-skating rebuild: gait-shaping reward, honest contact physics, motor masses
    The m2_walk policy scored ~1700 reward while SKATING: both feet grounded
    57-66% of steps, translation entirely from loaded-foot slip (~0.2 m/s),
    median "swing" one control step, and -0.09 m/s actual speed under a
    +0.5 m/s command (measured with an instrumented rollout, not eyeballed).
    Model (build_model.py, regenerated spiderbot.xml):
    - condim 3->6 with realistic rubber-pad torsional/rolling friction (at
    condim=3 those coefficients were silently ignored: the toe spheres were
    frictionless ball casters - also the old spin-on-a-toe bug), impratio=10
    (kills mm/s sub-friction-cone creep), crisper contact sol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
    [spiderbot.xml]
2026-07-06 latest training unsucessfull, pushing it + new policy
    [progress.csv]
2026-07-06 validate_model: never retry a failed GL init (headless second attempt aborts from C++)
    All physics gates pass headless; only the cosmetic PNG renders are skipped.
    Set MUJOCO_GL=egl or osmesa on a server to get the PNGs.
    [validate_model.py]
2026-07-06 removed failed training run
    [progress.csv]
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2026-07-06 trying more motor control
    [progress.csv]
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2026-07-06 fixed bug in training that was introduced earlier today...
    [progress.csv, spiderbot.xml]
2026-07-07 removed old training run and make script to record walking gait manually + play back
    [progress.csv]
2026-07-07 pushed recorded trajectory
    [progress.csv]
2026-07-08 updated trajectory playback
    [progress.csv]
2026-07-08 leg recording fix
2026-07-09 added clean worksapce + trajectory with zeroes motor in same position as URDF
2026-07-10 fixed for the leg visualisation
    [fklut.py, server.py]
2026-07-14 another training run that failed to enven stand...
    [progress.csv]
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2026-07-14 fixed naming scheme to dash-01
    [CamLeftNCS-v1.stl, CamRightNCS-v1.stl, FootLeftNCS-v1.stl, FootRightNCS-v1.stl, HipLeftNCS-v1.stl, HipRightNCS-v1.stl, LegLeftNCS-v1.stl, LegRightNCS-v1.stl]
2026-07-14 refactored training system to restrict base DOF (simplify problem for RL)
    [dash01.sdf, dash01.urdf, dash01.xml]
2026-07-14 implemented fourrier controller with RL for fourrier parameters
    [progress.csv]
2026-07-15 updated reward for full 100m sprint
    [progress.csv]
2026-07-15 added free height DOF
    [progress.csv]
2026-07-16 aded more milestone RL policy
    [progress.csv]
2026-07-17 updating training env
    [progress.csv]
2026-07-17 cleaned the repo
    [CamLeft.iam, CamLeftNCS-v1.stl, CamLeftNCS.iam, CamLeftNCS.ipt, CamLeftNCS.stp, CamRight.iam, CamRightNCS-v1.stl, CamRightNCS.iam]
2026-07-21 m3 pitch-stability fixes: reflex + angmom reward + VecNormalize rejuvenation
    m3 (X,Z,pitch free) fell in ~1.5s. Three compounding causes, all fixed:
    - fixed pitch reflex in fourier_gait.assemble (symmetric thigh offset PD on
    pitch/pitch-rate; pure numpy, ships to Pi; inert on m1/m2 so checkpoints load)
    - centroidal angular-momentum reward (mj_subtreeVel, pitch component; w_angmom=0.2
    on m3+ presets)
    - VecNormalize warm-start rejuvenation (cap count + floor var so a newly-freed DOF
    is observable from batch one, not binarized/clipped)
    Gains kp=2.0/kd=0.2/clip=0.25 grid-tuned. New smoke tests (reflex sign/clip/kick-
    arrest, angmom, rejuvenate) pass; 1.5M pilot shows a healthy dip-then-re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
    [config.py, env.py, fourier_gait.py, smoke_test.py, train.py]
2026-07-22 m3 anti-topple: entropy-anneal deadline fallback + speed-uprightness gate
    m3_speed_v2 fell for its whole 150M-step run. Root causes:
    - EntropyCallback annealed ent_coef only after a competence gate (air_time
    > 0.02) that never opened, so std stayed pinned at max_log_std the entire
    run -> actions noise-dominated -> no stable gait could form.
    - Uncapped fwd_speed income (+2.15/step) rewarded lunging toward the
    inevitable fall.
    Fixes (pitch-free presets m3..m6 via _extras):
    - ent_anneal_deadline_steps (m3=25M): open the anneal on the competence gate
    OR a hard step deadline, so exploration finally collapses even if the gate
    stays shut. Warm-start/resume interop preserved.
    - speed_upri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
    [config.py, env.py, train.py]
2026-07-22 feat(webui): dynamic parameter identification (Kt, inertia, friction)
    Adds a system-ID stage to the DASH-01 web UI to derive real dynamic
    parameters from the base-fixed robot, closing the sim-to-real loop.
    Capture (Pi):
    - daemon MEASURE mode: single-leg position chirps, 200 Hz torque/pos log,
    full-envelope workspace pre-validation + live safety net
    - routes: /api/measure/*, /api/dynamics/{mass,pid}, /api/model/inertia,
    /api/identify/{run,import}, /api/mesh/*
    - dynstore (weighed masses + drive PID + Kt), measurestore (npz runs)
    Estimator (robot/identification/, mujoco+scipy):
    - data-driven per-joint regression (Kt + reflected inertia + viscous/
    Coulomb friction); avoids mj_inverse-thr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
    [build_model.py, daemon.py, dynstore.py, measurestore.py]
2026-07-22 pushed trianing runs on IZAR
    [progress.csv]
2026-07-22 m3 anti-topple sweep: competence-gated curriculum + balance-first presets
    m3 (X+Z+pitch free) still collapses at the passive-fall time (ep_len ~60 = 1.2s)
    with a hard forward lunge (peak vx ~3.7 m/s), despite the pitch-reflex + entropy-
    deadline + upright-gate stack. Confirmed via local eval of m3_speed_v2 and the live
    v3 curriculum.json (stance_ratio 0.42 / eff_scale 1.0 fully ramped, still stuck).
    Root cause: the clock-driven stance_ratio + efficiency ramps harden toward flight-
    phase running + full efficiency from step 0, whether or not the robot ever learned
    to balance the freed pitch DOF. It is perpetually asked to run before it can hold
    height, so it rides the passive collapse down. S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
    [config.py, train.py]
2026-07-22 m3 round 2: decaying pitch-assist (m2->m3 bridge) after easing sweep plateaued
    The round-1 balance-first easing sweep plateaued at ep_len ~67 (the passive-collapse
    time) by 23M steps across ALL 7 variants -- including m3_noeff (efficiency off) and
    m3_walk (no flight + low speed + efficiency off). So removing the running/efficiency
    demands is NOT enough: the m3 policy cannot discover a pitch-stable, height-holding
    gait from the m2 (pitch-LOCKED) warm-start. Reward/curriculum is not the bottleneck.
    Fix: a soft, DECAYING pitch-assist training-wheel that bridges m2->m3. An external
    spring-damper torque on the base pitch joint (toward level, written to qfrc_applied)
    holds the body near upright e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
    [config.py, env.py, smoke_test.py, train.py]
2026-07-22 m3 round 3: fix the pitch-assist crutch-dependence (stand-still loophole)
    Round-2 assist FAILED. assist=0 eval of m3_assist / m3_assist_gated at 23M gave
    ep_len 39-50 -- WORSE than the 67 plateau -- with NEGATIVE mean vx. The in-training
    ep_len ~100+ was entirely the wheel holding the body up.
    Mechanism: SPEED mode pays a per-step `alive` bonus (0.5) with NO penalty for standing
    still. Once the assist removes the fall risk, "stand still and bank alive" is optimal,
    so the policy learned neither balance nor locomotion (it drifts backward). m2 succeeded
    because SPRINT's per-step clock cost makes standing strictly negative -> forward pressure.
    Round-3 closes the stand-still loophole so the ass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
    [config.py]
2026-07-23 m3 round 4: anti-crutch assist-reliance penalty (w_assist_penalty)
    Round-3 assist=0 eval at 16.6M collapsed to ep_len 14 with 0 m travelled -- the
    decaying assist ALONE still bred full crutch-dependence even in sprint mode. Root
    design flaw of decaying-assist curricula: nothing rewards NOT needing the assist, so
    the policy maxes the crutch at every fade level and never internalizes balance.
    Fix: w_assist_penalty prices the assist torque the policy provokes (t["assist_pen"] =
    -_pen(w * assist_torque^2)). Balance well (pitch ~0 -> assist ~0 N*m) -> pay nothing;
    lean on the wheel -> pay. Decouples the dense fall-catching safety net from a reward
    for SELF-balance, so the policy learns pitch con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
    [config.py, env.py]
2026-07-23 m3 round 5: pitch slow-motion via base-pitch armature (non-crutch)
    The whole external-assist family is exhausted. Round-4 anti-crutch penalty assist=0
    eval: m3_assist_pen ep_len 34, m3_assist_pen_hi 20 (backward) -- no better than the
    no-penalty control (32). Every position-holding assist (rounds 2-4) balances FOR the
    policy -> collapses at assist=0.
    Round 5 tries a NON-holding curriculum: extra armature (rotor inertia) on the base
    pitch DOF makes the fall sluggish (longer time constant) so the 50 Hz policy has time
    to learn foot-placement balance, then the extra inertia fades to 0. It never holds
    position -> NO crutch: the robot balances itself throughout, so the in-training ep_len
    IS the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
2026-07-23 200 Hz reactive-stepping stack + sim2real timing curriculum
    Move the control loop 50 -> 200 Hz (physics sim stays 1 kHz; decimation 20 -> 5) so the
    policy can do fast reactive foot-placement stepping -- the balance channel the passive-
    ankle m3 plant needs. Rescale every 50 Hz-coupled constant so nothing silently breaks:
    - REWARD made rate-invariant IN THE ENV: the summed per-step reward is scaled by
    control_dt/0.02 (per-second income/penalty invariant; fall/finish EVENTS unchanged;
    exact no-op at 50 Hz -> m1/m2 byte-identical). Keeps the suicide-proofing/stop-farm math.
    - gamma 0.99 -> 0.9975 (=0.99^0.25, same ~2 s horizon); action_delay 1 -> 4 steps
    (same ~20 ms Pi+CAN latency); act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
2026-07-23 m3_reactive_hi: more reactive authority (residual 0.3, filter 0.25, thigh 0.55) after base plateaued @206
2026-07-23 m3_reactive_x: max reactive authority (residual 0.4, filter 0.1) after hi also plateaued ~196
2026-07-23 m3_ankle: fixed ankle-torque reflex (emulated actuated ankle) - tests if ankle pitch authority fixes m3 balance after all foot-placement authority plateaued
    [config.py, env.py, smoke_test.py]
2026-07-23 m3_ankle: soften ankle reflex to kp100/clip12 (40Nm destabilized the running gait, ep_len 28)
2026-07-23 m3_lowcom: test lower-CoM (cheapest candidate hardware fix) in sim - shifts base CoM down 0.15/0.30m, warm-startable from m2
    [config.py, env.py]
2026-07-23 fix com_lower: shift ALL bodies (base is only 14% of mass); CoM now drops ~6/12cm for 0.15/0.30
    [env.py]
2026-07-24 m3 ankle-stiffness + foot-ahead-of-CoM experiment (2026-07-24)
    Two cheap levers vs the m3 free-pitch ~1s balance plateau, both warm-started
    from m2_reactive:
    - ankle_stiffness/ankle_damping: stiffen the passive ankle spring for more
    passive pitch-restoring torque in stance. The standing ankle sits +-0.25 rad
    off the spring's +-0.7 rest angle (preloaded ~12.8 N*m), so raising k alone
    balloons the preload and flips the robot (verified: raw k=200 -> grav_z +0.80,
    height -0.41). env.py shifts springref to PRESERVE the standing preload, so
    only the restoring gain rises and posture is unchanged (verified upright).
    - w_foot_ahead: reward planting the stance foot AHEAD of the whole-robot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
    [config.py, env.py, smoke_test.py]
2026-07-24 add diagnose_foot_com.py: quantify foot placement vs CoM
    Rolls out a policy and plots toe_x - subtree_com[0].x per foot + base pitch,
    prints touchdown stats (fraction landing ahead of CoM, mean offset). Built to
    test whether the m3 policy uses the capture step; result on m3_reactive_x: it
    pitches forward (grav_x -> +0.88 topple) but plants feet ~8-9 cm BEHIND the CoM
    (only ~40% land ahead), confirming it never learned to step ahead to catch the
    fall. --stochastic samples like training (these policies kept std=1).
2026-07-24 fix evaluate.py: restore sprint_dist_m from curriculum.json at eval
    build() restored stance_ratio + eff_scale from curriculum.json but not the
    sprint line distance, so a mid-training sprint checkpoint was evaluated with
    the finish line at the final 100 m instead of its curriculum distance -> the
    dist-to-go task obs was out of distribution and greedy behavior degraded badly
    (m2_reactive at 100 m: collapses BACKWARD in ~1 s, mean vx -1.0; at its true
    46.8 m: runs forward +1.26 m/s and balances ~20 s, ep_len 4130). Now restores
    sprint_dist_m too, matching how stance_ratio/eff_scale are already handled.
    [evaluate.py]
2026-07-24 m3 ankle sweep: add stiffer k=550/750 variants (chase the stiffness gradient)
    The running sweep shows a clean monotonic ep_len gain with ankle stiffness
    (k=350 climbing past 330 by 13M while k=90/200 flatten ~245, foot-ahead alone
    stays at baseline ~213). Add m3_stiff_xhi (k550) and m3_stiff_xxhi (k750) to
    find where the benefit saturates. Preload-preserving (validated stable/upright
    to k=1000). Warm-started from m2_reactive.
    [config.py]
2026-07-24 add motor velocity/accel limits + cadence penalty (minimise stepping freq)
    The plant capped torque + range but NOT velocity or acceleration, so the k350
    winner balanced m3 by pattering one foot at ~11 Hz (peak joint 23 rad/s, at the
    210 RPM ceiling), left leg held up. Add the missing limits + a cadence term:
    - motor_vel_limit / motor_accel_limit: slew-limit the commanded target so joint
    velocity <= limit and its rate <= limit (a velocity/accel-bounded position
    servo = the real moteus limits). Applied in _run_physics after the EMA+clip.
    - w_contact_switch: penalize each foot that flips grounded<->airborne per step
    -> fewer, longer steps, balanced against phase_contact (which demands sw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
    [config.py, env.py, smoke_test.py]
2026-07-24 add diagnose_cadence.py: gait cadence / symmetry / motor-limit diagnostic
    Reports per-foot stepping frequency + duty, an L/R asymmetry index (0=even
    two-legged, 1=one-legged), joint velocities vs the 22 rad/s motor ceiling, and
    torque saturation; writes a contact-raster + thigh-velocity plot. Baseline on
    the k350 winner: asymmetry 0.97, 5.4 Hz/foot, thigh_R 22.6 rad/s, torque never
    saturates -- quantifies the one-legged 11 Hz chatter the cadence experiment
    targets. Built to evaluate the m3_cad* runs against this.
2026-07-24 m3 cadence: add accel-relaxed hedge (accel=1000) after m3_cad* stalled at ~80
    The accel=300 cap blocks the reactive foot-placement balance needs -> cad*
    stuck at ep_len ~80 with no recovery by 12M (incl. the limits-only control).
    m3_cad_a1000 loosens accel to ~torque-limited while keeping the 22 rad/s vel
    cap + cadence penalty, to test whether accel was the blocker.
    [config.py]
2026-07-25 add m4/m5/m6 stiff-ankle presets (advance the DOF ladder for the weekend)
    m3 solved by the k350 stiff ankle (m3_stiff_hi: ep_len 1720, rew +725 @ 80M).
    Advance the base-DOF curriculum with the same recipe, warm-started from the m3
    winner: m4 frees Y, m5 also frees roll, m6 fully free (+yaw). 200 Hz reactive
    stack + jitter/drop curriculum; _extras enables angmom/ent-deadline/upright-gate
    for every pitch-free stage. No cadence limits (those collapsed training).
    [config.py]
2026-07-26 intermediate result training
    [progress.79999200.csv, progress.csv]
2026-07-28 m7: cadence fix take 2 - gait-freq bug + torque-budget curriculum
    Root cause (measured on m6 via channel_authority.py): the 200Hz rescale widened
    gait_freq_hz to (0.5,50) but freq_raw->Hz is linear, so a neutral action (~0)
    maps to ~25Hz. The policy left that output near zero and inherited a 24Hz gait
    clock (CPG thigh flips sign 35x/s = dither, +-0.45 rad through a ~31Hz EMA). The
    external velocity/accel/torque HARD limits all failed because they fought this
    broken INTERNAL default.
    Fixes:
    - remap gait_freq_hz -> (0.5,4.0): neutral action now ~2Hz (verified 2.16Hz for
    the policy's measured freq_raw=-0.05, vs the buggy 24.01Hz).
    - torque-budget curriculum (the requested lever): TorqueCurri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
    [config.py, env.py, smoke_test.py, train.py]
2026-07-28 m7_res: residual-rate penalty (the freq fix left a 6 Hz residual-driven footfall)
    Re-measured m7_freq @48M: gait clock fell 24->1 Hz (freq fix works) but the
    FOOTFALL stayed ~6 Hz/foot and thigh vel 26.6 rad/s -- the policy steps through
    the fast residual channel (thigh residual ~8 Hz), NOT the CPG clock. So the freq
    fix alone is necessary but not sufficient, exactly as the channel_authority
    analysis warned.
    Add w_residual_rate: penalize sum((residual - prev_residual)^2) so a fast
    residual oscillation is expensive while a one-off correction stays cheap (the
    "re-bill the residual as a rate" fix). Presets m7_res (w=5) and m7_res_hi (w=15),
    warm-started from the freq-adapted m7_freq checkpoint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
    [config.py, env.py]
2026-07-29 evaluate.py: restore torque_scale from curriculum.json (m7 torque budget)
    So an m7 checkpoint trained under a shrunken torque budget is evaluated at that
    same budget, not full torque -- otherwise the footfall/greedy measurement is at
    the wrong plant.
    [evaluate.py]
2026-07-29 m7 cadence: pitch-reflex fix (the real footfall driver)
    2nd re-measure: neither the residual-rate penalty nor halving the torque budget
    dropped the footfall (stuck ~5.5 Hz across all m7 variants). Instrumented the
    pitch reflex on m7_freq: u_p saturated 81% of steps, sign-flips at 6.4 Hz (= the
    footfall), and the D-term (kd*pitch_rate) dominates the P-term 2.2x. The body
    barely tilts (7.6 deg) but wobbles fast (pitch_rate rms 2.87); the D-term
    rectifies that gait-bob into a 6 Hz foot oscillation -- a limit cycle no learned
    lever touches because it's the FIXED reflex doing the pattering.
    Fix (analysis's 3rd point): take the D-term's fast-bob response away.
    - pitch_reflex_rate_lp: EMA low-pass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
    [config.py, env.py]
2026-07-29 m7 cadence ROOT CAUSE: ankle-spring resonance -> damp it (m7_damp)
    Located the 6.3 Hz: it's the ANKLE JOINT (dominant 6.3 Hz, 0.56 deg), while the
    body bounces at the sane 2.1 Hz stride. The k=350 ankle spring is only ~9% of
    critical damping for the leg/body rocking mode (c_crit~18, was set to 1.6, sized
    for the foot alone), so it RINGS at 6.3 Hz on every ground contact -> the foot
    chatters. That's why NO control lever (freq/residual/torque/reflex) moved the
    footfall: it's the spring ringing, not the policy stepping.
    Fix = damp the ankle. Presets m7_damp (damping 10, ~55% crit) and m7_damp_hi
    (18, ~critical), keeping k=350. Warm from m7_freq.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
    [config.py]
2026-07-29 pushing more traning result
    [progress.csv]
2026-07-29 CPG (Ijspeert) vs Fourier generator A/B: cpg_gait.py + measured foot-IK LUT
    Adds a second gait generator so the m1..m7 Fourier stack can be measured against
    the Ijspeert-school alternative: two coupled amplitude-controlled phase oscillators
    whose parameters the RL policy tunes (Bellegarda & Ijspeert 2022, CPG-RL).
    cpg_gait.py r'' = a(a/4(mu-r) - r'), th' = 2*pi*f + coupling; policy emits
    (mu_L, mu_R, f_L, f_R, psi) + the SAME reflex/steer/residual
    channels as fourier_gait. 8 gait dims vs 21.
    build_cpg_lut.py the oscillator->joint mapping is FIXED and measured, not guessed.
    Probing the plant showed the naive reading is wr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
    [config.py, env.py, smoke_test.py, train.py]
2026-07-29 compare_ab.py: read the CPG-vs-Fourier arms at a common step count
    The arms are wall-clock bounded, so they stop at different step counts and
    "each run's final row" would not be a comparison. Defaults to the largest step
    all selected runs reached, groups seeds within an arm as mean+-range, and plots
    learning curves per lineage (cold / m2 / m3warm).
2026-07-29 CPG A/B: add a stride-envelope-matched arm (removes a confound I introduced)
    First 9 M steps showed the fourier arm at ~5 m/s with the CPG behind, but part of
    that gap was my parameter choice, not the generator: cpg_stride 0.28 m used only
    |joint| <= 0.371 while the fourier arm is free to use the full +-0.45 cam/thigh
    clip, which measurably reaches dx -0.457..+0.592 m. The reward is speed-dominated,
    so that handicaps the CPG on the metric that decides the verdict.
    ab_cpg_wide_* matches the generators on the constraint the fourier arm actually
    feels -- the JOINT envelope, not a foot-space number. Measured: with a wider IK
    table, stride 0.315 puts max |joint| at 0.449, saturating the same +-0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
2026-07-29 fix(slurm): WARM directory resolution killed the job under set -e
    A stage stopped by its wall clock has no final_model.zip, so
    `ls -1t final_model.zip ppo_*_steps.zip` exits 2 for the missing operand, and
    `set -o pipefail` propagated that through `head` so `set -e` aborted the script
    before it printed anything. ab_cpg_wide_m3warm_s0 died in 2 s this way with a
    perfectly good 60 M-step checkpoint sitting in the directory it was pointed at.
    Wrap the listing in `{ ...; || true; }`. Verified under set -euo pipefail both
    with and without final_model.zip present (final_model still wins when it exists).
2026-07-29 ab_cpg_analyze.sbatch: post-training eval + cadence report for every A/B arm
    One job over all runs (short jobs, single stdout to read in the morning). No
    set -e: a single bad checkpoint must not abort the report, and a missing arm is
    worse than a noisy line. The cadence read is the point of the no-residual arm --
    whether the oscillator's amplitude filter removes the ~6 Hz footfall limit cycle
    that no m7 lever could touch.
2026-07-30 compare_ab: per-lineage comparison step (+ py3.9 f-string fix)
    Two bugs the live run exposed:
    1. The comparison step was a global min over every run, so when the m3warm stage
    started (8 M steps) it dragged the step for ALL lineages down to 7.5 M and read
    the 85 M-step cold arms at ~0 progress. Each lineage is its own experiment and
    they do not start together, so the step is now computed per lineage. --at still
    forces a single step across all of them.
    2. The reached-steps line used a nested same-quote f-string, which is 3.12+ syntax.
    The cluster venv is Python 3.9, so it would have crashed the analysis job.
    Rebuilt with .format() and an explicit loop.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
2026-07-30 CPG vs Fourier A/B: results (plots, per-arm evals, cadence diagnostics)
    [progress.csv]
2026-07-30 result of night test between fourrier and cpg, little joystick curriculum
    [progress.csv]
2026-07-30 mX_slow_gait: retrain the whole m1..m6 curriculum with cadence fixes baked in
    Fresh from-scratch base-DOF ladder (m1 cold, m2..m6 warm-chained) that bakes
    BOTH cadence root causes into ONE identical plant from step 0, instead of
    retrofitting them onto a fast-stepping warm-start that can't unlearn the chatter:
    * gait_freq_hz=(0.5, 4.0) -- the freq-map bug fix (neutral action ~2 Hz, not
    the 25 Hz the 200 Hz (0.5,50) rescale produced)
    * ankle_stiffness=350.0 -- the preload-preserving stiff spring that solved
    m3 pitch balance
    * ankle_damping=10.0 -- ~55% critical; kills the 6.3 Hz ankle-spring ring
    * w_contact_switch=0.05 -- gentle from-scratch nudge to fewer, longe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
    [config.py]
2026-07-30 m1..m6_CPG: full milestone-ladder chain on the CPG generator, unattended
    Six-stage from-scratch CPG lineage: cold at m1 (only X free), one base DOF
    unlocked per stage to m6 (fully free), each warm-started from the previous.
    Curricula are compressed to the per-stage budget, and that is deliberate.
    train.py restarts a warm-started stage's ramps from zero, so with the _HZ200
    defaults a ~60 M-step stage traverses only a quarter of its own stance-ratio ramp
    and never leaves maximum exploration -- which is exactly what happened to the A/B
    arms (policy std ~1.0 and ent_coef pinned at 0.01 in every run that stopped under
    80 M steps, because _ab overrode ent_anneal_deadline_steps to 100 M). _cpg_sta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
2026-07-30 slow_gait chain launcher: unattended m1..m6_slow_gait afterany ladder
    Mirrors cpg_chain_launch.sh for the fourier slow_gait lineage: cold m1, warm-
    chained to m6, per-stage step budgets (m3 pitch-release gets 250M, others
    100-180M), afterany deps + WARM=<dir> hand-off, one afterany post job (plot +
    eval + cadence + mp4) per stage via the generic cpg_stage_post.sbatch. Runs in
    parallel with the CPG chain (disjoint presets/run-names/nodes).
2026-07-30 fix: training plots were silently never generated on the cluster
    plot_training.plot_run was annotated `-> str | None`. PEP 604 in an evaluated
    annotation is a TypeError on Python 3.9, and the Izar venv is 3.9 -- so the module
    raised at IMPORT time. train.py's PlotCallback catches Exception and only reported
    it when self.verbose, so EVERY cluster run silently produced no training_plots.png
    with nothing in the log explaining why. Found while validating the unattended
    m1..m6_CPG chain, which would otherwise have finished 27 h with no plots.
    * plot_training: Optional[str], with a note on why not `str | None`.
    * train.py: always report the failure (once), never gate it on verbose. A
    diag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
    [plot_training.py, train.py]
2026-07-31 CPG ladder: competence-gate the stance ramp for pitch-free stages (m3..m6)
    The first full m1..m6_CPG run got an excellent m2 (103.4 m of the 100 m dash,
    line at 34.6 s, ep_len 10987, return 6879, L/R asymmetry 0.13) and then lost
    m3..m6 outright (ep_len pinned ~300 = a 1.5 s fall, return ~-113, m4..m6 warm-
    started from the wreck).
    Cause is measured, and it is the curriculum I compressed, not the generator:
    stance_ratio ramps 0.65 -> 0.42 over 30 M steps on a CLOCK, so a flight phase was
    demanded at 19.6 M steps -- at which point m3's ep_len was 257, i.e. the reward
    asked a robot that could barely stand for 1.3 s to start running. The identical
    ramp was harmless at m2, which was already at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
    [progress.csv]
2026-07-31 chore: stop tracking training/runs outputs (checkpoints, mp4s)
    My git add -A on the previous commit swept the pulled m*_CPG run artefacts --
    final_model.zip, vecnormalize.pkl, mp4s -- into the repo, which bloats it and
    blocked the cluster pull (its own untracked outputs collide with the now-tracked
    paths). Untrack them and ignore training/runs/ going forward; artefacts are
    pulled on demand and the analysis copies live under training/runs_dl/.
    [progress.csv]
2026-07-31 CPG ladder: pitch-free rungs keep the UNCOMPRESSED curricula (m3 fix, attempt 4)
    Compressing the curricula was right for m1/m2 and wrong for m3..m6. It cost three
    failed m3 attempts, each killed by a different clock-driven ramp hitting its
    target while the policy was still falling at ~1.3 s:
    attempt 1 stance hit 0.42 (flight demanded) at 19.6 M, ep_len was 257
    attempt 2 stance gated, but the warm-start prior was itself a flight-phase
    runner -- m2_CPG had been driven to stance 0.42, and a gait that is
    airborne half the time is a poor prior for a pitch-free robot
    attempt 3 stance gated AND a grounded prior (m2_CPG @13 M, stance 0.550,
    ep_len 102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
    [config.py]
2026-07-31 CPG ladder: remove the curriculum gate from m3..m6 -- it was backfiring
    A field-by-field diff of m3_CPG against ab_cpg_m3warm_s0 (the run that reached
    ep_len 3772 and crossed the line) left curriculum_gate_ep_len as the ONLY
    substantive difference: 1500 vs 0. Everything else was tuple-vs-list formatting
    or inert (steering disabled, dr_loop_site unused, total_steps only sets the
    learn() target).
    And it has a mechanism. The gate holds BOTH the stance ramp AND the efficiency
    ramp at their easy start, so for a policy that never reaches ep_len 1500,
    eff_scale stays pinned at exactly 0 and the torque / motor-velocity / energy
    penalties are switched off for the entire run. The successful reference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
2026-07-31 mX_sym_gait: anti-one-legged duty-symmetry reward + fix chain
    slow_gait solved balance/performance but converged ONE-LEGGED (m3_slow_gait:
    left foot duty 0%, right foot patters 6.4 Hz, asymmetry index 0.99) -- the
    freq-map + ankle-damping + gentle contact-switch fixes slowed the gait CLOCK but
    did not stop the policy from using one leg as its whole support/propulsion/
    balance actuator. The 6.4 Hz footfall also persists with ankle_damping=10, so it
    is a one-legged control/reward attractor, not merely the ankle-spring ring.
    Fix (reward-only, off by default -> byte-identical to every existing preset):
    * w_duty_sym / duty_floor / duty_sym_tau_s: EMA each foot's grounded fraction,
    penalize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
    [config.py, env.py, smoke_test.py]
2026-08-03 ankle-spring study: measured masses + ankle as an experimental variable
    Sets up a clean study of the passive foot spring: is it useful at all, must it
    be actuated, and is there an optimal stiffness. None of the three was actually
    answered before. The 2026-07-24 sweep compared 90/200/350/550/750 with ONE seed,
    WARM-STARTED from a soft-spring policy, and (as m7 later found) under-damped at
    every point because ankle_damping was hand-picked per arm instead of tracking k
    -- so it varied two things at once and only showed ">=350 beats <=200". The only
    "actuated ankle" ever tested was a fixed phase-blind PD on base pitch. And k=0
    was never runnable: ankle_stiffness=0 means "keep the model's 28.65".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
    [apply_measured_masses.py, config.py, env.py, make_ankle_variants.py, smoke_test.py, train.py]
2026-08-03 active ankle: massless motor, real torque-speed envelope, spec telemetry
    Reframes the active arm from "is THIS motor worth it" to "is a motor worth
    anything, and at what performance" -- which is what we actually need to know,
    since neither the usefulness nor the required spec is established.
    The ankle motor is now MASSLESS with an AKE90-8's performance: 170 N*m peak, no
    reflected rotor inertia, and a torque-SPEED curve enforced every substep
    (available torque falls linearly to zero at the 22 rad/s no-load speed). The
    envelope has to stay realistic even when the mass does not -- a constant
    forcerange would let the ankle deliver peak torque at any speed, and then a win
    could just mean an impo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
2026-08-04 diagnose_workspace: measure a policy's foot envelope vs the measured reachable box
    Rolls out a trained policy and reports each foot's (dx fore-aft, dz lift) in the
    base frame relative to the LUT nominal_toe, plus the fraction outside a candidate
    workspace-kill box. Used to confirm the one-legged parked leg leaves the measured
    real-robot workspace and to calibrate the workspace_kill thresholds before a run.
2026-08-04 wskill chain launcher: m3..m6_wskill warm from m3_sym (workspace-kill test)
    Warm-starts m3_wskill from the two-legged m3_sym checkpoint and re-runs the
    m4->m6 ladder with the hard workspace-kill on, to test whether making the
    one-legged parked-leg crutch IMPOSSIBLE lets the lateral/roll/yaw releases
    survive (they collapsed to ep_len ~230 in sym_gait). afterany chain + per-stage
    post jobs, on the research/ankle-spring-study branch.
2026-08-04 webui: seed the weighed segment masses as defaults + fix the server path
    Two things that both bite on a fresh Pi:
    * dynstore now ships DEFAULT_MASSES -- the user's 2026-08-03 weighed segments. data/ is
    git-ignored, so a fresh install started with an empty masses dict and every downstream
    consumer (the gravity model in identification/, the Limbs & Inertia panel) silently fell
    back to the CAD placeholders in robot/model/dash01.xml: 12.83 kg against a real 15.14 kg,
    with a shin 2.6x too light. These are LINK-ONLY masses -- set_mass writes straight into
    model.body_mass and the motors are their own bodies, so the motors weighed inside an
    assembly are subtracted (same split as trainin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
    [dynstore.py]
2026-08-04 results: sym_gait m1..m5 + slow_gait m4..m6 artifacts (the evidence for wskill)
    Training plots, cadence diagnostics and rollout videos pulled off Izar for the two ladders
    that motivated the workspace-kill lineage. These are the runs whose outcome is already
    written up in config.py's mX_wskill_gait header: the duty-symmetry term TAXED one-leggedness
    but did not prevent it, and the lineage still lost at the base-DOF releases (m4/m5/m6_sym
    collapsed to ep_len ~230). The slow_gait videos are what showed the exploit itself -- a leg
    parked folded with the toe outside the measured real-robot foot workspace.
    Committing the artifacts so the wskill A/B has a versioned before-picture; the m3_slow_gait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
2026-08-04 teleop_v5: the teleop lineage on the measured-mass plant
    v1..v4 all trained on dash01.xml at 12.83 kg with a 0.222 kg shin; the real robot is 15.14 kg
    with a 0.573 kg shin. Distal leg mass is the axis the speed oracle says dominates, so every
    teleop policy so far is tuned to a robot that does not exist. v4 never got a node (25 h
    pending), so nothing was burned -- v5 is v4 re-pointed at dash01_measured.xml.
    Mass DR narrowed (0.12/0.15 -> 0.06/0.08) now that the masses are measured; dr_inertia
    deliberately left at 0.25, because body-by-body every inertia tensor in the measured model is
    just its CAD tensor scaled by the mass ratio (1.000 in all 13 bodies). The mass DISTRIBUTION
    inside each lin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
    [config.py]
2026-08-04 one plant: bake the measured masses into dash01.xml
    The mass correction was never an experimental variable. There is one robot, it weighs 15.14 kg,
    and every preset that did not opt into dash01_measured.xml was training on a 12.83 kg robot
    that does not exist -- which was all of them except teleop_v5 and the ankle study. Splitting
    the plant in two made the wrong one the default.
    * dash01.xml is patched in place: measured masses, inertia tensors scaled by the per-body mass
    ratio, keyframe re-settled (loaded stance sags 12.3 mm), ankle-lock equalities folded in
    (inactive, so they change no dynamics). dash01_measured.xml is gone;
    dash01_measured_active.xml -> dash01_active.xml, r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
    [apply_measured_masses.py, build_model.py, config.py, env.py, make_ankle_variants.py, smoke_test.py]
2026-08-04 webui: record the real drive gains off the motor driver boards
    Closes the open PID question -- dynstore shipped neutral zeros because we did not know what the
    drives were running. The user read the boards: three cascaded loops (current -> speed ->
    position) per board, grouped as left sagittal / right sagittal / abduction. "Thigh+Knee" on the
    board is a leg's SAGITTAL PAIR, since the knee is driven by the cam through the pushrod, so cam
    and thigh share a board and a tune.
    DRIVE_GAINS holds all three loops; DEFAULT_PID is derived from its position loop, which is what
    the editable field, the UI table and the file have always meant. The full cascade rides along in
    the config snapshot so a measu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
    [dynstore.py]
2026-08-04 webui: version the hand-drawn workspaces and gaits
    These were stranded on the Pi at the pre-rebuild path (~/running_robot/fixed_gait/webui/data/),
    invisible to the server, which reads robot/fixed_gait/webui/data/. Moved there on the Pi -- it
    picked them up with no restart -- and copied here.
    data/ was ignored wholesale, so they existed on exactly one SD card and nowhere else. A drawn
    workspace and a taught gait are work, not runtime state, so the ignore now admits
    workspaces/ and trajectories/ and keeps everything else out: session calibration (only valid
    until the motors are power cycled), workspace_active, model_map, dynamics_config, and the raw
    sys-ID captures. The Pi serves the AP and h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
2026-08-04 webui: playback down to 0.2 s/cycle (5 Hz), with a floor that is actually enforced
    The slider stopped at 2 s/cycle = 0.5 Hz. Now min 0.2 / step 0.1, and the label shows Hz next
    to seconds -- a gait is thought about in Hz, and the fast end is where that matters (0.2
    s/cycle reads as nothing, 5 Hz reads as fast).
    Nothing was validating the period at all. phase = play_t / period, so a 0 from the PATCH
    endpoint (which takes whatever number it is handed, no schema) is a ZeroDivisionError in the CAN
    thread -- i.e. a daemon crash with the motors mid-gait. _clamp_period now bounds start AND live
    patch to [0.2, 600] s and falls back to the 8 s default on None/NaN/garbage.
    The floor is deliberately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
    [daemon.py]
2026-08-04 webui: decouple the tracking-error trip; plot the commanded target
    Two things, both from pushing playback cadence.
    1. Tracking error is no longer welded to the E-STOP.
    The check conflates a JAM (leg against a hard stop, drive winding up) with LAG (commanded
    cadence faster than the drive can follow). Lag grows as period^-1, so at high cadence the
    trip fires on the benign case and the run is unusable -- which is exactly what happens now
    that playback goes to 5 Hz.
    track_err_estop (default True, so nothing changes unless you ask) turns that one check into
    a warning. ONLY that one: workspace violation, runaway ERPM, over-temperature, motor error
    codes and the E-STOP butto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
    [daemon.py, ringbuffer.py, server.py]
2026-08-04 playback: hard 2.5 Hz ceiling, justified off the gait's own kinematics
    A part failed during a high-cadence run, so PERIOD_MIN goes 0.2 -> 0.4 s (5 Hz -> 2.5 Hz). This
    is a hardware limit now, not a slider preference; raising it needs a hardware argument.
    The number is not a guess. tools/analyze_gait_demand.py differentiates the stored waveform of
    gait_drawn_tuesday.npz (exact, no sinusoid assumption; speed scales linearly with cadence, so
    peak deg/s per Hz is a property of the SHAPE):
    cam 68.8 deg travel 359 deg/s per Hz -> no-load (1261 deg/s) at 3.51 Hz <-- binding
    thigh 42.4 deg travel 222 deg/s per Hz -> no-load at 5.67 Hz
    The cam is the binding join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
    [analyze_gait_demand.py, daemon.py]
2026-08-04 webui: a button that parks the legs where the excitation fits
    A system-ID chirp is centred on the leg's CURRENT pose and its whole
    envelope is validated before the run is armed, so from a pose near a hard
    limit -- or outside the drawn workspace -- every amplitude is refused at
    t=0 and the run simply never starts. The fix for that is not a better
    error message, it is somewhere to stand.
    daemon: workspace_center() returns, per leg, the centre of the LARGEST
    inscribed square of safe (cam, thigh) cells plus the midpoint of the safe
    abduction range. A square rather than a disc because the thing that has to
    fit is a box: cam and thigh are excited independently, so the swept set is
    [c +- A_cam] x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
    [daemon.py, server.py]
2026-08-04 plant: map the toe's static force capability over the workspace
    Running needs several body weights of vertical GRF and a modest fore-aft one,
    at the toe positions stance actually visits. The cam motor reaches the knee
    through a pushrod 4-bar, so the motor->toe transmission is a strong function of
    pose and there was no measurement of whether the strong direction is the one
    running needs.
    training/model/plot_force_map.py computes it. Loop closure is Newton-solved per
    (cam, thigh) on the physical assembly branch, then the constrained toe Jacobian
    J = Jt_a + Jt_p(-Jc_p^-1 Jc_a) differentiates the loop out, so J carries the
    linkage's transmission ratio. Statics tau = -J^T F against the 170 N*m m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
    [plot_force_map.py]
2026-08-05 identification: the two sign errors that made every Kt come out negative
    Both are frame errors in the norm->model conversion, and both are invisible
    until you look at the sign of the identified Kt.
    1. `cur` never got the sign convention. `pos_norm` arrives in the CALIBRATED
    frame (the webui applied calibration.sign when normalizing) and `sign` then
    carries it to the model frame, but the current column was copied raw, so
    torque and angle were in different frames. Current needs BOTH signs.
    2. The webui's FK map is fitted per leg in that leg's OWN frame, so it reports
    the same cam/thigh signs for both sides -- but the model mirrors the right
    leg's sagittal axes. Without the mir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
2026-08-05 identification: fit each joint on the runs that moved it, and give the bias a column
    Two ways the regression was being fed data it could not use, both of which
    could flip the sign of Kt on their own.
    A run with hold_other excites ONE leg; the other leg's three joints just sit
    there. Those blocks were pooled into the fit anyway -- thousands of rows with no
    gravity and no acceleration in them, carrying only the drive's DC current
    offset. Fit each joint on the runs that actually moved it, and skip a joint
    outright (reporting why) when it has too few excited samples or when tau_grav
    barely swings, rather than emitting a confident-looking wrong number.
    Separately, every fit now carries an inter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
2026-08-05 identification: stop over-damping the loop Jacobian
    damp=1e-3 was sized for the 4-bar singularity, but a measurement sweep does not
    go near it: cond(Jd'Jd) is ~157 across the 2026-08-05 runs. At that conditioning
    the damping is pure bias -- it shrinks G, which under-projects the load the
    pushrod transmits, which inflates the identified gravity torque by ~20% (the cam
    gravity gain moves 2.16 -> 1.80, the thigh 1.65 -> 1.37).
    Results converge for damp <= 1e-5. 1e-6 keeps a margin against genuinely
    singular poses while leaving well-conditioned ones alone.
2026-08-05 webui: size the excitation to 80% of travel AND of no-load speed
    The static presets (9 deg at 0.6 Hz) put only 0.7-4.8% of the drive current
    into the qddot column -- the rest was Coulomb friction -- so the identified
    inertia was meaningless. That is an excitation problem, not an estimator one.
    New POST /api/measure/defaults asks the daemon what the CURRENT pose actually
    affords: per role, amplitude = 80% of the contiguous safe travel (the smaller of
    the two directions, since the chirp is a sine centred on the pose), and the end
    frequency = the one whose peak sine velocity 2*pi*f*A reaches 80% of that
    motor's no-load speed at that amplitude. The two are not independent, so asking
    for more ra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
    [daemon.py, server.py]
2026-08-05 webui: size excitation against the position loop's bandwidth, not just travel
    The 80% preset sized amplitude by kinematic room and frequency by no-load
    speed, and both were satisfied when right.abd latched the e-stop at 30 deg of
    tracking error, 6 s into a run. Neither constraint was the binding one.
    Swept-sine on all six joints (measure_*_dyn_2.npz) puts the drive's POSITION
    loop at a first-order roll-off at 0.8 Hz plus ~25 ms of transport delay:
    f Hz 0.8 1.1 1.4 2.0 2.5 2.9
    gain 0.71 0.60 0.53 0.38 0.30 0.28
    lag -48 -61 -71 -86 -94 -104
    so above ~1 Hz most of the commanded chirp is simply not executed -- and the
    un-executed part IS the tracking e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
    [daemon.py]
2026-08-05 plant: peak joint torque is what the gearbox delivers, not what the datasheet quotes
    forcerange carried the datasheet peak (170 Nm AKE90-8, 72 Nm AK60-39), which is
    torque at an ideal Kt. The gearbox does not deliver it.
    Measured 2026-08-05 with a known 1.552 kg mass clamped to the shin. Fitting the
    no-mass and with-mass runs together with an indicator column makes the mass
    term's coefficient 1/Kt -- known mass times a kinematic lever arm, with no link
    CoM anywhere in it -- so Kt separates from the gravity model that had been
    confounded with it all along. Effective joint Kt came out 82-89% of the
    AKE90-8's 0.272 Nm/A x 8:1 = 2.176, i.e. a gearbox at ~85% efficiency. Peak
    torque scales with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
2026-08-05 webui: read the Sense HAT (B) sensors and show them on the robot's page
    The Waveshare Sense HAT (B) has been sitting on the Pi's header unread. All five
    chips answer on I2C bus 1 (verified by WHO_AM_I on the robot): ICM-20948 9-DOF
    IMU, SHTC3 air T/RH, LPS22HB pressure, TCS34725 light/colour, ADS1015 4-ch ADC.
    sensehat.py drives them register-level over smbus2 from ONE background thread.
    It is not on the CAN daemon's thread and not in a Flask handler on purpose: an
    I2C stall must never be able to delay a motor command. Handlers only read the
    published snapshot / ring, the same read-by-sequence contract motor telemetry
    already uses (ringbuffer gains a scalar-per-field ring for it).
    Attitude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
    [ringbuffer.py, sensehat.py, server.py]
2026-08-05 ankle2: the real spring with no preload, and no spring at all
    The m1..m7 record was all obtained on a k=350 ankle spring that will not be
    built, so the open question is no longer "which k" but a build decision with
    two candidates:
    Q1 the real spring, k=41.4 N*m/rad with NO preload
    Q2 no spring: a rigid tension-only strut (buckles past 10 N in compression),
    which also deletes the 249 g spring assembly from each shin
    New plant axes, all defaulting to the current behaviour so every m1..m7 /
    slow / sym / wskill / ankle-study preset is bit-for-bit unchanged:
    ankle_preload="zero" springref AT the flat-foot angle instead of the
    preload-preserving sh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
    [config.py, env.py, smoke_test.py]
2026-08-05 ankle2: launcher — 9 arms x 2 seeds, short chained links for a 0.0017 fairshare
    Controls first in the submit order: if k350 does not train on the corrected
    plant then nothing else in the screen is readable.
2026-08-06 ankle2: fix the gate that killed the run, and model the MEASURED drive
    The whole 90-job screen FAILED in ~30 s. Not storage (37% used, 507 T free)
    and not my changes: the sbatch smoke gate aborts on `rigid ankle stays welded`,
    and that check fails identically at e9c9a07~1. Root cause is a solver-version
    split -- local dev is MuJoCo 3.7.0, the cluster venv is 3.3.7, and at the
    shipped solref=0.005 the lock_ankle weld GIVES WAY on 3.3.7: the ankle drifts
    0.858 rad over a 60-step rollout, so the "rigid" control arm is silently a
    compliant one there. solref 0.002 / solimp 0.999 brings it to 0.005 rad.
    Anything solver-marginal has to be tuned against the OLDER version.
    Also implements the measur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
    [config.py, env.py, make_ankle_variants.py]
2026-08-06 ankle2drv50: rescale the 50 Hz arm to equal ROBOT TIME, not equal step count
    _HZ200 multiplied every step-denominated schedule by 4 and set gamma to
    0.99^(1/4) when the control rate went 50 -> 200 Hz. Reusing those numbers at
    50 Hz made every curriculum advance 4x slower in seconds-of-robot and cut the
    discount horizon to 0.5 s -- so the 50 Hz arm would have lost for reasons that
    have nothing to do with the control rate, which is the only thing the
    200/50 pair exists to measure.
    _at_50hz brings back down: gamma (0.99 = same ~2 s horizon, verified both
    discount to 0.367 over 2 s), ent_gate_air_time, every *_steps schedule, and --
    easy to miss -- the ep_len competence GATES. 1600 steps is 8 s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
2026-08-06 sensehat: the barometer's first reading is only ready when BOTH data bits are
    Confirmed on the robot: pressure now tracks at 973 hPa (correct for here) instead
    of the frozen 819.2, but the first one-shot after power-up still came back as
    759.33 hPa with a barometer temperature of exactly 0.0 degC.
    The status poll settled for P_DA *or* T_DA. Pressure converts first, so that test
    passes while the temperature registers have not been written yet — the block read
    then picks up whatever was in them, which after power-up is zero. Wait for both.
    Verified: the very first line of the self-test now reads 973.07 hPa / 36.2 degC.
    [sensehat.py]
2026-08-06 webui: measure where the IMU is bolted instead of asserting it
    The Sense HAT is mounted UNDER the robot, so its chip axes are nowhere near the
    body's and every attitude number was being read in the wrong frame. mountcal.py
    measures the mount from two still-robot captures, hung on the test rig:
    1. upright -> the direction of gravity in chip axes, which fixes the tilt
    2. nose-down tilt -> the fore-aft axis and its sign
    Step 2 is not bookkeeping. Gravity fixes only TWO of the three rotation DOF —
    rotation about the vertical is invisible to an accelerometer at rest, and that is
    exactly the DOF separating pitch from roll, the axis every balance question on
    this robot is about. A declared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
    [mountcal.py, sensehat.py, server.py]
2026-08-06 ankle2: cross-arm learning-curve plot + one-off post job
    plot_ankle2.py puts duty_sym on as a first-class panel rather than leaving it
    in the reward terms, because it is the tell for the one failure mode that makes
    a good-looking curve meaningless here: surviving by going ONE-LEGGED. Measured
    2026-08-06, the rigid arm's duty_sym penalty grows in lockstep with its episode
    length. Read together: ep_len up with duty_sym flat is progress, both rising is
    the exploit.
    Also drops runs whose progress.csv has gone stale, so a cancelled arm cannot
    drag the common-step comparison down -- the cancelled 50 Hz dirs pulled it from
    ~45 M to 10.7 M.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
2026-08-06 ankle2: add bar_comp — a strut that takes compression too
    rigid (welded both ways) completes the 57 m dash at 2.55 m/s in 5 of 6 greedy
    episodes; bar (tension-only) manages 0.6 m and stands one-legged. The only
    difference between them is that the strut yields in compression past 0.4 N*m,
    so the tension-only-ness may be the entire cost rather than the compliance.
    bar_comp (5 N*m = a proper link, not a thin rod) brackets bar -> rigid. If it
    recovers rigid's performance the build answer changes from 'tension-only strut'
    to 'just make it a stiff link'.
    [config.py]
2026-08-06 sensehat: run the IMU at 200 Hz, and stop the poll thread stealing control ticks
    Measured on the robot rather than assumed. At the 100 kHz I2C default an
    accel+gyro+temp burst costs 1.68 ms (594 reads/s) and the magnetometer another
    ~1 ms, so 200 Hz has headroom — but naively raising the rate cost the 200 Hz CAN
    control loop 13% of its ticks. Three findings, in order of how much they mattered:
    * The per-tick MATH cost 2.14 ms. Every operation in the AHRS path is on 3- and
    4-vectors, where numpy's per-call overhead dwarfs the arithmetic — and unlike
    the I2C ioctl it holds the GIL throughout. Rewritten in scalars: 0.064 ms, 33x
    cheaper. Verified numerically identical against the sim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
2026-08-06 sensehat: give the slow chips their own thread so the IMU really runs at 200 Hz
    The IMU loop was reaching 190-194 Hz of a nominal 200, and the missing ticks were
    not the IMU's. Air, pressure, light and the ADC were being read inline, and those
    drivers spend nearly all their time asleep waiting for a conversion — the SHTC3
    alone sleeps 15 ms, three whole ticks. Adding it up: ~43 ms of stall per second,
    about 8 missed ticks, which is exactly the shortfall that was measured.
    Moving them to a second thread costs one lock. _SharedBus serialises transfers
    between the two, and only transfers — the conversion sleeps happen between calls
    in the chip drivers, so they now overlap the IMU's reads i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
    [sensehat.py]
2026-08-06 docs: write down what the IMU actually is, with provenance on every number
    robot/IMU.md — ranges, resolution, noise, bias, bandwidth, latency budget,
    frames, the attitude filter, and a ready-to-paste sim2real sensor model. Written
    for the training stack: this is the sensor the policy gets on hardware.
    Every figure is labelled with where it came from — measured at rest, measured but
    motion-independent, datasheet-and-unverified, or not characterised at all. That
    is not pedantry. A noise measurement taken while the robot sways on its rig
    measures the sway, and nothing in the resulting number says so: it produced a
    yaw-axis "noise" 8x too high, and a low-pass sweep in which a NARROWER filte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
    [imu_bench.py]
2026-08-06 walk_fwd: adapt the teleop_v5 walker to the measured robot
    The untethered-walking target. An ADAPTATION run, not a from-scratch one:
    teleop_v5 reached 321 M steps as an m6 walker with the full sim2real package,
    and nothing here changes obs (550) or action (26) width, so that checkpoint
    loads directly.
    Four new sim2real axes, every one of them a number measured on the robot rather
    than a guess:
    * dr_joint_zero_deg (5 deg) -- homing error, applied to BOTH the observation and
    the COMMAND. noise_encoder_offset already existed but was 0.57 deg AND
    obs-only; a wrong zero physically means you read theta-delta while the drive
    parks the true joint at theta+delta, so obs-only models a robot th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
    [config.py, env.py]
2026-08-06 walk_fwd: SensorNoise must define the homing/IMU-mount fields when disabled
    walk_fwd_easy sets obs_noise_enable=False, so reset() took its early-return
    branch and never defined zero_offset -- which the ENV reads for the COMMAND side
    of the homing error, independently of the measurement chain. Crashed the clean
    diagnostic arm on its first step. Defined as NEUTRAL there, so 'easy' really is.
2026-08-06 runs_dl: archive every cluster run not already held locally
    94 run directories fetched: the ankle2 screen (both drives + the cancelled 50 Hz
    arms), the CPG/Fourier A/B, the wskill and sym_gait ladders, the teleop lineage
    and the ankle study. Follows the existing convention -- training/runs/ is
    gitignored, training/runs_dl/ is the tracked archive -- so this is progress.csv
    + resolved_config.json + curriculum.json + plots, not checkpoints.
    Also the ankle2 result artifacts generated locally: the cross-arm comparison,
    the three contact rasters, and the rigid/bar policy videos.
    205 MB, largest file 7.4 MB. Checkpoints and TensorBoard event files are
    deliberately excluded: 4.8 GB of them, and pr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
    [progress.csv]
2026-08-06 runs_dl: archive the teleop lineage from the separate rr_teleop cluster repo
    teleop_v2/v3/v5 curves were held ONLY on the cluster -- runs_dl had v1 and easy
    but nothing after, and its teleop copy was 240 KB shorter than the cluster's.
    teleop_v5 in particular is the direct ancestor of the running walk_fwd lineage,
    so its curve is provenance for whatever walk_fwd produces.
    [progress.csv]
2026-08-06 train: re-seed after a warm start — seed replicates were silent duplicates
    PPO.load restores the SOURCE checkpoint's seed, and 'seed=cfg.seed' only ever
    appeared in the fresh-start branch, so --seed never reached a warm-started run.
    Measured: walk_fwd_s0 and walk_fwd_s1, launched with SEED=0 and SEED=1, produced
    BIT-IDENTICAL reward curves for all 100 common rollouts -- both were running
    teleop_v5's seed. A two-seed arm was one run costing twice the fairshare, which
    on a 3-day hands-off schedule would have been discovered far too late.
    Affects every warm-started multi-seed comparison in the record, including the
    ankle-study design and any A/B whose arms warm-start from a shared parent.
    C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
2026-08-06 walk_fwd: actually IMPLEMENT the drive-bandwidth curriculum
    675d827's config comment and commit message both claimed the drive bandwidth
    "rides the DR curriculum rather than switching on at step 0". It did not.
    drive_bandwidth_hz was resolved once at env construction into a fixed
    action_filter and never ramped -- the claim was false in the comment, the commit
    message and the memory file.
    The diagnostic arm shows exactly the failure that mitigation was for.
    walk_fwd_easy has DR, sensor noise, pushes, trips and jitter all OFF, so the
    only differences from its warm-start source are the ankle and the drive:
    teleop_v5 ep_len 1448 reward +511
    walk_fwd_easy ep_len 251 rewar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
    [config.py, env.py, train.py]
2026-08-08 training: the sim2real axes must ride the DR ramp, not stand at full width
    walk_fwd_s0/s1 sat at ep_len ~500 with dr_scale EXACTLY 0.00 and drive_bw
    pinned at its 12 Hz start for 530 M steps, both seeds. curriculum_gate_ep_len
    =1600 gates all six ramps at once (stance, drive_bw, eff, dr, jitter, drop);
    the policy never reached 1600, so no curriculum ever moved -- while the
    measured calibration axes (5 deg homing zero, 10 deg IMU mount rotation) were
    NOT gated and ran at full width from step 0. Full sensor adversity, zero
    dynamics randomisation, zero efficiency regularisation, and a 12 Hz drive that
    does not exist on the robot, with the only exit gated on the thing it could
    not do.
    The _tele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
    [config.py, env.py, smoke_test.py]
2026-08-08 evaluate: restore the drive bandwidth from curriculum.json (4th instance)
    drive_bandwidth_start_hz is resolved by DashEnv.__init__ into a fixed
    action_filter, so any run with a drive curriculum was REBUILT AT ITS START
    VALUE at eval time no matter how far the curriculum actually got.
    walk_fwd_easy_s0 trained all the way down to the real 0.8 Hz and logs
    ep_len 4938; evaluated without this line it reads 126 -- a 32x understatement,
    and exactly the kind of number that gets a good policy thrown away.
    Same family as sprint_dist_m, cmd_scale and torque_scale, which the
    surrounding comments already document. curriculum.json is the ground truth
    for anything a curriculum moved; resolved_config.json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
    [evaluate.py]
2026-08-09 training: ask the plant for speeds it can reach, and ramp the last two adversities
    walk_fwd2 plateaued at 2.0 s for 300 M steps. Not another deadlock -- every
    curriculum was moving. Two paired-seed ablations on walk_fwd_easy_s0 (12
    episodes, common random numbers) found two independent causes.
    Method note first, because it changed the answer: episode outcomes here are
    bimodal (fall at ~2 s, or survive the full 60 s), so an unpaired 5-episode
    sample is noise. The SAME clean condition measured 35.6 s and 1.8 s on two
    consecutive runs, and a first pass off that sample "found" a 27x sensor-noise
    effect that does not exist. Everything below is paired.
    (1) COMMANDS THE PLANT CANNOT DELIVER. Surv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
    [config.py, env.py, smoke_test.py]
2026-08-09 training: give walk_fwd the base-DOF ladder it never had
    Checked every resolved_config in the archive: teleop, teleop_easy, teleop_v2,
    v3, v5, walk_fwd, walk_fwd_easy, walk_fwd2 are ALL base_lock (0,0,0,0,0,0).
    The entire teleop -> walk_fwd lineage trains at m6, all six base DOFs free,
    from step 0. It is the one lineage in this project that skipped the ladder,
    and the one that will not converge: three plateaus, ~1.4 G steps, and dr_scale
    self-limiting at 0.27 because the retreating ramp cannot find competence to
    ramp on.
    Everything that ever worked on this robot used the ladder. 97 archived runs
    sit at m3, and the only controller to reach 2.55 m/s on the MEASURED plant
    (ankle2_m3_rigid) was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
    [config.py]
2026-08-09 ladder: start at m2 — learn the speed mapping on a robot that cannot fall
    m2 = (0,1,0,1,1,1): x and z free, y/roll/PITCH/yaw locked. Nothing to balance,
    so the only thing left to learn is how the gait converts into forward velocity
    -- which is exactly the measured deficit. The m6 policy tops out at 0.14 m/s
    against a 0.6 m/s command and survives 0/12 paired episodes at +0.40 m/s: it
    is not that it cannot move, it is that moving destabilises it. m2 separates
    those two problems and learns the first one for free.
    Kept SHORT on purpose (STEPS_m2=40M, LINKS_m2=2, vs 80M/3 elsewhere): with
    pitch locked a policy can lunge with no consequence, and m2 -> m3 is the hard
    transition in this project's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
    [config.py]
2026-08-09 ladder: standing still out-scored walking — stop paying for it
    ladder_m2_s0 hit ep_len 10796 (54.0 s) and reward +9752 at 10 M steps without
    locomoting: both feet grounded 86-99% of the time, 7.6 footfalls/s of chatter,
    0.2-1.2 m covered in a MINUTE (~0.01 m/s). Driving the same checkpoint at 12 Hz
    with a ZERO command makes it move 0.207 m/s and fall, so it had learned to emit
    large actions and use the 0.8 Hz drive filter as a brake.
    It was behaving optimally. At cmd +0.30 m/s, with w_track_lin 4.0,
    track_sigma_min 0.2, w_alive 0.5, fall_penalty 100:
    stand still, survive 60 s 0.922/step -> ~2766 per episode
    track perfectly, fall at 5 s 4.500/step -> 1125 - 100 = 1025
    S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
2026-08-09 slurm: book the node we actually need — 40 cores, not 20 with the GPU idle
    Measured on the three running jobs: GPU utilisation 3%, 480 MiB used, load
    average 8.3-9.7 against 20 reserved cores. Izar nodes are 40 cores / 192 GB /
    2x V100, so we were reserving half a node, using a quarter of it, and leaving
    the GPU essentially untouched.
    There is no CPU-only alternative: every izar partition (gpu, gpu-xl, test)
    carries GPUs, and the account has no association with jed/kuma/helvetios. So
    the fix is to use the node we already hold, not to move.
    --cpus-per-task 20 -> 40, --mem 64G -> 128G, NENVS 18 -> 36
    NENVS alone would have been a silent algorithm change: PPO's rollout is
    n_steps*n_envs,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
    [train.py]
2026-08-10 plant: real torque-speed envelope for the gait motors (off until R is measured)
    Back-EMF was modelled ONLY for the optional ankle motor. The six gait
    actuators had a flat forcerange delivering peak torque at any speed, which no
    motor does.
    The obvious fix -- copy the ankle's linear-from-zero derate -- is the WRONG
    SHAPE. A brushless drive is current-limited at low speed and only
    voltage-limited past the corner:
    tau(w) = min( tau_peak, Kt_j * (V_bus - Kt_j*w_joint) / R )
    Back-EMF referred to the joint is exactly Kt_j*w_joint (Kt_motor = Kt_j/G,
    w_motor = w*G). The linear model ignores the flat branch and under-reports
    torque precisely where this robot operates.
    With the bus at 48 V a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
    [config.py, env.py]
2026-08-10 ladder: enforce the MEASURED reachable workspace (workspace_kill was off)
    walk_fwd inherited workspace_kill=False from _teleop, so nothing has been
    enforcing reachability since this lineage started: the policy was free to use
    toe positions the physical 4-bar cannot produce, and its characteristic failure
    -- sinking -- is exactly the shape an out-of-workspace exploit would take. The
    2.55 m/s runner (ankle2_m3_rigid) had it ON.
    Verified: _ws_ref is re-referenced to each arm's settled stance (ankle_resettle
    was already set) and does not fire at reset. Ladder presets only; walk_fwd3
    stays as the unmodified control.
    [config.py]
2026-08-10 m2 drive-bandwidth bracket: is 0.8 Hz what stops it walking?
    A first-order lag at 0.8 Hz keeps, of commanded amplitude: 85% at a 0.5 Hz
    gait, 71% at 0.8, 47% at 1.5, and 21% at 3.8 Hz. The finished m2 policy runs a
    3.8 Hz gait (7.6 footfalls/s), so only a fifth of the commanded swing survives
    the drive, 78 deg late -- a very plausible reason the feet never leave the
    ground.
    This cannot be settled by replaying a 0.8 Hz-trained policy at higher bandwidth
    (tried earlier: it moves faster and falls). The policy has to be TRAINED at the
    bandwidth being tested. Three cold m2 arms differing only in
    drive_bandwidth_hz -- 0.8 / 3.0 / 12.0 -- keeping the measured 25 ms transport
    delay, all with worksp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
2026-08-10 webui: spec a black box, because this one cost us a joint
    2026-08-10 left.cam drove ~1.9 output turns on a joint with +/-86 deg of travel
    and destroyed the linkage. The postmortem was impossible: the only telemetry
    that has ever existed is a 4096-sample RAM ring (20 Hz, ~3.4 min) whose HTTP
    reader clamps to the last 512 samples, and nothing is written to disk. By the
    time anyone looked the window had rolled past the event, so the two candidate
    mechanisms -- a stale calibration used by an absolute move, versus a driver
    board's multi-turn origin shifting under us -- remain undistinguishable.
    The brief is written against the modules as they are (daemon tick, ringbuffer,
    calibration, dynstore,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
2026-08-10 webui(blackbox): homing first is CORRECT — make it safe, don't ban it
    The brief said center()/home() must not be the first absolute command after a
    re-zero or reboot. That is wrong on the actual workflow: after a zero capture
    the legs are limp and sagging under gravity, and homing is precisely what
    catches them. Banning it would leave the robot hanging on its stops while the
    operator performed a ceremony.
    Replaced with four mechanisms that cost the operator nothing:
    a. hold before moving -- the first CAN command after enable is
    set_pos(current_raw), which never consults the calibration offsets and is
    therefore safe even if the zero is completely wrong. It stops the sag
    i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
2026-08-10 webui: a black box, so the next failure is reconstructible
    2026-08-10 cost a joint and the investigation was impossible. All the telemetry
    that existed was a 4096-sample RAM ring at 20 Hz, of which the HTTP API can only
    ever hand out the last 512 (25.6 s), and nothing on disk. By the time anyone
    looked the window had rolled past the event.
    blackbox.py — three tiers, because 200 Hz x 6 motors streamed continuously is
    35 kB/s / 3 GB/day and that kills the SD card:
    A 20 Hz, every field, fixed-width binary segments, rotated and budgeted
    B the actual black box: a 40 s 200 Hz RAM ring dumped on a trigger, with the
    PRE-trigger history, plus a 3 s post-trigger tail
    C events.jsonl,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
    [blackbox.py, blackbox_read.py, calibration.py, canio.py, daemon.py, dynstore.py, measurestore.py, paths.py]
2026-08-10 webui(blackbox): a routine mode toggle must not evict the day's history
    Two things that only bite on the real Pi, not on the bench:
    * every dump is 40 s x 200 Hz x 212 B = 1.7 MB, and Tier A history is what the
    budget deletes first. With one 10 s cooldown for all reasons, an operator
    toggling LIMP/MANUAL could quietly trade the continuous recording for a pile
    of near-identical mode dumps. trigger_dump now takes a per-trigger cooldown
    and routine transitions use 120 s. Trips, refusals and origin jumps are
    distinct reasons and stay immediate.
    * _publish_status ran os.scandir over the whole directory every writer cycle
    (10 Hz) to fill a byte count only the UI reads. On an SD card t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
2026-08-10 webui(blackbox): comment sat with the wrong mechanism
    [daemon.py]
2026-08-10 webui: a bus that will not take frames must not kill the daemon
    Found by the black box on its own first run on the robot, which is the point of
    it. The Pi booted, systemd started the daemon before the motor power was on,
    nothing on the bus ACKed, socketcan's 10-frame TX queue filled in one tick and
    send() raised ENOBUFS inside _setup()'s preflight. Unhandled, in a background
    thread: the daemon thread died, the control loop never started, and the only
    evidence was a "daemon_crash" dump and a daemon.crash event with the traceback
    in it. Before today that failure was silent unless someone had a terminal open —
    which is exactly the 2026-08-10 story.
    The bug is pre-existing, but running under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
    [blackbox.py, canio.py, daemon.py, test_blackbox.py]
2026-08-10 webui(blackbox_read): a session that is still running is not a power cut
    Reading the log of a LIVE robot is the normal case, and the reader announced
    "POWER LOSS / KILL INFERRED" for the session that was running while it read.
    The absence of a stop record means "not finished yet" when the newest session's
    last record is seconds old; it only means a power cut once the session is over.
    Announcing a power loss that did not happen is precisely the kind of confident
    wrong answer this thing exists to avoid.
    [blackbox_read.py]
2026-08-10 webui: back off a CAN channel that fails every send (60 Hz -> 200 Hz)
    MEASURED on the robot, by the black box, half an hour after installing it. The
    left leg is disconnected, so every tick streamed three SET_CURRENT frames into a
    bus with nothing to ACK them. That is not free: three failing socketcan sends
    cost ~11 ms against a 5 ms tick budget, and the 200 Hz control loop was running
    at 59.8 Hz with 34% late ticks — 143 stalls in one 185 s window, the longest
    103 s. Exactly 3.00 send failures per tick, which is the whole left leg, every
    tick. A failing send is roughly a thousand times more expensive than one that
    goes out.
    The previous commit turned "the daemon dies" into "the daemon cra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
    [canio.py, daemon.py, test_blackbox.py]
2026-08-10 training: the entropy anneal could never open, and could never finish
    MEASURED on m2drv_d3_s0 -- an arm that walks 20.75 m at 0.69 m/s with the right
    foot airborne 0.32 s at a time -- ent_coef sat at exactly 0.01 for all 60 M
    steps and log_std stayed pinned at 1.000. Three numbers, all sized against the
    preset's nominal total_steps=800 M while the ladder trains 60 M stages:
    ent_gate_air_time 0.005 vs the 0.0002 a WALKING policy produces (25x short)
    ent_anneal_deadline 100 M > the 60 M budget: the fallback never fires
    ent_anneal_steps 80 M > the 60 M budget: it could not finish if it did
    This is not cosmetic. The bracket's d12 arm reported ep_len 38 s from its
    stochastic roll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
    [config.py, env.py, smoke_test.py, train.py]
2026-08-10 webui: retract the "failing sends cost 11 ms" claim — I measured wrong
    The previous commit ("back off a CAN channel that fails every send (60 Hz ->
    200 Hz)") asserted that three failing socketcan sends per tick were eating
    ~11 ms of a 5 ms budget and dragging the loop to 60 Hz. That is not true, and
    the A/B on the robot settles it:
    backoff OFF (3.00 failing sends/tick) 188.9 Hz 5.29 ms/tick
    backoff ON (0.03 failing sends/tick) 188.5 Hz 5.30 ms/tick
    A failing send costs nothing measurable. The 60 Hz reading was the measurement
    disturbing the measured: scp, py_compile, journalctl, top and HTTP polling were
    all running on the Pi 3B while I sampled it. Steady state, everything o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
    [canio.py, daemon.py, test_blackbox.py]
2026-08-10 plant: the ladder trains on the robot as REBUILT, and speed was never capped
    Four changes, three of them hardware catching up with the model and one a gap
    that had been open the whole time.
    1. SPEED LIMIT -- it was never in. Peak torque has always been capped (61.2 Nm
    hip-roll, 144.5 Nm cam/thigh, delivered not datasheet), but motor_vel_limit
    defaulted to 0 = OFF for this entire lineage, so a position servo could crank
    a joint arbitrarily fast for free. The config's own comment records what that
    bought: the k350 m3 winner "balanced" by pattering ONE foot at ~11 Hz with
    peak thigh 23 rad/s, past the motor ceiling. Now capped at the measured
    no-load OUTPUT speed, PER JOINT,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
2026-08-10 model: keep the mirror tool, do NOT apply it — the premise was wrong
    The standing stance is crooked (hip_roll sum -8.13 deg) and the CAD export is
    not quite mirror-symmetric (right hip body frame carries a 1.211 deg rotation
    the left does not, right foot 0.133 deg, left foot 1.6 mm off the mirror line --
    17 of 30 compared quantities). The obvious inference was that the second causes
    the first, since compute_standing_keyframe SETTLES a symmetric initial pose.
    It does not. Mirroring the tree and re-deriving the keyframe gives:
    env re-settled keyframe, hip_roll before L -7.322 R -0.812 sum -8.134
    after L +0.268 R +7.427 sum +7.695
    Same m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
    [symmetrize_model.py]
2026-08-10 training: asymmetric critic + velocity-estimator head + duty-sym (joystick review fixes)
    The SOTA review against the velocity-command literature (Rudin et al. 2022,
    RMA, DreamWaQ) found three gaps; all three land here, together, because two of
    them change the observation contract and that is only free ONCE -- before the
    cold 2026-08-10 ladder.
    1. ASYMMETRIC CRITIC. obs_base_vel=False is right for the actor (the hardware
    has no velocimeter) but SB3 shares one observation, so it also blinded the
    VALUE FUNCTION of a velocity-tracking task to velocity -- R^2 0.807
    recoverable, i.e. ~20% of the return's driving state was noise in every
    advantage estimate. The env now appends a DashEn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
    [config.py, env.py, smoke_test.py, train.py]
2026-08-11 runs_dl: archive ladder3 m2-m4 (rebuilt plant) + make cluster checkpoints loadable locally
    The ladder3 chain on jed — the first ladder trained on the robot as REBUILT
    (3 Hz drive, rigid carbon ankle, per-joint velocity caps) — through its first
    three rungs: m2 complete at 100M (both seeds), m3 complete at 80M (both), m4
    snapshotted mid-run at ~60M. Per run: progress.csv, curriculum.json,
    resolved_config.json, training_plots.png, and a locally rendered greedy-eval
    video (no post-render jobs exist on jed, so the mp4s were rendered here from
    the pulled checkpoints; policies + VecNormalize live in gitignored runs/).
    Greedy, 3 episodes, dr=0 — indicative only (unpaired, and m2 is visibly
    b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
    [progress.csv]
2026-08-11 runs_dl: the ladder3 chain finished — m5 (roll) is a wall on the rebuilt plant
    All 12 jobs COMPLETED on jed, ~23 h wall clock, six rungs x two seeds, every
    stage spending its full budget (m2 100M, m3-m6 80M each). This is the first
    full ladder on the robot as REBUILT (3 Hz drive, rigid carbon ankle, per-joint
    velocity caps). Artifacts for all ten runs: progress.csv, curriculum.json,
    video (jed has no post-render jobs; policies live in gitignored runs/).
    Greedy eval, 5 episodes, dr=0 -- indicative, unpaired:
    m2_s0 ep_len 4622 ret 5910 vx 0.05 (3 eps; stands and survives)
    m2_s1 ep_len 5589 ret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
    [progress.csv]
2026-08-19 webui: MEASURE_F_MAX 3 -> 15 Hz, and make it the actual clamp
    _merge_measure_spec clamped f0/f1 to a hard-coded 3.0 while MEASURE_F_MAX sat
    next to it as a comment claiming to be that ceiling. So a 9 Hz sweep typed into
    the sysid panel ran as a 3 Hz one, silently: the two runs saved on 2026-08-19 as
    *_9hz are bit-for-bit 0.05->3 Hz chirps, with 0.12% of the commanded energy above
    3 Hz. The clamp now reads the constant, so there is one number to change.
    15 Hz because the drive closes at ~4.7-5.0 Hz on both legs now. Gain crossover
    and the phase margin that goes with it live at 5-12 Hz, entirely outside the old
    window -- the sweep could not see the margin because it never excited it. Not
    high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
2026-08-19 webui: run the UI in its own process so it stops stalling the CAN loop
    MEASURED, candump, 8 s, motors LIMP:
    direction rate sd p99 worst
    RX motor status 0x29xx 200.1 Hz 0.04 ms 5.1 ms 5.5 ms
    TX Pi's SET_CURRENT 0x01xx 156.6 Hz 6.4 ms 45 ms 72.9 ms
    Both cross the same MCP251xFD on the same 20 MHz SPI, so the transport is not at fault -- receive
    is clean to 40 us. The Pi's own transmit loop was dropping 21.6% of its 200 Hz slots. Gaps over
    10 ms occurred 9.16 times a second against a browser polling at 9.1 requests/s: one stall per
    request, 24.3% of wall-clock lost inside them. The UI was eating a fifth of the control loop.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
    [server.py, uiproc.py]
2026-08-19 webui: move /api/state's disk half off the control process too
    The process split halved the damage (TX 156.6 -> 176.8 Hz, time lost 24.3% -> 12.7%) but request
    accounting over a clean 15 s window showed why it was only half: the control process was serving
    16 telemetry_raw + 16 sensors_raw + 16 /api/state, and /api/state was still being built there and
    proxied verbatim. It calls measurestore.list_summaries(), which opens and reads the metadata of
    EVERY saved run -- 18 npz files off the SD card -- plus two more directory listings, about once a
    second, in the process holding a 200 Hz deadline.
    None of that changes unless a human saves, deletes or calibrates. So it is split:
    /api/state_hot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
    [server.py, uiproc.py]
2026-08-19 webui: decode request.query_string before proxying it upstream
    Flask's request.query_string is BYTES. f-string-ing it produced the repr, so the control process was
    receiving `?b'since=94'`, parsing no `since` at all, and falling back to 0 -- which made every poll
    re-send the WHOLE 512-sample ring instead of the ~15 new samples. The proxy was forcing the worst
    case on every request, exactly inverting the point of the split.
    Caught in the control process's own access log after deploying; the journal shows the literal
    `GET /api/telemetry_raw?b'since=94'`.
    CAN transmit loop, measured with candump over clean 15 s windows, same browser load throughout:
    1 process (before) TX 156.6 Hz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
    [uiproc.py]
2026-08-19 tools: MIT-mode range identification + bandwidth sweep
    MIT mode scales every field by a firmware constant we do not know for either of DASH-01's motors:
    theta_actual = theta_commanded * (P_true / P_assumed), with no error reported anywhere. Both
    existing MIT tools hard-code AK80-9 defaults (P +-12.5, V +-50, T +-18) and neither motor is an
    AK80-9 -- the AK60-39 has no published datasheet at all.
    The trap: a wrong P range is INVISIBLE from MIT data alone, because the feedback is decoded with
    the same wrong range that encoded the command. Ask for 45 deg with P_assumed 2x the truth, the
    shaft turns 90, and the telemetry reads back a perfect 45. Breaking that needs one measurement from
    outside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
    [mit_identify.py]
2026-08-19 foot study: an equal floor check, a tilt metric that measures something real, and the two A/B harnesses
    env: the floor-penetration budget was scaled by each collision geom's THINNEST
    half-extent, so the 10 mm plate was graded against 2.5 mm while the shipped
    25 mm toe got 12.5 mm -- five times harder, and it terminated on STEP 1 of
    every episode on 2 of 6 seeds. The budget is a property of the CHECK ("is the
    solver being driven through the floor"), not of the part, so every foot now
    gets the toe's absolute depth and a termination means the same thing on every
    arm. The sphere plants are bit-identical to before, so ladder3 stays a valid
    control.
    make_foot_variants: tilt is scored per foot TYP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
    [config.py, env.py, make_foot_variants.py, smoke_test.py]
2026-08-19 webui: flat arrays + vectorised NaN handling -> CAN loop reaches full speed
    The UI went VERY slow after the split (dozens of seconds to set a sign during boot calibration) and
    instrumenting the proxy located it: an upstream call that takes 17 ms from a standalone script on
    the Pi took 191 ms from inside a uiproc request handler, with another 136 ms unaccounted in Flask
    dispatch. Neither CPU (28.8%) nor priority (reniced to 0, no change) explained it. It was GIL
    saturation -- the split had MOVED the bottleneck into uiproc, not removed it.
    Two causes, both mine:
    np.savez builds a ZIP container: 9 entries, each with its own header, written in the control
    process and parsed again in uiproc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
2026-08-19 runs_dl: the foot-shape study, all 16 runs — and it is UNDERPOWERED, not a win
    All 16 jobs (jed 66041585-66041600) COMPLETED 2026-08-12, blade and flat, seeds
    0 and 1, rungs m2..m5, cold at m2 and warm by directory upward. Per run:
    progress.csv, curriculum.json, resolved_config.json, training_plots.png and a
    locally rendered greedy eval video. Policies stay in gitignored runs/.
    THE RESULT IS NEGATIVE, and getting there took three wrong readings of the same
    data, all mine. Recorded so the next person does not repeat them:
    1. TRAINING ep_len says the sphere wins at m2 and the feet win nowhere. Wrong
    instrument: the curricula are adaptive and did not land together (at m5 the
    arm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
    [progress.csv]
2026-08-19 tools: probe whether the AK drives answer MIT frames without reflashing
    The AK3.0 upper computer documents "seamless switching between servo and force control modes
    without manual physical switching", which reads as though MIT frames might already be accepted.
    Tested on all four AKE90-8 drives (cam 105, thigh 106, both buses): no MIT reply on any of them.
    Independent confirmation of the same thing: all six motors are still broadcasting servo-mode status
    on EXTENDED ids at 200 Hz, and a drive in MIT mode is silent until commanded. So "seamless
    switching" means the GUI can change the drive's configured mode over the link instead of needing a
    jumper or a separate flashing tool -- it does NOT m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
2026-08-26 new traning branch
    [CamLeftNCS-v1.stl, CamRightNCS-v1.stl, FootLeftNCS-v1.stl, FootRightNCS-v1.stl, HipLeftNCS-v1.stl, HipRightNCS-v1.stl, LegLeftNCS-v1.stl, LegRightNCS-v1.stl]
2026-08-27 pulled all training run
    [progress.csv]
2026-09-01 code for envelope running speed assemment + data from working CPG poliy on M3
    [progress.csv]
2026-09-01 webui: keep the CAN daemon and the front end off each other's cores
    Measured on the robot, idle and LIMP: the 200 Hz loop holds 193 Hz with nothing
    polling and drops to 107 Hz with a browser tab open. uiproc.py already moved the
    JSON work into its own process (2026-08-19), but nothing stopped the scheduler
    from putting both processes on the same core, and on a four-core Pi 3B it will.
    Daemon gets cores 0-1 at nice -10, front end gets 2-3. Under the same polling
    load that measured 107 Hz, this gives 113-135 Hz across repeats -- real but
    noisy, and small next to the per-request cost itself, which is the next commit's
    problem.
    What this deliberately does NOT claim to fix: the GIL. Inside the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
2026-09-01 daemon: the control loop captures state, the caller formats it
    _publish() built the whole UI-shaped snapshot on the CAN thread at 20 Hz:
    nested dicts, a six-motor comprehension, ~24 round() calls and a sine filter
    running str.startswith 30 times. Profiled on the robot's Pi 3B that is 2.005 ms
    per call, 1.24 ms of it pure dict construction, on the thread that owes a CAN
    frame every 5 ms.
    Split into a capture and a formatter:
    _publish() CAN thread, 20 Hz. Reads live daemon state, copies it into
    PLAIN DATA -- arrays it already built, scalars, and dicts
    copied rather than referenced. No formatting.
    _format_snapshot() pure staticmethod of th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
2026-09-01 webui: one persistent stream instead of ~22 requests a second
    polling and 107 Hz with one browser tab open. The cost tracks REQUEST COUNT, not
    payload -- about 1 Hz of control rate per upstream request per second, whichever
    endpoint it is. It is the socket accept, the HTTP parse, the Werkzeug request
    thread and the response assembly, all inside the interpreter that owes a CAN
    The 2026-08-19 process split moved the JSON work into uiproc.py but left the
    shape: three polling endpoints, each browser poll still becoming one upstream
    request. So collapse them.
    server.py /api/stream -- one long-l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
2026-09-01 deploy: record a bit-exact golden trace of the control law
    Groundwork for optimising safety.step / controller.step / fourier_gait. Those
    three are the path verify_export.py signed off against the torch policy, and the
    whole argument for optimising rather than retraining is that the law does not
    change. So prove it: record what it does today, and require every number to come
    back bit identical afterwards. Not close -- identical.
    verify_export.py remains the authority tying the numpy law to the torch policy,
    and it needs torch, mujoco and a training run on disk. This is the complementary
    net: numpy only, runs in half a second, and belongs in the normal suite.
    The trace is built to test the t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
2026-09-01 deploy: cut numpy dispatch out of the control law, bit for bit
    Profiled on the robot's Pi 3B: SafetyGovernor.step made 177 Python calls per
    tick and controller.step 150, almost all of them numpy on SIX-element arrays
    where the dispatch costs more than the arithmetic.
    fourier_gait _weights() rebuilt the same vector every call; memoised, along
    with the harmonic index. assemble() evaluates FOUR series at only
    TWO distinct phases, so the trig is computed once per phase and
    passed in -- 4*2*N scalar np.cos/np.sin calls become 2*2 array
    calls. Applied to walk_mit/fourier_gait.py and copied byte for
    byte, because th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
2026-09-01 daemon: refresh the measured tick budget after the optimisation pass
    The block quoted pre-optimisation numbers. Also records what the arm-time probe
    actually reads in situ (~6.4 ms) versus the standalone median (4.2), because the
    difference is GIL contention inside the daemon process and the gate is right to
    use the larger one.
2026-09-03 Add motor speed/torque limits, dash-frame speed income, and rail/flight sensitivity bars
    - walk_mit: default sprint_*_mit presets to motor_vel_limit + motor_r_ohm (back-EMF
    torque-speed clamp), per the sprint_m3 limits audit finding unclamped swing flicks
    at 2x no-load speed; add sprint_m6_mit_lim as the retrain marker warm-started from
    sprint_m6_mit_s0
    - env: gate speed income on world-x when sprint_world_speed is set, plus an observable
    yaw-rate penalty (w_yaw_rate) as the learnable anti-circling fix after the world-frame
    income alone proved unlearnable (heading is invisible to the actor obs)
    - tools/eval_envelope: add a push-impulse sweep axis and fix the delay axis to bracket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
    [config.py, env.py]
2026-09-09 walk_mit: RUN 8 v2 (sprint_m6_lim2) results and gait_diag audit data
    First two-legged gait on the MIT plant (duty L 0.16/R 0.25 and L 0.11/R 0.33 at
    2.9-3.1 m/s, heading a random walk): final models, progress logs, videos and the
    dash-xy evals for both seeds, plus the gait_diag JSONs/figure that measured the
    residual saturation (60-95% of steps at the +-0.20 rad bound) and clock-rail
    parking on THE RUNNER and on RUN 8 v2 - the evidence behind the latched design.
    [progress.csv]
2026-09-09 walk_mit: offset-knob exactness studies on the loop-closure FK
    fkcheck 1-7 (in-air rig, settled plant) and model/fk_offset_exact.py (exact
    linkage geometry, no dynamics): how faithfully a joint-space offset/gain knob
    maps to a foot-workspace stagger through the 4-bar. fkcheck4 supersedes 1-3.
2026-09-09 walk_mit: DASH-01 Walker v2 latched-spec pipeline (100 Hz, thermal, symmetry, library)
    Implements the "DASH-01 Walker v2" artifact (rev 2026-09-09) on the classic
    MuJoCo / SB3 stack; legacy presets stay bit-identical (smoke suite).
    - action 50 = 44-dim gait spec LATCHED at the phase wrap + 6 per-tick residual
    (gait_v2.py: one Fourier series per joint family, delta/s/o knobs, kp/kd
    phase profiles, (+,+) roll reflex); masked log-prob on non-commit ticks
    (masked_policy.py); SymPPO mirror-equivariance loss (sym_ppo.py)
    - obs = 10x33 history + once-block (spec 44 + task 2 + explicit commit flag)
    + 25-dim privileged critic tail -> 377 actor / 402 critic
    - presets v2_s1 (planar, m3 locks)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
2026-09-09 walk_v2: DASH-01 Walker v2 on MJX/JAX (GPU-batched pipeline)
    New folder implementing the Walker v2 artifact (rev 2026-09-09) as one batched JAX
    program: MJX plants stepped in a vmap, PPO in JAX with the masked log-prob, symmetry
    loss, supervised estimator, gated curricula; 100 Hz latched gait spec, contact resync,
    substep-granular delay, thermal node, DR as batched model fields.
    Plant: rigid ankle folded into the foot pose, leg-axis series spring fitted to 5 mm at
    1 BW (calibrate_plant.py), armature Bode fit; meshes referenced from walk_mit/model.
    Constants the artifact leaves open follow walk_mit/V2_CONTRACT.md. Tools: greedy eval,
    export bundle, margin gate, gait-library solver, cross-imp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
2026-09-10 walk_mit: evaluate at the run's dr_scale, clock diag on commit ticks, v2 monitor scripts
    - evaluate.build: FIFTH eval-restore instance. DashEnv constructs PlantRandomizer at
    scale 1.0 (full-width DR) and only the training callback ramps it, so every
    DR-enabled checkpoint was evaluated on a plant it never trained on (5 deg tilt,
    hot motors, 2 deg homing offsets): a v2_s1 checkpoint trained at dr_scale 0.27
    died in 9 ticks under ZERO action (workspace kill on the toppling plant).
    Restore dr_scale and pitch_assist from curriculum.json like the other ramps.
    - ActionDiagCallback: on the latched policy variant the spec dims (clock included)
    are masked out of the loss on non-commit tick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
2026-09-10 walk_v2: Izar GPU runs, fixed benchmark, MJX solver cap, contract PPO sizing
    - bench.py: warm up at the timed scan length (the static-length recompile was counted as a
    ~600 ms/step floor on CPU and GPU alike); --iterations/--ls-iterations overrides
    - Config.mjx_iterations/mjx_ls_iterations (default 16 x 8) applied in Plant: under jax.vmap the
    Newton loop runs to the slowest env; 1-4 iterations break the stiff loop closure (golden replay
    ends at tick 13), 8-100 x 8 replay the CPU fixture identically to the XML's 100 x 50
    - PPO sizing per V2_CONTRACT: rollout 18 432 (1024 x 18), minibatch 4096, 4 epochs
    - ppo.iterate: blocking phase timers (rollout/gae/update/est) in progress.csv
    - tools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
    [bench.py, config.py, plant.py, ppo.py]
2026-09-10 walk_v2: README throughput table — the 16 x 8 row measured (9.8k env steps/s at 2048 envs)
2026-09-10 walk_v2: README — the 8 x 8 solver-cap row (12.6k env steps/s, same accuracy gates)
2026-09-10 walk_v2: greedy eval exits when every env has ended; eval every 400 rollouts; bookkeeping fields free on resume
    The fixed 6000-step eval scan cost ~200 s on a V100 every 50 rollouts (~120 s of training) even
    when all 16 greedy envs fell within a second: 63% of the wall clock early in training.
    [config.py, ppo.py, train.py]
2026-09-10 walk_mit: v2b presets (readout-1 fixes) + hourly v2 check
    The first v2_s1 chains committed a bang-bang spec (every Fourier family at rms
    0.93-1.0), a clock pinned at exactly 5.00 Hz on 100% of commits and a residual
    carrying 60-67% of the joint motion, and regressed from ep_len ~700 at 19 M to
    ~150 by 33 M while the clock-driven assist fade, the DR ramp and an std anneal
    opened at 92 k steps (swing-frac gate reads 0.4 on a falling robot) overlapped.
    v2b_* = v2 + gait_freq_hz (1.5, 4.0), residual_scale 0.10 / w_residual 0.20,
    competence-gated assist fade (new pitch_assist_gate_ep_len, GatedRampCallback
    open, monotonic fade), ep_len entropy gate (new ent_gate_ep_len) with a 40 M
    deadline, DR/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
    [config.py, train.py]
2026-09-10 walk_mit: DR instability probe (which randomization axis trips MuJoCo)
    Counts episodes whose MuJoCo warning counters advance under random or zero
    actions at a given dr_scale, with per-axis config overrides and a z-score of
    the failing draws against the population. On v2_s1 at dr 1.0: <= 1/150
    episodes, always within 17 ticks of reset, no single axis responsible.
2026-09-10 walk_v2: v2b presets (readout-1 deltas from V2_CONTRACT) and curriculum parity
    - _V2B: gait_freq_hz (1.5, 4.0), residual 0.10 rad / w_residual 0.20, pitch-assist fade opened by
    competence (ep_len > 600, then 30 M monotonic), entropy gate needing ep_len > 600 with the
    deadline at 40 M, DR/jitter gates 1200; presets v2b_s1_planar / v2b_s2_free
    - stance-ratio and efficiency ramps are clock-driven from step 0 as on the CPU arm (they were
    gated at ep_len 600 here); the DR gate keeps curriculum_gate_ep_len
    [config.py, ppo.py]
2026-09-10 walk_v2: readout 2 (v2b collapses when the assist fades), no-assist and stiff-leg presets
    - v2b_s1_planar_noassist: pitch_assist_kp 0 from step 0 (does the latched design learn balance?)
    - v2b_s1_planar_stiff + model/dash01_v2_planar_stiff.xml: 10x leg spring (0.5 mm/BW), the CPU
    arm's effectively rigid rod, to isolate the plant compliance in the per-step learning lag
    - README: matched-step table of v2b on both arms, the collapse/assist-fade coincidence
    [config.py]
2026-09-10 walk_mit: v2c (action-mean bounds loss, competence-tracked ramps, std cap) + probe fixes
    v2b peaked at a stochastic ep_len of 1466-2421 at 23 M and collapsed to ~25 by
    50 M while the std anneal, the assist fade, DR and jitter ramped monotonically
    (curriculum_retreat_frac was 0). mean_bounds_probe.py at 23 M: 68-79% of the
    spec means and 53-60% of the residual means outside [-1, 1], median |mu| ~ 2:
    the unbounded DiagGaussian clipped by the env -- every bang-bang signature and
    the determinism gap are clip(mu) of drifted means.
    - sym_ppo.py: bounds loss w * mean(relu(|mu| - 1)^2) (rl_games bounds_loss),
    logs train/bound_loss and train/mu_out_frac; Config.w_bound (0 = legacy)
    - config.py: v2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
    [config.py, train.py]
2026-09-10 walk_mit: v2c anti-crutch assist penalty, readout-2 docs, v2c monitoring
    v2c adds w_assist_penalty 0.005 (the round-4 anti-crutch term): v2b was a
    greedy dash finisher at 23 M with the assist at 0.8 and collapsed as it faded.
    V2_CONTRACT.md gets the readout-2 table (bounds loss, competence-tracked
    ramps, std cap, assist penalty) and the two probe traps; MONITOR.md the v2c
    playbook; v2_check.sh watches the v2c chains and the warm arm.
2026-09-10 walk_mit: fix SymPPO warm start (set_mirrors), v2c_s1_warm preset, rejuvenation probe
    A warm-started SymPPO crashed on its first train(): train.py re-read the
    mirror kwargs for the new stage and set them with setattr, handing _sym_on a
    plain list (`list object has no attribute size`). SymPPO.set_mirrors() now
    applies the same array conversions as __init__ and train.py calls it; this
    also covers the chained S2 warm starts.
    v2c_s1_warm: S1 -> S1 warm start without the VecNormalize rejuvenation (that
    fix is for milestone hops that free a base DOF). monitor/rejuv_probe.py
    measured the rejuvenation on the v2b 23 M policy: 83 of 402 obs dims floored,
    stochastic episodes unchanged (1000/844 vs 261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
    [config.py, train.py]
2026-09-10 walk_v2: readout 3 — stiff leg collapses with the assist fade like the soft leg; no-assist learns slowly
2026-09-10 walk_mit/monitor: record the fall cause inside a _fallen() wrapper; bounds/assist columns
    The per-tick hook fires after _fallen(), so the ws/floor wrappers were writing
    into the previous tick snapshot and terminal episodes read as "?". The cause
    is now captured at the exact state and moment the env decides. progress_curve
    prints train/bound_loss, train/mu_out_frac and reward_terms/assist_pen.
2026-09-10 walk_v2: v2c presets (bounds loss, std cap 0.7, retreat 0.7, assist-torque bill) mirroring the CPU arm's first working policy
    - ppo.loss_fn: action-mean bounds loss w*mean(relu(|mu|-bound_soft)^2) (w_bound), logged as
    train/bound_loss and train/mu_out_frac
    - _V2C = v2b + w_bound 1.0, curriculum_retreat_frac 0.7, max_log_std ln 0.7, w_assist_penalty 0.005;
    presets v2c_s1_planar / v2c_s2_free
    - README: readout-2 deltas and the pulled CPU checkpoint's greedy dash
2026-09-10 walk_v2: README — the CPU arm's v2c checkpoint at 42 M runs 3/3 greedy dashes with the assist forced to 0
2026-09-10 walk_v2: tools/import_sb3.py — cross-load a walk_mit SB3 checkpoint into a walk_v2 bundle
    Two steps (the torch venv dumps policy.pth + VecNormalize to npz; the JAX venv builds the bundle):
    weight transpose into the identical graph, normalizer statistics, and the one layout difference
    folded into the first layers (walk_v2 frames carry (cos, sin) where walk_mit carries (sin, cos)).
2026-09-10 walk_v2: fast GPU sizing preset (2048x9, 8x8 cap), cross-load findings, per-channel golden replay
    - v2c_s1_planar_fast / v2c_s2_free_fast: 11.0-11.2k steps/s on one V100 (1.45x), same rollout size
    - import_sb3.py: --model-path override, npz dump/import split across venvs
    - replay_golden.py: newest-frame per-channel diffs over the first ticks (phase swapped)
    - README: the CPU checkpoint does not run in MJX (plant build, not interface); the 3-hour plan
    [config.py]
2026-09-10 walk_v2: data-parallel PPO over local devices (--devices N)
    Each device runs its own env batch and rollout (pmap), GAE per device, minibatch updates with
    lax.pmean-averaged gradients and identical replicated params, pooled observation moments, metrics
    re-stacked to (T, N). Replicated trees are placed with NamedSharding(P('dev')) (jax 0.11 has no
    device_put_replicated and refuses committed single-device arrays in pmap). Verified on two emulated
    CPU devices; izar_train.sbatch takes DEVICES (submit with --gres=gpu:N).
2026-09-10 walk_v2: multi-device PPO update fused per epoch (one pmapped lax.scan over the minibatches)
    The per-minibatch pmap dispatch + all-reduce cost ~18 ms a call (0.3-1.2 s per iteration on
    4 GPUs); one launch per epoch instead, with the target-KL early stop carried inside the scan.
    The estimator epoch is fused the same way; its per-device minibatch is clamped to the batch.
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2026-09-10 walk_v2: NaN-robust reward, finite-gradient guard, and the 4-GPU preset with iteration-scaled schedules
    - env: a non-finite plant state is billed as a fall (its reward was NaN and poisoned the update;
    v2c_s1_planar_fast_s0 died at 36.5 M); obs sanitized after the auto-reset select
    - ppo: grad_guard (optax.apply_if_finite) behind a preset flag; Adam's counter located structurally
    - config: v2c_s1_planar_dp4 / v2c_s2_free_dp4 = fast sizing at 8192 envs with schedules x2,
    lr x sqrt(4), 450 M steps, grad_guard
    [config.py, env.py, ppo.py]
2026-09-10 walk_v2: evaluate.py --assist (read out at the training assist level like the CPU arm; 0 = deployable test)
2026-09-10 walk_v2: README status — first wheel-free runner on the GPU arm (v2c_s1_planar seed 1 at 44 M)
2026-09-10 walk_v2: README — the GPU arm's 45 M checkpoint runs 15/16 wheel-free 100 m dashes at 1.7-1.8 m/s
2026-09-10 walk_v2: README — sizing verdict (iteration-bound PPO: 2x rollout converts, 4x does not), protections
2026-09-10 walk_v2: README — best GPU-arm policy: 2 x 2048 seed 2 at 73.7 M, wheel-free 103 m at 2.72 m/s in ~63 min on two V100s
2026-09-10 walk_v2: README — the best GPU checkpoint runs 16/16 dashes to the line at 2.7 m/s (falls at the line, no stop phase)
2026-09-10 walk_v2: README — S2 (free base) launched, warm-started from the best S1 checkpoint
2026-09-10 walk_v2: README status — S2 seeds (3 contract + keepstd hedge), dp4z_s4 cancelled, dp2x_s2 past peak
2026-09-10 walk_v2: S2 (free base) golden replay vs the CPU arm — same fall tick, exact commits, identical rewards
2026-09-10 greedy_peek: contact pattern, post-line stop stats, post-reset sample drop, --assist-off-at
    Per-episode contact line (per-foot duty, flight and double-support fractions,
    touchdown counts, stride Hz) and the behaviour after the 100 m line (upright
    time, mean speed, first time below 0.3 m/s, drift). The post-done sample is the
    auto-reset state, so it is popped before the after-line statistics. --assist-off-at
    zeroes the pitch assist a fixed time into each episode.
2026-09-10 walk_v2: S2 roll-assist training wheel (opt-in preset v2c_s2_free_fast_rollassist; same fade as the pitch wheel)
    The S1 runner falls sideways in 0.7-1.4 s on the free plant, greedy, with or without the pitch wheel,
    so the contract's warm-started S2 starts from nothing (ep_len ~80-190 at 15-24 M on three seeds).
    A roll spring-damper on the base, driven by the pitch wheel's fade scalar and billed in assist_pen,
    carries the S1 competence over. Defaults 0: no existing preset changes; ignored on the planar plant.
2026-09-10 walk_v2: video of the 130 M S1 checkpoint (16/16 x ~103 m in ~36 s, 2.88 m/s, wheel-free, falls at the line)
2026-09-10 walk_v2: README — S2 findings (S1 runner has no lateral balance, roll wheel), 130 M S1 runner at 2.88 m/s
2026-09-10 eval_videos: v2b/v2c 100 m dash renders (best: v2c seed 0 @ 99 M, 32.9 s, 3.33 m/s)
    Greedy, nominal plant, 60 s episodes. v2c_s0_99M_dash and v2c_s1_98M_dash run
    with the pitch assist off and no DR; the 30 M v2c render keeps assist 0.47
    (the value it trained at); the v2b renders keep their trained assist.
2026-09-10 walk_v2: yaw wheel + v2c_s2_free_fast_basewheels preset (the S1 runner spins about yaw on the free plant even with pitch and roll held)
2026-09-10 walk_v2: README — the S1 runner yaw-spins on the free plant (both-wheels probe), yaw wheel
2026-09-10 walk_v2: README — first S2 runner (contract seed 0 at 73.7 M: 94.6 m at 3.02 m/s wheel-free on the free plant)
2026-09-10 walk_v2: S2 runner video (16/16 to 100 m at 3.2 m/s wheel-free on the free plant), seed changes, rigid-hold probe note
2026-09-10 walk_v2: README — quota outage and recovery, robust 147 M runner lost between checkpoints, S2->S2 warm start transfers
2026-09-10 walk_v2: stop curriculum — red light / green light phases + deceleration target (opt-in preset v2c_s2_free_fast_stoplight); resume falls back past truncated checkpoints
2026-09-10 walk_v2: gait-frequency floor curriculum — the 1.5 Hz rail is a free-plant attractor that kills every cold S2 seed
    Four cold S2 seeds (three with the stop curriculum, one plain-contract control) all parked the clock on
    the 1.5 Hz rail by 6-26 M. The control clears the stop curriculum, and an old-vs-new env parity test is
    exact with the lights off. Cold S1 (planar) never rails; warm S2 visits the rail and escapes. Fix:
    gait_freq_lo_start ramps down to gait_freq_hz[0] over gait_freq_floor_steps so a slow gait is not
    selectable while the gait forms. Off by default (static branch); preset v2c_s2_free_fast_floorstop.
    [config.py, env.py, ppo.py]
2026-09-10 walk_v2: README — deployment note, the stop curriculum turns task[0] into a live stop command
2026-09-10 walk_v2: the stop command is a continuous target speed, not a binary flag
    Measured: the 59 M stop-curriculum runner falls 0.7-0.8 s after every red light in 16/16 episodes and
    spends 0% of the red phase slow. The flag flipping 1 -> 0 in one tick is a step disturbance on an input
    the gait is conditioned on, and at w_stop_vel 0.4 braking was never worth finding. task[0] now carries
    the normalised target speed under stop_cmd_continuous (hard preset only; contract presets unchanged).
    [config.py, env.py]
2026-09-10 walk_v2: video of the 73.7 M S2 runner (16/16 x 100 m at 2.84 m/s wheel-free on the free base, ~70 min)
2026-09-10 walk_v2: README — the deceleration demand was 7x the requirement; 2.95 m/s runner banked
2026-09-11 walk_v2: the commanded speed follows the deceleration ramp, so the gait shaping stays live while braking
    cmd_speed was binary (v_ceiling while running, 0 the instant the light turned) and gates the whole gait
    block via gait_on. The robot therefore had no gait shaping at all through the 2.5 -> 0 m/s ramp, the
    intermediate-speed regime it has never been shaped in. Braking income plateaued at ~0.033 of a possible
    ~0.38. Under stop_cmd_continuous the shaping now tracks the command down and releases at a standstill.
2026-09-11 walk_v2: Laplace speed tracking during the stop — the Gaussian had no gradient where the policy actually lives
    Instrumented the fall: asked to slow, the policy lowers the gait clock 4.0 -> 2.4 Hz and ACCELERATES to
    3.3 m/s (faster than its 2.65 average), overstrides and topples, never slowing at all, at 8 s and even
    20 s ramps. The cause is the reward shape: at a 1.8 m/s error the Gaussian pays 0.006, a flat region
    with no direction information. exp(-|e|/sigma) pays 0.105 there, 17x the signal, gradient everywhere.
    [config.py, env.py]
2026-09-11 walk_v2: README — instrumented why the robot will not stop (it accelerates and overstrides when asked to slow)
2026-09-11 walk_v2: amber phases — the robot must learn to run SLOWLY, not only to stop
    Five measured fixes all failed identically: asked to slow, the robot drops the cadence slightly and
    ACCELERATES to ~3.1 m/s, overstrides, falls in ~1.3 s, 0% of the phase slow -- even at a 20 s ramp
    asking 0.15 m/s^2. The deficit is not braking: this robot only knows ONE SPEED (every policy in the
    project trained at the sprint and nowhere else), and lowering the gait clock on this plant makes it
    FASTER, not slower. Most light phases now ramp down to a slow run drawn from amber_speed_band and the
    policy has to hold a gait there; the line still demands a true stop. Off by default.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
    [config.py, env.py]
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2026-09-11 walk_v2: eval reports speed-tracking error during the light phase (amber targets a slow run, not a stop)
    [evaluate.py]
2026-09-11 walk_v2: capture-step braking reward (feet ahead of the CoM while above the commanded speed)
    Instrumented across every stop variant: at the fall the robot is doing 3.0-3.4 m/s against a ~2.3 m/s
    command, i.e. it ACCELERATES into the fall. Cadence is the only lever it uses, and on this plant
    dropping the clock lengthens the stance and the push, so it pitches forward. Braking needs a capture
    step -- the stance foot planted AHEAD of the CoM -- which walk_mit measured as absent in this lineage
    (feet land ~8 cm behind while falling). w_brake_foot rewards it, gated on running faster than
    commanded so it never fights the running gait. Off by default.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
2026-09-11 walk_v2: the capture-step reward must be signed — it earned exactly 0.000 on all three seeds
    Confirmed on the live env: the term and its gate compute correctly, so an income of exactly zero during
    braking means the feet are BEHIND the CoM there (walk_mit m3 measured ~8 cm behind while falling) and a
    reward clipped at zero is flat precisely where the robot lives. Signed now, so moving the foot forward
    pays even while it is still behind, and being above the commanded speed with trailing feet costs.
    [env.py]
2026-09-11 walk_v2: slow-runner preset — test whether a 1.8 m/s policy can stop when a 2.9 m/s one cannot
    Eight measured interventions have failed to teach a stop from ~2.8 m/s. The requirement is 'run 100 m
    and stop within ~20 m', not 'run at 3 m/s': at 1.8 m/s that budget needs 0.08 m/s^2, a quarter of what
    it needs at 2.9. A slower runner that stops is worth more than a fast one that cannot.
    [config.py]
2026-09-11 walk_v2: video of the project-best runner (101.9 m at 3.04 m/s, free base, wheel-free, 59 M steps)
2026-09-11 walk_v2: README — the stop, eight measured interventions and what is left to try
2026-09-11 walk_v2: brake_search.py — is a stop expressible by the v2 action space at all?
    Nine reward-shaped configurations failed to teach braking. Two explanations remain with opposite fixes:
    RL exploration, or the latched Fourier action space simply not containing a stop. This decides between
    them without training: run a trained policy to steady state, then switch the policy OFF and drive the
    gait spec directly with a smooth schedule (frequency, cam/thigh amplitude, fore-aft offset, lean), and
    search schedules by cross-entropy method inside the batched env, one candidate per env. If any schedule
    brings the robot to a standstill upright, it is exploration; if thousands cannot, it is architecture.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
2026-09-11 walk_v2: brake_search must keep the policy residual, and now runs a cruise control
    First run reported 'no stop found' with 0/512 upright in EVERY iteration, including near-cruise
    schedules -- not credible, and the harness was the reason: it zeroed the per-tick residual, which is
    45-95% of joint motion on this lineage, so it removed the stabiliser rather than testing the gait spec.
    The policy now stays in the loop for the residual and only the latched spec is overridden, and iteration
    0 evaluates a cruise schedule as a control so a broken harness is visible at once.
2026-09-11 walk_v2: A STOP IS EXPRESSIBLE — brake_search demo mode, and the schedule that stops the 3.09 m/s runner
    Corrected search (cruise control 512/512 upright, so the harness is sound): from 3.31 m/s the CEM finds
    schedules that reach 0.000 m/s UPRIGHT, with 399-429/512 candidates upright and the elite mean at
    0.001 m/s by iteration 5. The action space contains a stop; the nine failed reward variants were an RL
    exploration failure, not an architectural one. The winning schedule also explains the failure: braking
    here means INCREASING cadence (x1.15 -> x1.29), holding stride amplitude, shifting the feet FORWARD
    (o_cam +0.20 -> +0.42, the capture step) and leaning back -- the exact opposite of th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
2026-09-11 walk_v2: brake before the line — past it the policy's own residual fights the schedule
    The first demo ran the full 100 m then braked and fell in 0.5 s. The schedule is not at fault: past the
    line the env enters the stop phase, and the policy's residual response to that is exactly the
    destabilising behaviour this investigation measured. Braking now begins a stopping-distance short of the
    line, so the robot stays in the run phase and comes to rest ON the line -- which is what stopping at a
    line means anyway.
2026-09-11 walk_v2: brake prior — the measured braking direction as part of the control law
    tools/brake_search.py established that a stop IS expressible (cruise control 512/512 upright; from
    3.3 m/s hundreds of schedules reach a standstill upright, elite mean 0.001 m/s). The direction it found
    is the opposite of the policy's learned response on every axis: MORE cadence (x1.15-1.29), stride held,
    feet shifted FORWARD (o_cam +0.20 -> +0.42, the capture step), lean back. The latched spec is now biased
    that way while the robot is above its commanded speed, in the same idiom as the pitch reflex already in
    the control law. The policy keeps full authority to modulate it. Off by default.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
2026-09-11 walk_v2: README — the stop is expressible; the braking direction is the opposite of what the policy learned
2026-09-11 walk_v2: bank the 3.27 m/s runner, and make the deploy export honest about the curriculum
    The dash is solved. v2c_s2_brakeprior_s41 at 103 M steps runs 16/16 greedy episodes over
    103.1-104.8 m at 3.23-3.29 m/s (~31.7 s) -- the fastest straight dash in the project, past
    walk_mit's 3.07 m/s THE RUNNER. Video in results/. Every one of those 16 episodes still ENDS
    in a fall: post-line the policy holds 2.2-2.8 m/s and topples ~1.3 s later. The stop, not the
    run, is what is left.
    That is the verdict on the brake-prior experiment too: three seeds x 220 M steps (660 M) with
    the strongest stop shaping built so far -- Laplace tracking, signed capture-step reward, the
    amber speed floor, the continuous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
    [export.py]
2026-09-11 walk_v2/README: intervention 10, and the case for taking the brake away from PPO
    The brake prior closed the last open reward idea: feed the CEM's measured braking direction
    straight into the control law (cadence up, feet forward, lean back) as a prior, same idiom as
    the pitch reflex. Three seeds x 220 M steps, zero finishes, every seed railed to 1.5 Hz.
    Ten configurations, no stop -- while that same 220 M budget produced the fastest runner the
    project has (3.27 m/s, 16/16 over the full 100 m). PPO reliably buys the dash and reliably
    refuses the brake, and the CEM finds a stop in a few thousand rollouts. So fit the schedule per
    checkpoint and hand the runtime 12 numbers.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
2026-09-11 brake_search: report the demo as a 512-episode sample, and stop reading auto-reset garbage
    Two corrections to --demo, which is what has to produce the deliverable number ("crosses the
    line and stops within 20 m"):
    The envs are NOT clones. reset_joint_noise gives every env a different starting pose (0.03 rad)
    and a ~27 s run-up amplifies that into independent episodes -- the old comment claimed they only
    diverge once the schedule takes over, which is what made the demo look like a single anecdote.
    Putting one schedule on every env is therefore already a pop-sized sample, so report it as one:
    upright count, how many reach a standstill, how many do so within 20 m of the line, and the
    spread of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
2026-09-11 brake_search: fit the schedule at the brake DISTANCE, not at a hand-computed time
    --cruise-s now only bootstraps the speed estimate; the run-up is then extended until the robot
    reaches the brake point (the line minus the stopping distance), the same point --demo brakes at.
    This failure mode is quiet and expensive. A run-up two seconds too long starts the robot past
    the brake point, so the whole 8 s window straddles the finish line, the env sits in its stop
    phase for most of it -- where the policy's own residual fights the schedule -- and every
    candidate falls. It prints as 0/512 upright in every iteration, which reads as "no stop exists"
    when the stop was merely mistimed. Two fits were burn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
2026-09-11 brake sbatch: expose SEED so a demo runs on episodes the fit never saw
    env.reset splits its key per env, so reusing the fit's seed replays the very episodes the CEM
    selected its schedule against, and the stop rate comes back flattering. The demo is the number
    that decides whether this ships, so it has to be measured on held-out episodes.
2026-09-11 brake_search: score each candidate on several episodes, not one
    The envs are independent episodes, so one candidate per env scored a schedule on a SINGLE
    episode and the CEM was free to select luck: the elite were schedules whose one episode happened
    to be kind, which is exactly the kind of fit that evaporates on a held-out seed in --demo.
    --reps (default 4) gives every candidate its own block of episodes and scores it on the mean,
    where a fall costs 1e3 -- so a schedule must survive all of its episodes before its speed is
    compared at all. Iterations now report both episodes upright and candidates upright in ALL
    their episodes, which is the number that predicts the demo.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
2026-09-11 brake_search: the cruise control means different things at different fit points
    Mid-run it is a harness check and must be ~all upright. At the brake point the same control
    runs past the finish line into the stop phase and should mostly FALL -- that fall is the
    problem being solved. The old message called it a harness bug either way, which is exactly
    backwards where it matters most.
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2026-09-11 brake_search: --hold-run, don't tell the policy about the line while braking
    The held-out demo settled the open-loop question the wrong way: a schedule fitted at the brake
    point reaches 0.000 m/s on 297/512 of the episodes it was fitted to, and on a seed it has never
    seen it stops 8/512. It also stops SHORT -- the 8 that work come to rest a median 6.5 m BEFORE
    the line, so they do not even finish the dash.
    The mechanism this targets: both the policy's distance-to-go input and the env's stop phase come
    off params.sprint_dist_m, so past the line the policy switches to the stop response measured
    across ten training configurations -- it drops cadence and accelerates -- and fights the schedule
    e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
2026-09-11 brake_search: under --hold-run the cruise control is expected to stay UP past the line
    And it does, which is the measurement that matters: 512/512 upright crossing the line with the
    run flag held, against 3/512 and 79/512 for the same control when the policy is told it has
    finished. The robot does not fall at the line because stopping is hard -- it falls because it is
    told to stop.
2026-09-11 brake_search: the demo runs to the brake DISTANCE, measured, not an estimated time
    d_brake/v0 + 2 s ignores the acceleration from rest, so the demo began braking metres past the
    point the schedule was fitted at -- and these schedules are sensitive enough to their starting
    state that the mismatch alone can decide the result. The fit and the demo now begin at the same
    measured distance, so the demo tests the schedule rather than the estimate.
2026-09-11 brake_search: the demo video shows a representative SUCCESS, not whatever env 0 did
    At an 18% stop rate env 0 usually is not a stop, so the video showed a robot falling while the
    statistics printed above it reported the stop working -- the worst possible pairing for a result
    anyone has to trust. The demo now records 16 envs (~95% chance at least one stops) and renders
    the stopped env closest to the median overrun, naming which env and why. When nothing stopped it
    says so and shows the one that got furthest, rather than quietly showing a failure.
2026-09-11 brake_search: report the upright-but-still-rolling episodes
    31% of held-out episodes reach a standstill and 100% stay upright, which leaves 69% doing
    something the output did not describe at all. They are not falls -- they are stops the window
    ended too soon for -- and whether they are at 0.3 m/s or 2.0 m/s decides whether the fix is a
    longer window or a harder-braking schedule. So print their speed distribution and where they are.
2026-09-11 brake_search: grade falls by when they happened, so the search has something to climb
    A flat 1e3 for any fall gives the CEM no signal in the regime where every candidate falls: the
    scores tie, the elite are arbitrary, mu and sd drift, and the run never recovers. That is exactly
    how a --reps 8 fit died at 0/512 on a problem --reps 4 had already solved, and it is the likely
    reason the 3.27 m/s runner returned 0/512 twice -- not that no stop exists for it, but that
    nothing ever ranked above anything else.
    Falls now score 100..200 by how much of the window they survived, still strictly worse than any
    upright candidate (which score their minimum speed, under ~4), so a candidate that falls late
    r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
2026-09-11 brake_search: show the search climbing when nothing is upright yet
    The iteration line printed nan for the best score whenever no candidate stayed up, which is
    precisely the regime the graded fall score was added for -- so the one output that could confirm
    it works looked identical to being stuck. It now reports how much of the window the best
    candidate survived.
2026-09-11 evaluate: --free-clock, to measure the dash without the privileged touchdown resync
    In sim the gait clock is pulled toward the measured touchdown phase by kappa ~0.5, and that
    touchdown comes from the MJX contact array and toe geom heights -- simulator ground truth, never
    the IMU. DASH-01 has no foot contact sensor, so on the robot nothing can produce the event and
    robot/deploy/controller_v2.py free-runs the clock, which its docstring already calls a real
    sim2real difference.
    That means every dash and stop number this project has reported, including the 3.27 m/s 16/16
    runner, was measured with the clock phase-locked by a signal the hardware cannot supply. This
    flag measures the deployment c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
2026-09-11 brake_search: --free-clock, so a schedule can be fitted the way the robot will run it
    Measured first: the dash does NOT need the privileged touchdown resync. Same checkpoints, same
    seeds, kappa forced to zero -- the 3.27 m/s runner still covers 103.1-104.9 m at 3.20-3.28 m/s
    (against 103.1-104.8 at 3.23-3.29 with the resync), and capture_s35 still covers ~101 m. The
    policy tolerates phase drift, which fits a design that latches the spec once per cycle and leaves
    the stabilising to the per-tick residual.
    Braking is the case where phase alignment should matter most, and every schedule so far was
    fitted with the resync on, so a schedule intended for hardware should be fitted without it.
    Co-Au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
2026-09-11 walk_v2/README: neither running nor braking needs the privileged touchdown signal
    The gait clock's touchdown resync reads the MJX contact array and toe geom heights -- simulator
    ground truth the robot cannot supply, since DASH-01 has no foot contact sensor. Every number this
    project reported was measured with that lock and nobody had checked without it.
    Measured now, both ways. The dash is unchanged (103.1-104.9 m at 3.20-3.28 m/s against
    103.1-104.8 at 3.23-3.29). Braking, fitted AND replayed free-clock: 511/512 upright and 128/512
    stopped, against 476/512 and 151/512 with the resync -- and 151->128 sits inside this
    measurement's noise, since the same schedule gave 161 and 167 on two seeds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
2026-09-11 brake_search: --stagger-s, a brake that works whenever the button is pressed
    The use case is red light / green light in a short corridor, not a 100 m finish line: the stop
    arrives whenever the operator presses, so the schedule has to bring the robot down from whatever
    state it is caught in. Every schedule so far was fitted at ONE state (~88 m, ~27 s in, full
    cruise), and schedules have already proven state-specific -- the 6 s-fitted one toppled when
    replayed at 88 m.
    --stagger-s draws each episode's brake start independently over a window, so a candidate is
    scored across the spread rather than at a point. Each env now latches its own spec at its own
    start tick and runs the policy untouched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
2026-09-11 brake_search: the demo run-up must see the same world as the brake window
    Under --hold-run the brake window pushes the finish line out of range, but the run-up still ran
    with the line at 100 m. So a late brake point spent its approach inside the last task_brake_m
    (8 m), where d_to_go ramps and the policy begins the pre-stop behaviour this whole investigation
    measured, and some episodes crossed the line outright before braking even started.
    That is what made a 95.1 m brake point collapse to 6/512 upright while 91.8 m held 511/512 -- a
    cliff in the harness, not in the schedule. It is also just wrong for the red-light case the tool
    is now being used for, where there is no finish line anywhere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
2026-09-11 brake_search: score stopping DISTANCE, and keep job logs out of the shared repo root
    The search only ever asked for a standstill, so among schedules that stop it had no reason to
    prefer one that stops SHORT -- and distance is the only thing a corridor cares about. The first
    staggered hallway fit stops in 21.4 m, which is more hallway than most people have. --w-dist
    weights metres against leftover speed (0.05 makes 20 m cost what 1 m/s does).
    Logs now go to walk_v2/logs/ instead of the repo root, which is a home shared with another
    agent's work: a sweep of *.out there today deleted the printed statistics for three completed
    jobs. The fitted schedules and videos survived because they are writ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
2026-09-11 brake_search: stagger the demo too, and report stopping distance from the brake start
    The fit learned to stop from a staggered trigger but the demo still braked at one rehearsed
    distance, so it never measured the thing the fit was for: the button arriving whenever. Each
    demo episode now starts braking on its own tick, latches its own spec there, and reports the
    distance covered from ITS OWN brake start -- which is what a corridor has to fit, where overrun
    past a finish line was a constraint from a different test.
2026-09-11 walk_v2/README: red light / green light, and why asking for a SHORT stop made it robust
    The real test is a >40 m corridor with an operator pressing stop, not a 100 m finish line: no
    line, no odometry problem (the human is the trigger), and stopping distance is the metric.
    A random trigger is much harder than a rehearsed brake point -- 399/512 upright against ~511/512
    -- because one open-loop schedule now has to work from whatever state the button catches. Adding
    stopping distance to the objective fixes it on every axis at once: 500/512 upright, 213/512
    stopped, median 19.6 m, worst 26.0 m.
    That is the reps-8 lesson mirrored. An objective that only says "do not fall" drifts to gentle
    schedu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
2026-09-11 walk_v2/README: record that pushing the brake search harder loses on held-out
    w_dist 0.15 with 12 iterations fits 16.3 m and then gives 446/512 upright, 47/512 stopped and a
    median 24.8 m held out -- worse than w_dist 0.05 on every axis, with the fit's own number not
    surviving at all. Third harder-optimisation loss of the day after --reps 8, same mechanism each
    time: a longer or harder CEM narrows onto the episodes it was scored against.
    Written down so the recommended settings do not get "improved" later.
2026-09-11 v3: a joystick objective with no privileged input in the actor path
    THE CLOCK NO LONGER TOUCHES FOOT CONTACT. The touchdown resync is now behind a trace-time flag,
    default OFF, so when disabled the whole block is compiled out and no contact quantity reaches the
    clock -- and therefore neither the actor's phase [cos, sin] nor its commit flag, both of which the
    resync could move. Measured 2026-09-11: removing it changes neither the dash (103.1-104.9 m at
    3.20-3.28 m/s vs 103.1-104.8 at 3.23-3.29) nor braking (511/512 upright vs 476/512). Old runs
    replay because their resolved_config.json carries enable=True.
    THE TASK NO LONGER CARRIES ODOMETRY. Under objective="joystick", task = [v_cmd / v_max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
    [bundle.py, config.py, env.py, export.py, ppo.py]
2026-09-11 artifact: correct the DASH-01 Walker v2 design document against what was built
    The artifact is a published page, not a repo file, which is how it drifted from the code unnoticed.
    Its source now lives in walk_v2/artifact/ so the two can be diffed.
    It was wrong in seven places before v3 touched anything: actor/critic 376/401 (built 377/402, and
    every privileged index shifts with it), residual +-0.20 rad (built +-0.10), gait clock 0.5-5 Hz
    (built 1.5-4.0), the spec emitted by a solved library plus a Raibert law (the deploy runtime refuses
    that variant outright -- it builds its spec from true body velocity), and a Stage 0-5 pipeline that
    was never used. The contact resync was presented as the N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
    [config.py, export.py]
2026-09-11 v3: the zero command and the off-nominal starts must ride their own curricula
    Both seeds degraded within 7 M steps -- one onto the 1.5 Hz rail it never returns from -- and the
    cause was two knobs that ignored the curricula wrapped around them.
    cmd_zero_frac made a quarter of commands exactly zero from the first rollout, regardless of the
    command band being ramped from [0.8, 1.0]. So a warm-started 3.27 m/s runner was being told to stop
    a quarter of the time before it had learned what the command meant, which is the surest way onto
    the slow rail. The zero share now ramps with the band: "stop" is the hardest command this lineage
    has, so it arrives last.
    The bring-up SHARE was fixed too, not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
    [config.py, env.py, ppo.py]
2026-09-11 train: keep the checkpoint that tracks the command, not the one that runs furthest
    Under objective="joystick" the best-checkpoint keeper was still (finishes, distance) -- and
    `finished` is hardwired False there, so it reduced to "keep whatever covered the most ground",
    which is precisely the policy that ignores the stick and sprints. best_speed.msgpack would never
    have been written at all, since it requires covering the full 100 m and these episodes are 30 s at
    varying commanded speeds.
    The greedy eval now accumulates |v - v_cmd| per env, and the joystick keeper is (survivors, then
    lowest command error). The per-eval line prints it too, so a run that has quietly stopped obeying
    the command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
    [ppo.py, train.py]
2026-09-11 budget: measure the env training actually starts in, not the end of every curriculum
    EnvParams.final() is full bring-up, full command range and the assist off -- a
    much harder env than step 0. Reading the budget there mistakes the curriculum
    for a policy failure. _initial_params becomes module-level initial_params(cfg)
    so diagnostics can reproduce the training condition instead of guessing it.
    [ppo.py]
2026-09-11 joystick: scale the tracking income by the commanded speed
    Measured with tools/reward_budget.py on the same checkpoint and plant: the
    sprint objective earns 5.11/tick of income against 2.69 of cost (net +1.32,
    600/600 ticks, no falls); the bounded tracking income earned 0.57 against an
    almost identical 2.50 (net -0.55/tick after the step floor). Costs were never
    the problem -- deleting fwd_speed removed 94% of the income.
    With fall_penalty 100 the break-even horizon is ~200 ticks against 3000-tick
    episodes, so dying immediately was worth ~15x living. Both v3 seeds found
    exactly that: clock railed to its 1.5 Hz floor, residual saturation 0.06,
    ep_len collapsing. Cancelled at 12.5 M.
    The inc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
    [env.py]
2026-09-11 env: correct the break-even arithmetic in the income comment (scale 0.5 => ~200 ticks, ~15x)
    [env.py]
2026-09-11 joystick: hold the reserved task channel at 1, not 0 -- 0 means BRAKE NOW
    task[1] is v2's distance-to-go ramp: 1.0 whenever the line is far away, 0 only
    to demand a stop. Pinning the reserved channel at 0 told the warm-started runner
    to brake on every tick.
    Measured (tools/reward_budget.py --curriculum start, bringup_scale 0): under a
    3.2 m/s command the 3.27 m/s runner made ~0.1 m/s, earned 0.05 of a possible
    9.0 of tracking income and fell 100% of the time inside 86 ticks -- while the
    same checkpoint runs 600/600 upright in the sprint preset. Zero is not a neutral
    filler for a warm start; it is the strongest stop signal the obs can carry.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
2026-09-11 deploy: joystick bundles must send task[1]=1, matching the trainer
    The controller emitted 0 for the reserved channel, which under v2 semantics is
    'brake now' rather than 'unused'. On hardware that would have held the policy in
    a permanent stop request while the slider asked for speed. Matches the env fix.
    [controller_v2.py]
2026-09-11 v3: give living a positive floor (w_alive 0.5 -> 1.5)
    With the task[1] fix the warm start runs 600/600 upright at a 3.2 m/s command,
    but income 1.42 against 1.66 of cost still made living net-negative at every
    command. alive is a constant per-tick term, so +1.0 lifts all four measured
    command points to positive living (+0.20 to +0.42/tick) without re-measuring.
    It stays small against the 9.0 peak of the tracking income, so it is a floor
    under survival rather than a standing attractor: at a 3.2 m/s command standing
    pays 0.5/tick against running's 3.8.
    [config.py]
2026-09-11 v3: command sweep + an unattended verification suite
    command_sweep.py is the deliverable measurement -- hold v_cmd at each stick
    fraction and report achieved vs commanded speed. It re-pins the command every
    tick (the env redraws on a timer and on auto-reset), averages over the settled
    tail rather than the transient, and reports survivors separately from speed so a
    fallen robot at a 0 m/s command cannot read as perfect tracking.
    izar_v3_verify.sbatch chains the whole plan's verification list behind
    --dependency=afterany on the training jobs, so it runs unattended when they stop.
    afterany, not afterok: a job that dies at the wall clock still leaves checkpoints
    worth measuring.
    Co-Authored-By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
2026-09-11 audit: separate a privilege leak from float32 contact divergence
    tol=0.0 made the test measure arithmetic, not privilege: a 25 m coordinate
    offset changes the last bits of every contact position and a stiff solver
    amplifies that over ticks. The v3 checkpoint 'failed' with its first divergence
    in motor_pos -- a consequence of dynamics, not a channel that encodes anything.
    At tick 0 both runs see an identical actor observation and emit an identical
    action, so a genuine leak must move an INFORMATION channel (phase, task,
    commit) immediately. The audit now reports those separately, takes --tol, and
    says which reading applies.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
2026-09-12 audit: test the observation FUNCTION, not a chaotic rollout
    The rollout audit answers neither question: float32 contact solving diverges
    from a 25 m coordinate offset alone (so it reports arithmetic as a leak), while
    its positive control shows ZERO information-channel movement on a v2 checkpoint
    that demonstrably HAS a leak -- a +25 m shift never moves task[1] off its
    saturated 1.0, and raising grounded_h cannot change an OR that the contact array
    already satisfies.
    This perturbs only unmeasurable bookkeeping (the odometry origin, the touchdown
    phase estimate) on a fixed physics state, so any actor delta is information, not
    amplification. Includes a negative control, and a skipped perturbat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
2026-09-12 audit: judge against the measured noise floor, not 1e-9
    env.step on a GPU is not bit-reproducible, so an unperturbed re-run already
    costs ~3e-5 and a 1e-9 threshold called every row a leak. Calibrating on that
    re-run makes the verdict readable: v3 odometry 4.4e-5 sits AT the floor, while
    the v2 control reads 1.0 -- 25,000x above it, in TASK[0] and TASK[1].
2026-09-12 tools: keyboard joystick player -- drive the v3 policy in MuJoCo with W/S
    Runs the SHIPPING numpy control law (robot/deploy/controller_v2) against CPU
    MuJoCo, so it needs no JAX and what you feel is what the Pi would execute. The
    software PD and its torque-speed envelope come from the bundle, so the player
    cannot silently drift from what was trained.
    Cross-validates the MJX sweep from an independent code path: 0% -> 0.30 m/s
    upright, 50% -> 1.93, 100% -> 4.51 then falls at 4.6 s.
2026-09-12 player: body-frame speed and an optional yaw lock
    World-x is the wrong readout: the policy tracks its own forward axis, so a
    half-turn makes an obedient robot read as running backwards. Measured at full
    stick: world-x 4.51 m/s vs true forward 3.39 m/s, the gap being body pitch as it
    falls. --lock yaw|rail holds the heading straight (a sim aid, not a policy fix --
    it raises full-stick survival 4.6 s -> 7.4 s, which says heading drift is part of
    why it tips).
2026-09-12 walk_v3: a from-scratch forward joystick that runs straight and can be dropped
    walk_v3/ trains a joystick policy from random weights -- no warm start, no
    checkpoint inherited from another run. Four changes, each fixing something
    measured rather than suspected.
    Curricula that cannot silently never happen. v2 advanced every curriculum only
    while the EXPLORING policy's episodes exceeded a fixed tick count, and _V2B set
    that to 1200 on a task whose episodes run 300-900. dr_scale therefore finished at
    0.000 in three separate runs (55 M, 135 M, 215 M) -- including the one the project
    called robust-trained -- with dr_enable=True in every config and no warning
    anywhere. v3 gates on a fraction of wh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
    [bench.py, config.py, controller_v2.py, drive.py]
2026-09-12 walk_v3: real deploy parity, heading invariants, and a probe comparison
    verify.py check 7 compared nothing: it shelled out to tools/trace.py with flags
    that tool does not have, so it always took the skip branch. It now exports the
    bundle and runs the ROBOT's numpy actor (robot/deploy/policy_net.PolicyNet) on
    200 observations taken from a live rollout, against the JAX actor on the same
    observations, and checks the bundle declares the heading channel at the trainer's
    frame width. A policy that only exists inside JAX is not deployable and the
    failure mode is silent.
    smoke_test gains the heading invariants, none of which the width checks catch: a
    frame that is the right width but writes the hea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
    [smoke_test.py, verify.py]
2026-09-12 walk_v3: the objective paid a policy to die; ramp the gait-quality penalties
    Measured with tools/reward_budget.py on two cold runs, one per plant, at the
    start of the curriculum: income 1.87, cost 2.34, LIVING -0.236/tick. Against a
    one-time fall_penalty of 100 that makes dying immediately worth 7x staying alive
    over a 3000-tick episode, so the optimiser correctly hunts for the shortest
    episode -- which on this plant means railing the gait clock and falling early.
    That is exactly what all seven cold arms did: every free-plant arm sat on the
    1.5 Hz floor, and the planar arm left the floor only to rail the 4.0 Hz ceiling.
    The cost is not efficiency. torque, motor_vel and energy already ramp t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
    [config.py, env.py, ppo.py, train.py, verify.py]
2026-09-12 walk_v3: keep the anti-hop guards at full weight, and stop DR passing when it is off
    duty_sym, swing_floor and stance_time were in the shaping ramp. They were 0.0% of
    the measured cost, so ramping them down buys nothing, and they are the guards
    against the two pathologies this plant falls into -- the one-legged hop (walk_mit
    measured 4.76 Hz with left duty 0.01) and the dragged stance -- both of which this
    lineage has found hard to unlearn once established. Out of the ramp.
    Checked on the running cold runs before changing anything: swing_frac_min is
    0.25-0.27 and duty_sym is ~-0.001, so both legs swing a quarter of the time and
    no hop has formed. The 4.0 Hz the clock now sits at is not the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
2026-09-12 walk_v3: two stages, one objective; deploy tests for the heading channel
    The ladder collapses from three stages to two, and both now use the joystick.
    Measured cold at 11-17 M steps, everything else equal: joystick-on-planar reached
    ep_len 473 / return 400, the speed objective on the same plant reached 411 / 134,
    and the joystick on the FREE plant went backwards (143 / -46). So the plant is
    what a cold start cannot take, not the command. Keeping one objective across both
    stages also means the task channel never changes meaning under a warm start,
    which is its own class of bug here -- task[1] pinned to the wrong constant cost
    this project a full run once already.
    robot/deploy tests: four new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
    [bundle.py, config.py, gait_v2.py, run_policy.py]
2026-09-12 walk_v3: verify.py read a config of Nones
    check_curriculum re-read resolved_config.json and looked up dr_enable,
    bringup_enable and ctrl_jitter_ms_final at the top level. That file nests
    everything under a "config" key, so every lookup returned None and the DR check
    reported "dr_enable=False" for a run whose DR curriculum was in fact at 0.426.
    It now uses the cfg object load_run already built, which cannot drift from the
    file format.
    Also synced robot/deploy to the cluster so check 7 can actually run there: it was
    skipping with ModuleNotFoundError because only walk_v2/walk_v3 had been deployed,
    and a deploy-parity check that silently skips is the same failure as one that
    silently passes.
    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
    [verify.py]
2026-09-12 walk_v3: the shaping ramp is a servo, not a schedule
    A clock ramp got every cold run started and then killed it on arrival. Measured
    2026-09-13: a planar run climbed to return 345 at shape_scale 0.33 and was back at
    -101 by the time the clock reached 0.94; both free-plant runs did the same as
    their ramps passed 0.6. The penalties a policy learns under are not the ones it
    ends up paying, and the clock does not care.
    shape_scale now goes through the same retreating gate as the other curricula. The
    earlier objection to gating it -- that the gate measures exactly what these
    penalties suppress, so it is circular -- is true of a one-way gate and is the
    POINT of a retreating one: raise the bill wh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
2026-09-12 walk_v3: verify a snapshot, not a live checkpoint
    The deploy-parity check reported a 2.0 disagreement -- the maximum possible for
    two clipped actions -- between two implementations that agree to 1.8e-07. The
    cause was a race, not a bug in either: best.msgpack is rewritten by the keeper
    whenever the run improves, so load_run read one policy into memory and the
    export subprocess read a different one a minute later. Verifying a run that is
    still training is the normal case, not an abuse, so verify.py now copies the
    chosen checkpoint (and its sidecar) once at startup and every check refers to
    that snapshot.
    Two smaller fixes on the way there, both of which made the check lie rather than
    fail: P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
    [verify.py]
2026-09-12 walk_v3: retract the servo argument; the clock ramp ships
    I switched the shaping ramp from a clock to a retreating gate on the evidence
    that training return fell from 1197 to -18 as the clock reached shape_scale 1.0.
    That reading was wrong, and wrong in a way this project has a rule about: return
    is not comparable across shape_scale values, because raising the penalties lowers
    it by construction -- the same reason tools/compare_probes.py refuses to rank arms
    by return. Measured on the greedy ladder over exactly that window, the run whose
    return "collapsed" went from 0% to 60% upright and from 1.93 to 0.59 m/s of
    command error. It was improving the whole time.
    Judged on the greedy ladder ins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
    [config.py, ppo.py]
2026-09-12 walk_v3: compare runs at matched steps, or not at all
    tools/compare_runs.py replaces compare_probes.py and enforces the two rules I
    broke three times in one session while ranking these arms:
    Never compare at unequal steps. I ranked the gated shaping ramp against the clock
    ramp using the gated runs' numbers at 29 M and the clock runs' at 65 M, concluded
    the clock was better, and committed that. At matched steps the ranking reverses at
    44 M (gated 52-82% upright and 42-48% from a dirty start, clock 0-32% and 0-8%)
    and is a wash at 59 M. With two seeds per arm the honest answer is that they are
    comparable, so the default stays on the clock for being simpler and reaching full
    shaping, and the g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
2026-09-12 walk_v3: warm-start stage 2 from best.msgpack, not final
    The keeper exists because runs degrade, and stage 1's final checkpoint sits past
    its last evaluation -- all four stage-1 runs ended with training ep_len down at
    103-165 from a peak of 1013, while their last *evaluated* checkpoint was the one
    the keeper kept. Handing stage 2 the unevaluated tail of stage 1 throws away the
    only thing that measured it.
    Stage 1 result, best checkpoint, per stick position (error m/s / upright):
    v3_stage1_s1 0%: 0.32/100% 25%: 0.25/100% 50%: 0.80/100% 75%: 1.36/100% 100%: 1.88/62%
    v3_stage1g_s3 0%: 0.51/ 62% 25%: 0.14/ 88% 50%: 0.79/100% 75%: 1.47/100% 100%: 2.12/100%
    Low commands are t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
2026-09-13 walk_v3: the privilege audit needs a positive control, and now runs one
    A "nothing leaked" verdict is worthless from a test that cannot detect a leak, and
    this project published one before: an earlier audit called v3 clean while the same
    test, run on a v2 checkpoint whose clock IS contact-driven and whose task[1] IS
    ground-truth odometry, also reported clean. It was measuring nothing.
    Check 6 now moves a channel the actor legitimately DOES read -- the speed command --
    and requires a delta 100x the noise floor before any leak probe is believed.
    Measured on a stage-1 checkpoint: the control moves 2.78e-01 against a 6.02e-04
    floor, 460x, while the odometry and touchdown-estimate probes move 1.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
    [verify.py]
2026-09-13 walk_v3: stage 2 died on geometry, not balance -- give roll and yaw training wheels
    A stage-1 policy warm-started onto the free plant died in 0.38 s and stayed at 0%
    upright through 44 M steps. why_terminated says what killed it: 44 of 64 deaths to
    the WORKSPACE check, 20 to tipping, and ZERO to term_low or the floor. It was not
    falling over. It was being killed by a box.
    The workspace check is +-0.14 m of dz measured in the BASE frame, and roll spends
    that budget geometrically before the legs move at all: a foot 0.15 m off the
    centreline sits h(1-cos phi) + y*sin(phi) lower in a rolled base frame, which is
    about 0.11 m at 20 degrees against a 0.14 m limit and a 0.10 s grace. A policy
    train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
2026-09-13 walk_v3: hand the robot back to itself slowly -- the fade was the cliff
    With the inherited 30 M assist fade inside a 200 M budget, three of four stage-2
    seeds collapsed at the exact moment the wheels reached zero. One went straight
    back to the 1.5 Hz clock floor. The DR curriculum went with them, retreating from
    0.25 to 0.000 as the relative gate did its job and backed off a degrading policy
    -- so the fade did not just cost survival, it undid the randomisation too.
    The fourth seed survived it at 60% upright and 0.62 m/s of command error on the
    full ladder with the assist at zero, which says the recipe works and the handover
    is what has to be gentler. This is the same end-of-fade cliff the v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
    [config.py]
2026-09-13 walk_v3: test the other way of paying for roll -- a box that fits the plant
    All four seeds on the 30 M fade have now collapsed, including the one that had
    reached 60% upright: it is back at ep_len 149, return -37, dr_scale 0.000. So the
    training wheel is not a free win, it is a debt, and this lineage has never yet
    paid it off.
    v3_roomybox asks the question the wheels were routed around. The workspace box is
    what killed the unassisted transfer -- 44 of 64 deaths, zero to falling -- and it
    was calibrated on a plant with no roll DOF. A planted foot 0.15 m off the
    centreline moves about 0.11 m in the base frame at 20 degrees of roll, against a
    0.14 m budget with a 0.10 s grace, so body attitude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
2026-09-13 walk_v3: a roomier box is not enough on its own -- the wheels do more than dodge it
    Two seeds of v3_roomybox (dz widened by the ~0.11 m that 20 degrees of roll costs
    a planted foot, dx with it, grace tripled, NO roll or yaw assist) peaked at
    ep_len ~250 around 6 M and were back to 145-155 with negative returns by 14.7 M.
    The wheeled runs were at 600-1150 over the same window.
    So the workspace box was a contributing killer -- it accounted for 44 of 64 deaths
    in the unassisted transfer -- but it was not the whole story. The roll and yaw
    assists are doing something the box cannot: holding the two new degrees of freedom
    still long enough for the policy to learn a gait in them at all. Widening t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
2026-09-13 walk_v3: take the crutch away as a distribution, not as a dial
    Slowing the fade does not fix the handover, it postpones it. Measured: with the
    100 M fade, five seeds went from ep_len 600-1150 at 29 M down to 146-519 at 42 M
    while the assist was still at 0.64 -- degrading long before the wheel reached
    zero, exactly as the four seeds on the 30 M fade had collapsed the moment it did.
    The reason is what a scaled assist actually does. At 0.64 it still corrects 64% of
    every roll error the policy makes, on every episode, so the policy never meets its
    own mistakes and never learns an answer to them. The magnitude is smaller; the
    masking is complete. There is no value of that dial at which the polic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
    [config.py, env.py]
2026-09-13 walk_v3: a third rung that introduces roll alone
    dash01_v2_noyaw.xml is the free plant minus heading -- x, y, z, roll, pitch, nq 17
    against free's 18 and planar's 15. make_v2_model.py grows a `variant` argument and
    writes all three.
    The reasoning is in what actually kills the planar-to-free transfer. Roll is the
    degree of freedom that does it: the workspace box is measured in the BASE frame
    and roll spends most of its dz budget geometrically before the legs move, which is
    why 44 of 64 deaths were term_ws and none were falling. Yaw is the benign one --
    it costs heading drift, not terminations. Introducing both at once needs a
    training wheel, and the wheel has now failed at three fade lengths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
    [config.py]
2026-09-13 walk_v3: say plainly what is solved and what is not
    Stage 1 is solved and reproducible -- four seeds, cold, 80 M steps, tracking to
    0.14-0.32 m/s at low commands with 88-100% upright. Stage 2 is not, and the README
    and the config now say so where someone about to spend GPU hours will read it,
    with all six attempts and their measured outcomes in one table rather than spread
    across commit messages.
    The default v3 preset moves to per-episode assist, which is the best-measured
    handover of the six even though it has not closed the gap: at matched assist it
    holds ep_len 736 against 276-542 for the scaled version, and its number already
    includes the unassisted share of episodes.
    Why it still is n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
    [config.py]
2026-09-13 walk_v3: one difficulty at a time
    Every run in this session follows the same arc: climb to a peak, then decline from
    the point where the curricula start biting together. That is six of them advancing
    off one competence gate -- the command band widening, the gait-quality penalties
    coming on, the starts getting dirty, the plant randomising, the controller getting
    jittery, and the assist fading -- so the task hardens in six directions at once
    and the policy is never given a chance to consolidate any of them.
    v2 had the opposite failure: absolute gates set so high that nothing ever advanced,
    which is how dr_scale finished at 0.000 in three runs. The answer is neither
    extreme. curriculum_order n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
    [config.py, ppo.py]
2026-09-13 walk_v3: size the ramps for a queue that does not overlap
    Sequential curricula need the SUM of their ramp lengths, not the maximum. With the
    lengths inherited from the parallel design the queue came to 245 M inside a 200 M
    budget and 175 M inside 80 M -- it could never have finished, and the run would
    have ended somewhere in the middle of it with no warning beyond the queue log.
    Ramps are now sized for the sequence: 25 M command band, 30 M assist fade, 25 M
    shaping, 30 M bring-up, 40 M DR, 25 M jitter. Stage 2 runs the full nine-name
    queue, 175 M of a 200 M budget, leaving 25 M to consolidate at full difficulty.
    Stage 1 runs only the first five names -- command band, assist fade, shaping -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
    [config.py]
2026-09-13 walk_v3: the queue leaked -- clock ramps ignored it
    The first sequential run reported "now advancing 'cmd_lo'" while shape_scale
    climbed to 0.45 alongside it. shape_curriculum_gated defaults to False, so that
    curriculum takes the CLOCK branch, and _clock reads self.step -- it never saw the
    queue at all. The pitch-assist fade had the same hole on its ungated path. So the
    one thing the queue exists to guarantee, that exactly one difficulty moves at a
    time, was not true of two of the nine.
    _clock_q accumulates queued steps per curriculum instead of reading the global
    step, so a clock ramp freezes when it is not its turn and resumes where it left
    off when it is.
    This is the same class of bug a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
    [ppo.py]
2026-09-13 walk_v3: "off" has to be expressed as "queued", not as "omitted"
    A name left out of curriculum_order is not frozen -- _queued returns True for it,
    so it advances unqueued. Stage 1 listed only five names to keep the queue's
    progress count readable, and DR promptly ramped to 0.146 alongside the command
    band: exactly the several-things-at-once failure the queue was built to stop,
    reintroduced by the config that was supposed to use it.
    Both stage-1 presets now carry the full nine-name order and simply run out of
    budget partway through it. 80 M covers the command band, the assist fade and the
    shaping; bring-up, DR and jitter never start, because they are queued behind
    something a 100 M budget wi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
    [config.py]
2026-09-13 walk_v3: a queue entry may be a group
    cmd_lo, cmd_hi and cmd_zero_p are one curriculum wearing three names -- they widen
    the same command band. Queued separately they each took a full 25 M ramp, so the
    command band alone would have consumed 75 M of stage 1's 100 M budget and the
    assist fade, third in line, would never have got its turn. The run would have
    ended with a policy that had never been asked to stand on its own, which is
    precisely the deliverable.
    curriculum_order entries may now be a name or a tuple of names that advance
    together, so the queue is six groups summing to 175 M of stage 2's 200 M, and
    stage 1's first three groups are 80 M of its 100 M -- the sizes intended two
    commits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
2026-09-13 README: document the curriculum queue and the three bugs it hid
    Adds the section the rest of the folder was rebuilt around, including the group
    sizes, why sequential ramps need the sum rather than the maximum of their lengths,
    and why the assist fade sits second in the order.
    Also records the three bugs that lived inside the queue before it worked, because
    they are all the same shape as the failure this folder exists to prevent -- a
    curriculum whose real behaviour did not match its config -- and all three were
    caught only because the queue prints which curriculum is live. A reader who adds a
    curriculum later needs to know that a clock ramp bypasses the queue unless it uses
    _clock_q, that om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
2026-09-13 walk_v3: eff_scale and stance_ratio were advancing unqueued too
    Third instance of the same mistake, and the reason it keeps happening is worth
    naming: a name omitted from curriculum_order is not disabled, it advances freely,
    so the tuple has to list everything that ramps rather than everything I happened
    to be thinking about. eff_scale ramps the efficiency penalties and stance_ratio
    narrows the gait's stance window; both were moving during a stage 1 that was
    supposed to be advancing only the command band.
    They join shape_scale in the "do it well" group, which costs no extra budget
    because a group takes as long as its longest member.
    The running seeds are not restarted for this -- they are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
    [config.py]
2026-09-13 README: the queue's measured result, including where it falls short
    Stage 1 with the assist faded to zero: 0.45-2.63 m/s of command error, 22-60%
    upright, 30-35% from a dirty start, across three seeds that all survived the
    handover where every earlier configuration read 0%. Stage 2 on the free plant at
    59 M: one seed at 0.66 m/s and 28% upright, the first free-plant policy here to
    stand unassisted, with three others still at 0%.
    Both shortfalls are written down rather than smoothed over. 28% upright is not the
    90% the contract asks for, and one seed in four is not a recipe. And the queue
    oscillates: the gates retreat, so a drop in episode length after a fade pushes the
    command curricula bac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
2026-09-13 verify: straightness is not testable on a plant with no yaw joint
    The final stage-1 report showed "heading drift at full stick: 0.0 deg PASS" on the
    planar model, which has no yaw DOF. It would have read 0.0 for any policy, however
    bad -- the same empty pass this suite already removes for command error and
    lateral drift when nothing survived to be measured.
    Checks 3 now SKIP with the reason on planar and no-yaw models rather than passing
    on a degree of freedom the plant does not have. Straightness is a stage-2 property
    and is only meaningful there.
    Stage 1 final, v3_seq_s3 at 100 M, greedy with the assist at zero:
    stick commanded achieved err upright
    0% 0.00 0.30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
    [verify.py]
2026-09-13 v3: stage 3, the rest of the curriculum queue
    All five 200 M stage-2 seeds finished with bringup_scale 0.00-0.31 and
    dr_scale 0.000. The joystick works (0.31-0.55 m/s error, 60-80% upright
    from a settled start) but the queue only got three groups deep, and the
    two it never reached are the two the deliverable is specified on: being
    droppable, and running on a plant that is not the nominal one.
    Stage 3 buys the last three groups from the stage-2 keeper. The first
    three are PINNED AT FINAL rather than dropped from curriculum_order --
    a name omitted from that tuple is not frozen, it advances unqueued from
    its start value, which would re-open the command band and re-fade an
    assist that is alread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
    [config.py]
2026-09-13 v3: stop refilling the action noise on a same-task warm start
    Three findings from the first stage-3 attempt and the first full verify
    of a stage-2 keeper.
    1. THE WARM START, NOT THE TASK. Four stage-3 seeds warm-started from a
    policy at ep_len 1413 and fell to 120-241 within 13 M steps, one onto
    the 1.5 Hz clock floor -- on an env strictly easier than the one the
    checkpoint came from, since bringup_scale starts at zero. The parent
    had annealed to std_mean 0.17; warmstart_reset_log_std refills log_std
    to max_log_std, which is std 0.70. Four times the action noise on a
    policy at its stability edge. Stage 3 keeps the parent's log_std and
    caps it at ln(0.25). This is very l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
    [config.py, verify.py]
2026-09-13 v3: an honest top of the stick, and a heading readout on the panel
    tools/speed_frontier.py on the stage-2 keeper, greedy, 8 envs/rung:
    commanded 1.80 2.10 2.40 2.70 3.00 3.30 3.60
    achieved 1.64 1.82 1.98 2.16 2.50 2.64 2.79
    upright 100% 100% 100% 100% 25% 0% 0%
    heading 8.0 6.4 6.7 5.8 10.5 13.7 17.5 deg
    v_max = 3.6 came from speed_lib, an open-loop CEM search over gait specs,
    which answers what the ACTION SPACE can express and not what a policy can
    hold. Closed loop the cliff is at 3.0. So the top third of the shipped
    slider is a speed the robot falls over at -- and, less obviously, cmd_hi
    reaches 1.0, so about a fifth of every sta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
2026-09-13 v3: the warm-start variance floor was destroying the warm start
    Stage 3 warm-started four seeds from a policy holding 100% upright to
    2.70 m/s and they fell to ep_len 82 within 3 M steps, on an env strictly
    easier than the one the checkpoint came from and at the parent's own
    action noise. The env was not the difference -- every EnvParams field
    matches except bringup_scale, which starts LOWER. The obs statistics were.
    tools/speed_frontier.py --warm-start applies the surgery a warm start
    applies and re-runs the ladder. Same weights, same plant, greedy:
    floor 0.01 no floor
    1.80 m/s commanded 0% upright 100% upright
    achieved 2.08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
    [config.py]
2026-09-13 v3: README -- stage 2 is solved, and what stage 3 is for
    Rewrites "Where this stands" around the five 200 M stage-2 seeds (0.34 m/s
    error at 80% upright on the best), the two measurements that changed the
    recipe (the warm-start variance floor, and the top of the stick asking for
    a fall), and the two items still open (queue oscillation, seed variance).
2026-09-13 v3: score bring-up on the envelope a person can actually produce
    verify's bring-up check ran at bringup_scale 1.0 -- a 5-10 cm drop with
    the base at +-20 deg of pitch. That is a training target, not an operator.
    Measured on the real robot, the bring-up a person can produce is upright
    to 5 deg BACK with both feet flat after a >=1 s hold; +5 deg FORWARD was
    16/16 floor violations and any roll lifted a foot. Scoring the contract at
    the full trained width asks the policy to survive something the hardware
    bring-up will never do, so a FAIL there says nothing about whether the
    robot can be let go.
    The PASS now sits on bringup_operator_scale (0.25 => ~+-6.5 deg, 2-3 cm),
    a little wider than the mea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
    [config.py, verify.py]
2026-09-13 v3: README -- the recipe is three stages
    Stage 3 is not optional and the front of the file said it was. Documents
    the three train commands, why each stage is separate, and the four ways a
    run gets wasted -- including the new one: check a parent THROUGH the warm
    start (speed_frontier --warm-start), not as it was saved.
2026-09-13 deploy: tests for the heading readout and the re-aim command
    Three tests: a v3 bundle publishes has_heading and the policy's own
    bearing; zero_heading moves the origin across the HTTP/CAN boundary the
    way the slider does, without ending the run or touching the command; and a
    v2 bundle refuses loudly rather than doing nothing quietly, because the
    operator pressed a button expecting the robot to be re-aimed.
    71 policy tests pass.
2026-09-13 v3: the curriculum queue no longer waits forever
    Every ramp in the queue is competence-gated and retreats, so a group can
    hover below the 0.99 completion threshold indefinitely and starve every
    group behind it. That is how all five 200 M stage-2 seeds finished with
    dr_scale at 0.000: the three groups ahead of it never all completed at the
    same time, and nothing in the design said they had to hurry.
    curriculum_group_max_steps bounds how long one group may hold the queue.
    It keeps whatever progress it reached and the next group starts anyway --
    a partly-open curriculum the policy has absorbed beats a fully-open one it
    never reached. 0 (the default) is the old behaviour; both stage-3 presets
    s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
    [config.py, ppo.py, smoke_test.py]
2026-09-13 v3: the in-training eval runs 64 envs, not 16
    The eval scores a COMMAND LADDER, so 16 envs is about 3 per rung and
    "upright" can only take the values 0 / 33 / 67 / 100%. That is what made a
    stage-3 seed look like it was oscillating between 0% and 62% upright when
    it was mostly being measured badly -- and it is not cosmetic, because
    keeper_score picks best.msgpack off exactly this number.
    The eval loop is a while_loop that exits as soon as every env has ended,
    so the extra envs ride the same vmapped step and cost almost nothing.
2026-09-13 v3: re-rank a finished run's checkpoints on an honest ladder
    best.msgpack is picked during training by keeper_score, off an eval that
    ran 16 envs across a five-rung ladder -- three per rung, so "upright" can
    only read 0/33/67/100%. Raising the default fixes new runs; this fixes the
    ones already on disk. Same ladder, same keeper weighting, more envs, and
    --write-best installs the winner as the file export.py and the next
    stage's warm start both read.
    The env and the jitted rollout are built once and the parameters swapped
    per checkpoint, so it costs one compile plus one rollout each.
2026-09-13 v3: stop spending 60% of stage 3 on the first half-second
    At full bringup_scale the stock shares put 25% of episodes on a free drop
    and 35% on a held release. That is 60% of every rollout starting dirty,
    and almost all of them end in the 100-point fall penalty.
    Measured: three stage-3 seeds went from 50-62% upright at 29 M to 0-6% at
    44 M as bring-up opened. That eval starts from the SETTLED keyframe, so
    what the runs lost is the cruise, not the bring-up -- the policy was being
    priced into being a bring-up specialist.
    Bring-up is a transient the robot performs once per run; cruising is what
    it does for the other 99% of the time. 10% drop / 25% held keeps a clear
    majority of episodes on the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
2026-09-13 v3: the bring-up ramp needs a target, not just a rate
    Three stage-3 seeds read 0.15-0.29 m/s error at 98-100% upright at 14.7 M
    -- the contract met -- and were at instant death by 29.5 M. The trace says
    what happened: bringup_scale climbed to 0.30, the competence gate then
    correctly retreated it all the way back to 0.000, and at 40 M with
    bring-up fully off again ep_len was still ~100 and the return still -100,
    with residual saturation decayed 0.17 -> 0.02.
    So the retreat does not undo the damage. A curriculum that can destroy the
    policy faster than it can learn is not saved by backing off afterwards; it
    has to be gentle enough never to do it.
    bringup_target caps the width of the ramp. Sta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
    [config.py, ppo.py, train.py, verify.py]
2026-09-13 v3: README -- the keeper's pick, the speed/robustness frontier, and DR
    Three things measured after the stage-2 runs finished:
    The keeper kept the wrong checkpoint in both runs. Its eval ran 16 envs
    over a five-rung ladder, so upright could only read 0/33/67/100%.
    Re-scored at 12 per rung, v3_q_s2's ckpt_150405120 is 93% upright against
    best.msgpack's 80% with 0% at full stick.
    Speed and robustness are a frontier, not a ranking: that checkpoint tops
    out at 2.14 m/s and holds 100% upright to 3.30 commanded, while the
    keeper's pick runs 2.81 and falls above 3.0. A frontier measured on one
    checkpoint is not a statement about the run -- which is a caveat on how
    v_max 2.4 was chosen, though the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
2026-09-13 v3: warm up the step size, or Adam's first update wrecks the warm start
    THE bug behind every collapsing stage handover in this lineage.
    Adam starts with zero moments, so its very first step is ~lr on EVERY
    parameter at once: after bias correction m-hat/sqrt(v-hat) is about +-1
    everywhere, which is a coordinated move of the whole network. A random
    policy does not care. A converged one that a warm start has just loaded is
    destroyed by it, and target_kl cannot help -- the early stop is checked
    AFTER a minibatch, so the damage is already in the weights.
    Measured, first update of a stage-3 run, same checkpoint, same env:
    without warmup approx_kl 0.9332 (target_kl is 0.03)
    with w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
    [config.py, ppo.py]
2026-09-13 walk_v2: commit the tools the v3 work leaned on
    speed_lib.py (the open-loop CEM search over gait specs per target speed),
    gait_shape.py and gait_figures.py, plus the bringup_probe and limits_check
    edits. walk_v3/config.py cites speed_lib by name when explaining where
    v_max came from, so it needs to be in the repo to be checkable.
    Binary results (mp4, png, json traces) stay out of the tree.
2026-09-13 v3: the held bring-up was feeding PPO 250 dead ticks per episode
    A bring-up share of 8% at +-6 degrees of tilt was destroying a policy that
    had been at 81% upright. That is far too small a perturbation, and it was
    never the tilt.
    While a held start is held, env.py pins every base DOF -- x, y, z, roll,
    pitch and yaw -- and zeroes every base velocity at each 1 kHz substep. So
    the robot is commanded, say, 2.4 m/s, achieves exactly 0, earns
    exp(-2.4/0.6) = 1.8% of the tracking income, and nothing it does can
    change any of it. At the stock bringup_hold_s of 0.3-2.5 s that is up to
    250 control ticks per episode of uncontrollable, low-reward transitions
    entering the PPO batch as ordinary ones -- o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
    [config.py]
2026-09-13 verify: the positive control's bar was unreachable on the free plant
    The privilege audit swings the speed command rail to rail, which moves the
    actor observation by exactly 1.0, and required that to exceed 100x the
    re-run noise floor. On the free plant the floor puts 100x at 1.87 -- above
    the largest delta the channel can produce -- so the check could only ever
    SKIP, and with it the two leak probes it licenses.
    `floor` is already the threshold a leak must stay under. What the positive
    control has to establish is that the probe resolves a channel-sized effect
    comfortably above that threshold: an order of magnitude of headroom, not
    two. At 20x a leak twenty times smaller than the command chan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
    [verify.py]
2026-09-13 v3: README -- the held bring-up's dead ticks
    Second of the two "uncontrollable transitions poison the batch" bugs, and
    the one that survived the optimizer fix. Documents the mechanism, the
    measurement (ep_len 74-400 / return -100 with the stock hold, 566-1136 /
    +211..+543 with the short one, nothing else changed), and the general test
    worth applying to any clamp or grace window: could the policy have changed
    this outcome?
2026-09-13 v3: play_joystick --headless, the last independent check
    verify.py proves the exported numpy actor agrees with the JAX one on
    identical observations. This runs the WHOLE shipping law -- gait
    reconstruction, latch, clock, heading integrator, PD torque envelope --
    against a different physics backend (CPU MuJoCo, not MJX) and asks whether
    the robot walks. No JAX, so it runs on a laptop and on the Pi's own numpy.
    It prints BOTH heading statistics, because they answer different questions
    and I confused them once already: the MEAN |yaw| is what the trainer's
    eval and verify report (how far off straight it sits on average), the
    FINAL yaw is where it ended up. For a steady drift the final is about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
2026-09-14 v3: buy DR without bring-up, and hold the base where it was placed
    Five structural fixes later -- the warm-start variance floor, the log_std
    refill, Adam's first step, the held-start dead ticks, the queue deadline --
    every stage-3 seed still reaches 0.27-0.43 m/s of error at 61-92% upright
    by 15 M and then falls off a cliff between 30 M and 59 M and never
    returns. The cliff is sharp: reward_mean +0.42 -> -3.81 across four
    rollouts, 1381 of 1381 episodes falling at ep_len 103, arriving when
    bringup_scale is about 0.34 (+-8 deg on 12% of episodes).
    It is NOT the objective. tools/reward_budget.py on the parent under this
    exact preset: income 4.36, cost 2.05, LIVING +1.157/tick at curriculum
    st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
    [config.py, env.py]
2026-09-16 result, cealning the repo now
    [CamLeftNCS-v1.stl, CamRightNCS-v1.stl, FootFlatLeftNCS-v1.stl, FootFlatRightNCS-v1.stl, HipLeftNCS-v1.stl, HipRightNCS-v1.stl, PushrodLeftNCS-v1.stl, PushrodRightNCS-v1.stl]
2026-09-16 dash01: build the flat-foot plant from the CAD, and prove it stands
    The new CAD replaces the shin, ankle and foot with one rigid leg/foot part
    ending in a flat pad. Everything else is bit-identical to the previous plant
    and this checks that rather than assuming it: centres of mass agree to
    0.0000 mm, inertia tensors normalised by mass to a ratio of exactly 1.000,
    frame origins to 0.0000 mm, joint axes to 2e-5 deg. The frame ORIENTATIONS
    that differ are all pure rotations about each body's own joint axis --
    off-axis residual 0.000000 deg -- which is what a pose difference looks like
    and is the proof that no geometry moved. ZERO_SHIFT rotates them back onto
    the robot's homing convention so the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
    [make_plant.py]
2026-09-16 Remove the legacy stacks: keep the Pi, the CAD and the new plant
    Four trees remain: robot/ (the Raspberry Pi runtime, web UI and deploy
    bundle), Dash-01CAD/ (the CAD export and meshes), dash01/ (the new plant), and
    walk_v4/ for now -- see below.
    Deleted: training/, walk_mit/, walk_v2/, walk_v3/, leg2d/, old_runs/,
    eval_videos/, and the top-level results/ and tools/. Every one of them belongs
    to a lineage that the flat-foot robot invalidates: they are built on a plant
    whose shin, ankle and foot no longer exist, and nothing in them loads against
    the new model. They remain in history.
    Two things were carried across rather than dropped, because they are current
    work about the Pi rather than ab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
    [CamLeftNCS-v1.stl, CamRightNCS-v1.stl, FootLeftNCS-v1.stl, FootRightNCS-v1.stl, HipLeftNCS-v1.stl, HipRightNCS-v1.stl, LegLeftNCS-v1.stl, LegRightNCS-v1.stl]
2026-09-16 Rename the three trees to say what they are
    robot/ -> controller/ the software that runs ON the robot:
    the Pi runtime, the numpy control law,
    the safety governor, the web UI, the
    sys-ID tools
    dash01/ -> RLframework/ the simulation and learning side: the
    plant built from the CAD, and the
    training code once it is ported
    walk_v4/ -> legacy_trainer_to_port/ the previous trainer, present only as
    the source for that port
    Pa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
    [CamLeft.iam, CamLeftNCS-v1.stl, CamLeftNCS.iam, CamLeftNCS.ipt, CamLeftNCS.stp, CamRight.iam, CamRightNCS-v1.stl, CamRightNCS.iam]
2026-09-16 Drop the unreferenced CAD export formats; repair the rename damage
    robotCADdescription carried the same robot in nine formats. Six of them --
    MJCF_CLOSED_MUJOCO, MJCF_OPEN_MUJOCO_A, SDF_CLOSED_GAZEBO and the three URDF
    trees -- are referenced by nothing in the repo, so they go: 159 MB -> 66 MB.
    What stays, and why it is not simply replaced by Dash-01CAD:
    CAD/ Inventor and STEP source. Nine of the eleven parts were
    NOT touched by the rebuild (torso, both hips, both cams,
    both pushrods, both thighs -- verified bit-identical), so
    this is still the editable source for most of the robot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
    [CamLeftNCS-v1.stl, CamRightNCS-v1.stl, FootLeftNCS-v1.stl, FootRightNCS-v1.stl, HipLeftNCS-v1.stl, HipRightNCS-v1.stl, LegLeftNCS-v1.stl, LegRightNCS-v1.stl]
2026-09-16 RLframework: the nominal is a COMMAND, and the drives are stiff enough
    Holding the stance with the command pinned at the nominal pose takes kp 2000.
    The drives cannot do that and never could: the MIT CAN frame encodes kp in 12
    bits over 0..500 N*m/rad (controller/deploy/mit.py) and the safety governor
    clamps to the same, so 500 is the ceiling, and drive_kp 200 times the
    impedance schedule's 2.5 already reaches exactly it.
    That reading was the wrong measurement rather than a wall. A position loop
    only makes torque from error, so commanding the pose the robot should settle
    into leaves it with none. Offset the command by the 2 degrees that generates
    the gravity hold and the same plant stands a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
    [make_plant.py]
2026-09-16 RLframework: the training stack, ported onto the flat-foot robot
    The stack from the previous generation, adapted to the new plant and stripped
    of what the flat foot made unnecessary. smoke_test.py: ALL OK.
    WHAT THE FLAT FOOT REMOVED
    The 6-DOF base spring is gone -- config, env, curriculum gate, reward term and
    tests. It existed because the previous robot was a point-foot machine whose
    centre of mass sat 87 mm behind its toe contacts: standing still was never an
    equilibrium, so something had to hold the torso up while the policy learned to
    balance. This robot stands on its own feet. Bring-up goes with it, and so does
    the leg series spring and its domain-randomisation axis: the merged rigid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
2026-09-16 RLframework: the CAD folder is dash-01CAD, and Linux says so
    The generated plants referenced ../../Dash-01CAD. Windows does not care and the
    model compiled here; the cluster is case-sensitive and would have failed to
    find a single mesh, on the node, after the job had queued.
    [make_plant.py]
2026-09-16 smoke: the clock-wrap check was luck, not a measurement
    It drove the env with random actions for 80 ticks and asked whether a commit
    landed. The robot thrashes itself over in about a dozen ticks under random
    actions and the cadence needs 36 to wrap, so whether the check passed depended
    on the seed and the machine: it passed here and failed on Izar, on the same
    commit.
    Now it drives ZERO actions on the nominal plant, which is the neutral gait at
    the middle of the cadence band, so the wrap is due on a known tick.
    [smoke_test.py]
2026-09-17 The cross-implementation trace fixture ships with the repo
    The four tests that prove the Pi's numpy control law matches the trainer
    tick-for-tick read a recorded trace. It lived in the old trainer's results/,
    which is gitignored -- so it existed on one laptop and nowhere else, and those
    four tests silently skipped on every fresh clone, including the cluster.
    Recorded from RLframework now, into a tracked directory. 60 ticks, matching the
    previous fixture: the tolerance is an absolute bound on accumulated float32
    phase, so a 300-tick trace fails it at 1.4e-05 without anything being wrong.
    controller/deploy: 135 passed, 1 skipped.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
    [bundle.py, controller_v2.py, gait_v2.py]
2026-09-17 The curriculum queue let two ramps run at once, and DR started from zero
    dash_s0/s1/s2 each climbed to ep_len ~2300 and then collapsed to ~45 within
    10 M steps, spending the last 320 M of a 450 M budget falling over with the
    cadence parked on a rail. Two causes, both in the curriculum.
    DR RAN FROM EXACTLY ZERO. dr_scale is third in the queue, so it sat at 0.000
    for the first 119 M steps: the policy converged not merely on an easy plant
    but on a DETERMINISTIC one -- same masses, same gains, same friction, every
    episode. The collapse begins within 1 M steps of dr_scale first becoming
    nonzero and tracks the ramp: 2376 -> 1829 -> 1079 -> 559. The dose that did
    it was 0.088, i.e. mass +-1.1%, kp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
2026-09-17 The flat sole is the zero reference, so stop randomising homing error
    dr_joint_zero_deg goes to 0 for dash. Homing error was randomised because the
    previous robot had no mechanical zero reference: it stood on point feet, so
    nothing about a pose on the floor pinned the leg angles, and the drift was
    large in practice -- deploy_map needed a re-fit of cam -9.0 deg, thigh +4.0.
    The flat sole replaces that. Stood on a flat floor the sole IS the reference,
    so the zero is measured rather than guessed and there is no residual
    distribution left to train over.
    It is the right thing to drop first on its own merits. joint_zero is a
    per-episode SYSTEMATIC bias on all six joints, applied to BOTH sides of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
    [config.py, smoke_test.py]
2026-09-17 The DR floor randomises the plant; it does not start the pushes
    dr_scale_start exists to stop the policy converging on a DETERMINISTIC plant
    -- one set of masses, gains and friction -- because that is what left the last
    campaign with no margin to spend when DR finally arrived. Pushes, trips and
    wind are a different difficulty, and `adv = params.dr_scale` read them straight
    off the same knob, so the floor switched the disturbances on at step 0 too.
    Measured, three runs at matched steps (ep_len, cadence):
    4 M 8 M 14 M
    dr=0 113 146 175 cadence off the rail at 8 M (2.98 Hz)
    floor 65 71 84 cadence pinned at 1.50 Hz throughout
    With the flo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
2026-09-17 Survival is free now, so stop paying for it: w_alive 0, 200 M budget
    The alive bonus existed because the previous robot could not stand -- its CoM
    sat 87 mm behind its toe contacts, so staying upright was itself the hard part
    and had to be subsidised. The flat foot removed that problem: released with the
    motors merely holding the nominal command, this robot settles 1.8 mm and stays.
    The subsidy outlived its reason, and the first campaign collected it -- 450 M
    steps x 3 seeds produced a policy that stands at 0.31 m/s at ANY command,
    64/64 upright, command_sweep FAIL at 92% of v_max.
    Measured, per tick:
    kernel speed-inc income
    standing 0.31 m/s 0.419 0.232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
    [config.py]
2026-09-17 Revert w_alive to 1.5: it is the balance signal, not a subsidy
    Measured on Jed with tools/reward_budget.py --cold, which is the gate this
    change should have waited for:
    COLD, curriculum start, w_alive 0
    INCOME 0.0513 COST -1.4223 LIVING -0.5000 /tick (at the floor)
    w_alive for LIVING>0 1.3710
    "living on is worth -100.0 against -100 for dying now" <- an exact tie
    A cold policy earns 0.05/tick. Without the alive term LIVING clamps to the
    step floor and there is NO gradient to stay upright at all. 1.5 sits just
    above the 1.371 threshold; it was not an arbitrary number.
    Training agreed. Three seeds at w_alive 0, 200 M steps each:
    alive_frac 0.19 / 0.30 / 0.0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
    [config.py]
2026-09-17 Price out the standing basin: speed income, fewer stops, and wean the bonus
    Three levers at the basin the first campaign settled into (0.31 m/s at ANY
    command), none of them touching the balance signal, plus a second preset whose
    objective cannot express standing at all.
    w_alive becomes a CURRICULUM (EnvParams.alive_scale). It has two jobs that pull
    opposite ways: early it is the only reachable reward, since a cold policy earns
    0.051/tick and without it LIVING clamps to the step floor and living ties with
    dying; late it is a flat subsidy worth 121% of a stander's whole income and 21%
    of a walker's. So it holds full weight while balance is learned and is then
    weaned. An offset CLOCK, not a c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
2026-09-17 dash_sprint starts at w_alive 2.25: linear income is signed, so cold costs more
    A cold policy drifts backwards and the sprint's income is linear and SIGNED, so
    its cold cost is 2.05/tick against the joystick's 1.42. At w_alive 1.5 that puts
    LIVING at -0.250/tick -- the same figure cold-start-shaping-tax records as the
    point where dying won. reward_budget names the threshold directly (w_alive for
    LIVING>0: 2.0); 2.25 clears it with margin (+0.125 rather than +0.0002).
    Safe here in a way it would not be under the joystick kernel: standing earns
    exactly zero under linear income, so a bigger bonus cannot buy a standing basin.
    It weans to 0.56 with everything else.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
    [config.py]
2026-09-18 The loop-site jitter is in-plane only, and the joystick ramps are clocks
    Measured 2026-09-18 on every keeper of the 200 M campaign: the exploring policy's
    ep_len_mean never left 70-240 ticks while the greedy keepers survive 30 s. Leave-one-out
    over the training env and leave-one-in over all twelve DR widths named one term:
    dr_loop_site_m. Every leg joint is a hinge about y, so a LATERAL offset between rod_tip
    and leg_anchor cannot be closed by any joint motion; the 2 ms connect constraint fights
    a 0.225 mm error at 133 kN (x/z: 200-290 N) and under MJX's 8 Newton iterations the
    foot leaves the workspace box at a median 0.8 s. MJX axis split at dr_scale 0.15:
    xz-only 28/32 survive (= no jitte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
    [config.py, plant.py]
2026-09-18 dash_joy: the joystick for a clean day
    dash_speed_v2 (three seeds, the first campaign on the repaired plant) learned to walk and
    track -- training episodes 470-590 ticks against the old ceiling of 240, greedy ladder 20-47%
    upright at 0.8 m/s error by 59-74 M -- and was then destroyed by the DR clock I gave it:
    dr_scale went 0.15 -> 1.0 over 64.8-105 M whatever the policy was doing. All three seeds
    peaked within 3 M of that start, lost half their episode length by dr 0.33-0.42 and ended
    64/64 falls.
    Leave-one-in on the 73.7 M keeper (cmd 1 m/s, dr 0.47, 32 envs x 6 s, baseline 23/32):
    constant wind alone 2/32; every other term 17-24/32 (gravity tilt 17, kv 19, the rest
    20-24, in-plane loop s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
    [config.py, env.py, ppo.py, smoke_test.py, verify.py]
2026-09-18 dash_joy_stand: at zero stick the robot is paid to stand in the stable stance
    A zero command has always meant "step in place": the joystick objective forced the gait
    block on at every command, because the previous robot had no passive stance. On the flat
    foot that is a fine for standing still -- measured in the env, dash_joy at zero stick bills
    phase_contact -0.92/tick for feet that are on the ground -- and the v2 keeper duly creeps at
    0.59 m/s with the stick at zero.
    Switching the policy off instead does not work. Shipping control law, CPU MuJoCo,
    dash_speed_v2_s1 73.7 M bundle: blending the policy command into the fixed stand PD fell in
    135/135 hand-overs (3 speeds x 3 brake times x 3 ble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
    [config.py, env.py, smoke_test.py]
2026-09-19 dash_joy2: a stick the robot can obey, and a STOP the policy learns
    Measured 2026-09-19 on dash_joy_s0 through the shipping law with the 12 ms delay: asked
    0/1/2/3/4 m/s it does 1.03/1.44/1.55/1.65/1.75 -- one gait at every stick, 8 steps/s (the 4 Hz
    stride ceiling, a physical limit that stays) with ~13 cm steps. Not torque-, speed- or
    amplitude-limited. Two causes, both in the task:
    * The stick asked for the impossible. Leg reach with the sole within 5 deg of flat is
    0.24-0.29 m at stance height (classic MuJoCo, base clamped, 29x29 cam x thigh); at 4 Hz that
    is ~2.2-2.4 m/s walking. Commands of 3-4 m/s were 40% of the ladder and half the draws.
    v_max 4.0 -> 2.5.
    * The low e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
2026-09-19 dash_joy3: STOP gets a far field, the pacing survives a blown-up env, living stays positive
    Measured on the dash_joy2 campaign (jobs 3181154-56):
    - dash_joy2_s1 @ 88 M is the first policy that obeys the stick: 0.22-1.87 m/s for
    0.31-2.19 asked, 5/5 upright over 20 s up to 1.88 m/s on the deployment sim.
    - STOP only slowed it, and less the faster it went (0.55 -> 0.11 m/s at 25 % stick,
    1.56 -> 1.24 at 75 %): the Laplace kernel is flat far from zero. w_stop_speed is the
    mirror of w_speed_income on STOP ticks.
    - rollout/track_err_ema went NaN at rollout 6 in every seed (a few envs blow up
    numerically), so the command band crawled at the slow rate and the group cap closed it
    at 78 % s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
    [config.py, env.py, ppo.py, smoke_test.py]
2026-09-19 lr_kl_adaptive: the step size follows the KL early stop (and actually reaches the optimizer)
    dash_joy2 measured: once the std anneal takes std 0.65 -> 0.22 at an almost unchanged lr,
    the KL early stop trips on 85 % of updates (41 % before), the median update shrinks from
    36 minibatches to 14, and every collapse sits on a KL spike (s1 destroyed for good by one
    update at 116 M, approx_kl 0.137).
    The old switch was rl_games' rule on the mean KL. Replayed on that log it would have shrunk
    on 0.4 % of late rollouts and grown on 33 % of early ones: the early stop keeps the mean
    under its threshold. New rule: an update cut before half its minibatches shrinks lr by
    1.25, a complete one grows it by 1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
2026-09-21 webui: digital twin of the homing-pose MJCF replaces the 2D leg-linkage view
    The dashboard now renders dash-01CAD/homing/SpiderBotInitPos in the browser (WebGL, no libraries)
    and poses it live from the six motors, so backdriving the robot moves the twin. The drives are
    zeroed in that pose, so qpos = sign * normalized deg with no offsets; the signs are derived from
    the calibration wizard's convention and the MJCF axes (L abd/cam/thigh +1/+1/-1, R -1/-1/+1) and
    re-derived from the published XML in tests/test_twinmap.py. Overridable per joint in the panel
    (data/twin_map.json, display only, /api/twin/map).
    The four-bar is closed in closed form on the CAD's assembly branch: homing sits 5 mm from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
    [CamLeftNCS-v1.stl, CamRightNCS-v1.stl, FootFlatLeftNCS-v1.stl, FootFlatRightNCS-v1.stl, HipLeftNCS-v1.stl, HipRightNCS-v1.stl, PushrodLeftNCS-v1.stl, PushrodRightNCS-v1.stl]
2026-09-21 results: dash_joy / dash_joy2 / dash_joy3 bundles, ladder videos and training curves
    Policy bundles exported for the Pi (dash_joy*, dash_speed_v2_s1_73M), the per-run ladder videos,
    campaign curves and the foot-workspace comparison.
    [dash_s0.csv, dash_s0_eval.csv, dash_s1.csv, dash_s1_eval.csv, dash_s2.csv, dash_s2_eval.csv, dash_speed_s0.csv, dash_speed_s0_eval.csv]
2026-09-21 webui: Home drives to the standing pose instead of the zero pose
    Home now slews to STAND_POSE_DEG = cam +46.0, thigh +11.1, abd 0 on both legs (normalized, zero =
    the homing pose): soles flat, torso level, whole-robot CoM straight over the two sole centres, so
    the robot balances statically. tools/solve_stand_pose.py derives it from the homing CAD (twin
    kinematics, pin at 389 mm, closed-form loop) with the RL plant's measured masses; hip 837 mm above
    the sole, matching the RL `stand` keyframe (838 mm; cam/thigh within 0.5 deg in RL coordinates).
    The sole is only +-33 mm long and 3 deg of cam+thigh zero error moves the CoM 31-48 mm, so the pose
    is only as good as the zero. The FK-LUT band net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
    [daemon.py, solve_stand_pose.py, test_stand_pose.py]
2026-09-21 webui: Balance mode, an IMU loop around the standing pose, tested in MuJoCo first
    balance.py (pure numpy, the same object in the daemon and the simulator): pitch P+D shift the CoM
    along the soles, pitch I levels the torso through a feet-flat torso-pitch posture, roll P+D shift
    the CoM sideways through a parallelogram of the two hip-roll joints. The posture maps are derived
    on the homing CAD (tools/solve_stand_pose.py balance_maps, pinned by tests): per mm of CoM forward
    cam -0.105 / thigh -0.183 deg, per deg of torso pitch cam +1.216 / thigh +0.999 deg, 13.8 mm of CoM
    per deg of abduction. Differential leg length is not used: 5 mm from the four-bar's full stretch a
    longer leg is mostly a foo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
2026-09-21 webui: gyro calibration by a four-tilt sequence, noise recorder, IMU attitude on the twin
    - Axes from forward / left / right / back tilts, auto-captured while the operator holds the
    robot; pairs cross-check, a self-contradicting pair is left out, a mirror is shown as a
    conflict (Balance refused) instead of averaged; flip buttons per pair
    - Zero gyro moved into the calibration steps
    - Lever-arm compensation removed (never configured on the robot)
    - Record-while-still noise analysis (imunoise.py, shared with tools/imu_bench.py)
    - Twin base tilts by the IMU pitch/roll about the torso origin, fixed world marker
    - Old single-tilt mount files migrate as a forward tilt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
    [daemon.py, imu_bench.py, imunoise.py, mountcal.py, sensehat.py, server.py, test_mountcal.py]
2026-09-21 webui: Balance CoM trims to +-100 mm; the loop's own authority is clipped around the trim
2026-09-21 webui: Balance gains tunable live from the UI; CoM trims shape the standing pose (Home + hold) without the loop, +-25 mm with step buttons; trims/gains saved
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2026-09-21 deploy_map: re-fitted on the robot 2026-09-21, right leg mirrored
    POST /api/fk/verify on the Pi's recorded workspace: decisive on both legs (coverage 1.000
    against <= 0.84 for every other sign pair). left cam +1/-25.9 thigh -1/-10.8, right (in the
    left leg's frame) cam +1/-28.1 thigh -1/-14.4 -> mirrored by make_deploy_map into
    right cam -1/+28.1 thigh +1/+14.4. The 2026-08-29 offsets had drifted by up to 9.6 deg.
    Checked offline on the Pi with the dashboard's own validator, nothing commanded: the
    dash_joy3 stance maps to left cam +39.1 / thigh -4.1 and right cam +40.6 / thigh -7.3
    normalized degrees, both INSIDE the recorded safe workspace (unmirrored the right knee was
    outside). Still to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
2026-09-22 run_policy --mock: a dry run lifts the hardware guards itself and reports what it bypassed
    The panel's Rehearse button runs run_policy.py --mock with no acknowledgement flags, and
    that died in setup on the placeholder thermal fit for every bundle. A dry run energises
    nothing, so on --mock the thermal, joint-map and calibration guards are lifted automatically,
    each lift is recorded, and the run ends with a summary: verdict, control-law ticks reached,
    exit reason, and the list of what was bypassed that a real run still requires. Real runs
    are unchanged: the flags are still required and the refusals still fire.
    Also: reaching --max-seconds is the planned end of a run, not a failure (every rehe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
    [run_policy.py, test_policy_api.py]
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2026-09-22 dashboard: a CoM-trim click is no longer undone by the state poll already in flight
    The trim sliders were rewritten from the daemon's stored trim on every 500 ms
    state poll unless they were the focused element. The ◀ ▶ step buttons take the
    focus, so a click showed +1 mm, the poll that was already in flight (carrying the
    old trim) snapped it back inside the 120 ms send debounce, and the OLD value is
    what got posted: the click did nothing. Reproduced by replaying the panel in node
    against a fake DOM (posted 0 for a click to +1); over the laggy hotspot link
    several stale polls per click made it near-certain.
    An edited trim is now dirty until the daemon has answered that edit and a poll
    ec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
2026-09-22 blackbox: the tick record carries the IMU (pitch, roll, gyro, sample age)
    The 2026-09-22 balance fall could only be read by inverting the motor commands
    through the loop's law, because the record had no attitude. Record version 2
    appends a 6-wide float32 "imu" block (body pitch/roll deg from
    balance.attitude_from_up, gyro deg/s, sample age s), NaN without a Sense HAT;
    a 54-float row from a caller without the block is accepted with NaN.
    Files declare their layout in the header, and read_segment now builds the
    dtype from it (record_dtype_of), so the 212-byte version-1 files still read
    aligned and simply have no "imu" column; the sample counts in the listing and
    the reader tool use the file's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
    [blackbox.py, blackbox_read.py, daemon.py, test_blackbox.py]
2026-09-23 webui: a restart no longer demands a re-zero, and the workspace canvas grows
    Two faults reported from the robot on 2026-09-23.
    THE RE-ZERO. The pre-move guard's raw-at-rest check compared live pos_raw
    against Calibration.zero_raw -- the pose captured at the zero capture and
    never updated since -- so what it really asked was "is the robot standing in
    its zero pose?". That stops being the same question as "did an encoder origin
    move?" the first time the robot is commanded anywhere. After a Home the cams
    sit at 46 deg (STAND_POSE_DEG), 4.6x the tolerance, so restarting the web UI
    on a parked robot refused a healthy calibration every time. Measured live with
    zero_epoch 27 in perfect health: rig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
    [calibration.py, daemon.py, paths.py, server.py, test_blackbox.py, test_pose_anchor.py, test_thermal_api.py, test_ws_grid_js.py]
2026-09-23 webui: the sweep you trace is the region you get, and the pen works again
    THE PEN AND THE FLOOD FILL. setupWsCanvas wired its buttons with a run of bare
    $("id").onclick assignments. Adding two new ones put them ahead of the tool
    buttons, so on a page where those elements are missing -- a browser holding a
    cached index.html against a newer app.js is enough -- the first one threw and
    every handler after it was never attached. wsEd.tool then stayed "pan" for the
    rest of the session and the pen and the flood fill silently did nothing, which
    is a miserable thing to discover while holding the leg. The tool buttons are
    wired first now and everything optional goes through on(), which tolerates a
    mis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
    [calibrate_workspace.py, server.py, test_workspace_region.py, uiproc.py, workspace.py]
2026-09-23 webui: a per-joint trim on the standing pose
    STAND_POSE_DEG is solved from CAD and is right for a robot whose zero is
    right. When a joint is zeroed a degree or two out, or one hip simply sits
    differently, the whole pose is off and there was nothing to turn but the
    balance loop -- which is the wrong tool for a static offset, and on this robot
    was not working anyway (ki had been set to 0, which kills the only channel that
    levels the torso; the loop itself checks out).
    Six sliders, one per motor, +-20 deg, with the same step arrows and readout the
    CoM trim next to them already has. Saved on the robot and re-clipped on load,
    so a hand-edited settings file cannot smuggle in a 90 deg trim.
    Every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
    [daemon.py, server.py, test_joint_trim.py]
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2026-09-24 BalanceRL: a push-recovery stander that writes the MIT frame, and its v3 deploy path
    The policy stands still and gets shoved. It emits the force-control frame directly -- a position
    target, Kp and Kd per joint, every 10 ms -- with NO torque feed-forward, because the drives' torque
    span is unidentified (mit.py rule 2) and a wrong span rescales torque with no error anywhere.
    Robust to a +-3 cm whole-robot CoM shift and to the walker's full measurement chain.
    WHAT THIS PLANT IS, measured before believing any of it (README "What this plant actually is"):
    the stance is PASSIVELY stable (the zero action stands 32/32 for 6 s), the standing basin is only
    +-0.02 rad of commanded thigh, cancelling a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
    [bundle.py, config.py, controller_balance.py, daemon.py, drive.py, env.py, export.py, make_plant.py]
2026-09-30 Remove the stale code: the analytic gait demo, the MJCF viewer, the URDF patchers, seven old bundles
    Nothing deployed imports any of it. The web UI and controller/deploy keep every module
    they load (trajectory, play_trajectory, record_trajectory, calibrate_workspace,
    joint_limits); the v1 deploy path stays because the daemon still imports it.
    Bundles: only bal5_s0 (the shipped stander) and dash_joy3_lr_s2_180M (the best walker)
    remain in controller/deploy/bundles.
    The root README described training/ and robot/, which no longer exist; rewritten for
    the tree as it is.
    [batch_update_urdf.py, debug_axes.py, gait.py, gaitstore.py, patch_urdf_axes_from_mujoco.py, patch_urdf_axes_from_mujoco_text.py, patch_urdf_from_results.py]
2026-09-30 webui: name the approach band test and pin both of its ends
    The "distance outside the rest..command band" rule was written out twice in the
    approach tick. It is now approach_miss(), and test_approach_band.py pins the two
    cases that have each failed before: a leg resting under full weight and a leg
    carrying nothing have both arrived.
    [daemon.py, test_approach_band.py]
